jarifalamclaude-max/DUBURI_IVC/sim/results/rx_spectrogram.png

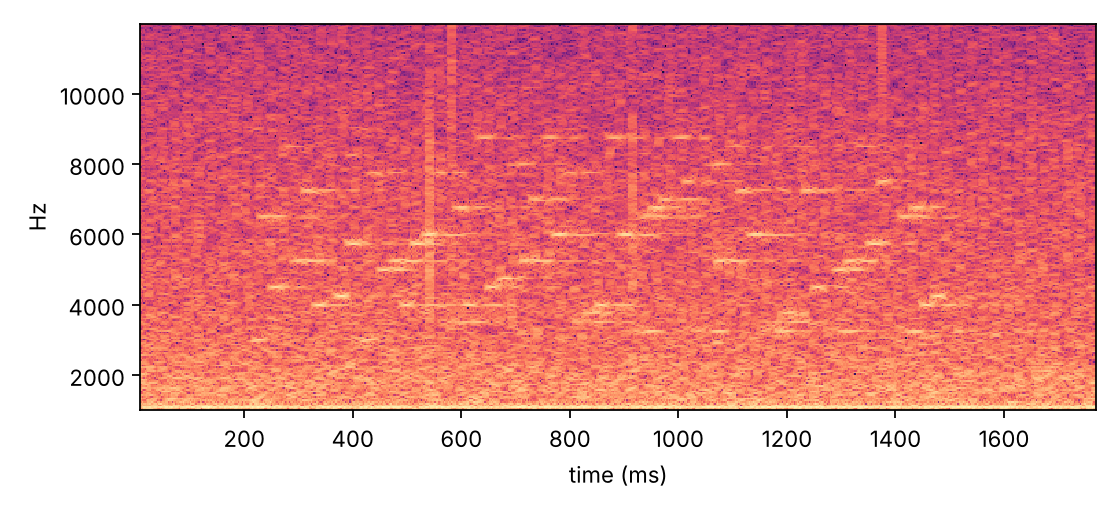
sim/results/rx_spectrogram.png
