jarifalamclaude-max/DUBURI_IVC/docs/guide_bn.html

DUBURI IVC

পানির নিচে দুই ROV-এর মধ্যে শব্দ দিয়ে যোগাযোগ

Acoustic Inter-Vehicle Communication: পুরো গাইড, A থেকে Z.
কেন এভাবে করা হলো, সব formula, circuit, speaker গরম হওয়ার কারণ ও সমাধান, piezo hydrophone seal করার নিয়ম, pool-এর noise filtering, ESP32-এর পুরো code আর তার ব্যাখ্যা, test করার নিয়ম আর সমস্যা হলে কী করবে।

Hardware: ESP32 + PAM8403 class-D amp + car speaker (TX) | piezo disc + op-amp preamp (RX)
Firmware: Arduino-ESP32 core 3.x (3.3.12-এ compile করে দেখা)
সব code: github.com/jarifalamclaude-max/DUBURI_IVC

## সূচিপত্র

1 এক নজরে পুরো সিস্টেম

2 পানিতে শব্দ: যা জানা দরকার

3 সিস্টেমের block diagram

4 কী কী লাগবে (BOM ও আনুমানিক দাম)

5 Power supply ও grounding

6 Transmitter circuit (ESP32 → amp → speaker)

7 Speaker গরম হচ্ছে কেন, আর সমাধান

8 Speaker box: পানিতে শব্দ বের করা

9 Piezo hydrophone: বানানো ও seal করা

10 Receiver preamp circuit

11 Noise filtering: তিন স্তর

12 Signal design: tone, slot, hopping

13 Packet, CRC, error correction

14 Receiver কীভাবে decode করে (ধাপে ধাপে)

15 Firmware: install, upload, ব্যবহার

16 Code-এর ব্যাখ্যা (function ধরে ধরে)

17 Verification: কী test করা হয়েছে

18 বানানো ও test করার ধাপ

19 Troubleshooting

20 Safety

A সব formula এক জায়গায়

B শব্দকোষ (Glossary)

C পুরো source code

## 1. এক নজরে পুরো সিস্টেম

একটা ROV (sender) একটা ছোট "packet" পাঠায়। Packet মানে কয়েকটা byte: কাকে পাঠাচ্ছি, কে পাঠাচ্ছে, কোন command (যেমন "LED জ্বালাও"), আর command-এর একটা argument। ESP32 এই byte-গুলোকে কিছু নির্দিষ্ট frequency-র শব্দ (tone)-এ রূপান্তর করে। Car speaker সেই শব্দ পানিতে ছাড়ে। অন্য ROV-এর piezo hydrophone শব্দটা শোনে, preamp signal বড় ও পরিষ্কার করে, ESP32-এর ADC সেটা digital করে। তারপর firmware বের করে কোন tone বেজেছিল, সেখান থেকে byte ফিরিয়ে আনে, CRC দিয়ে যাচাই করে, তারপর কাজটা করে (LED জ্বলে)। চাইলে উল্টো দিকে একটা ছোট "ACK" (পেয়েছি) packet ফেরত পাঠায়।

বিষয় | মান | কেন
Modulation | 4-FSK + frequency hopping | সহজ, amplitude-এর উপর নির্ভর করে না, echo-র মধ্যেও কাজ করে
Tone | 24টা, 3000–8750 Hz, 250 Hz পরপর | car speaker ও piezo এই band-এ ভালো কাজ করে; pump noise (নিচে) আর RoboSub pinger (25–40 kHz) এড়ায়
Slot | 20 ms, প্রতি slot-এ একটা tone = 2 bit | যথেষ্ট লম্বা যাতে echo-র মধ্যেও tone চেনা যায়
Packet দৈর্ঘ্য | 64 slot = 1.28 s (preamble 0.2 s + data 1.08 s) | command পাঠানোর জন্য যথেষ্ট দ্রুত
Payload | 4 byte (dst, src, seq+flags, cmd, arg) + CRC-16 | "LED on"-এর মতো command-এর জন্য যথেষ্ট
Error correction | Convolutional code K=7, rate 1/2 + Viterbi | যে bit ভুল আসে সেগুলো ঠিক করে ফেলে
Receiver ADC | ESP32 ADC1, DMA, 50 kHz | কোনো CPU সময় নষ্ট না করে sample নেয়
দূরত্ব (লক্ষ্য) | 10–25 m, RoboSub-এর মতো pool | —
Simulation-এ ফল | in-band SNR −6 dB-এ 90%, 0 dB-এ 100% packet ঠিক | অধ্যায় 17

Speaker গরম হওয়ার সংক্ষিপ্ত উত্তর (বিস্তারিত অধ্যায় 7): transistor বা L298N দিয়ে speaker-এর এক মাথা GND-এ রেখে on/off করলে অর্ধেক power DC হয়ে যায়। এতে শব্দ হয় না, শুধু coil গরম হয়। সমাধান হলো BTL class-D amplifier (PAM8403), amp-এর input-এ filter আর volume control, আর firmware-এর "heat guard" যা speaker-কে কাজের পর বিশ্রাম দেয়।

Piezo seal করলে শব্দ ধরবে কি না (বিস্তারিত অধ্যায় 9): ধরবে। Epoxy, silicone, তেল, এদের "acoustic impedance" পানির কাছাকাছি, তাই শব্দ প্রায় পুরোটাই ভেতরে ঢোকে (৮৫–৯৯%)। শব্দ আটকায় শুধু বাতাস (০.১%-এর মতো ঢোকে)। তাই নিয়ম একটাই: piezo আর পানির মাঝে কোনো air bubble বা ফাঁকা জায়গা থাকবে না।

## 2. পানিতে শব্দ: যা জানা দরকার

### 2.1 Radio কেন চলে না, শব্দ কেন চলে

পানি, বিশেষ করে chlorine দেওয়া pool-এর পানি, বিদ্যুৎ পরিবাহী। তাই WiFi বা Bluetooth-এর মতো radio wave কয়েক সেন্টিমিটারের মধ্যেই শেষ হয়ে যায়। শব্দ উল্টো: পানিতে বাতাসের চেয়ে প্রায় ৪.৫ গুণ দ্রুত যায় আর অনেক কম ক্ষয় হয়। তাই পানির নিচে যোগাযোগের প্রধান উপায় হলো শব্দ (acoustic)।

c ≈ 1480 – 1500 m/s (পানিতে শব্দের গতি; বাতাসে 343 m/s) λ = c / f λ = wavelength। উদাহরণ: f = 5000 Hz হলে λ = 1480/5000 ≈ 0.30 m। এই সংখ্যাটা পরে লাগবে। যেকোনো জিনিস λ-এর তুলনায় অনেক পাতলা হলে (যেমন 2–3 mm epoxy) শব্দ সেটা প্রায় টেরই পায় না।

t = d / c শব্দ পৌঁছাতে কত সময় লাগে। 25 m হলে t = 25/1480 ≈ 17 ms। এটা একটা slot (20 ms)-এর চেয়ে কম, কিন্তু pool-এর দেয়ালে ধাক্কা খেয়ে আসা echo আসে আরো অনেক পরে (৫০–৩০০ ms পর্যন্ত)।

### 2.2 Pool-এর সবচেয়ে বড় সমস্যা: echo (reverberation)

Pool-এর দেয়াল আর মেঝে টাইলস বা কংক্রিটের, আর পানির উপরিতল প্রায় আয়নার মতো শব্দ ফেরত দেয়। তাই একটা tone বাজালে receiver সেটা একবার না, শত শত বার শোনে, প্রতিটা আলাদা দেরিতে আর আলাদা phase-এ। দুটো খারাপ ফল হয়:

1. Fading: কোনো জায়গায় কোনো একটা frequency-র echo-গুলো একে অপরকে কেটে দেয়, ফলে সেই tone খুব দুর্বল শোনায়। অন্য frequency আবার ঠিক থাকে।
2. Inter-symbol interference: আগের slot-এর tone-এর echo পরের slot-এও বাজতে থাকে।

আমাদের design-এর প্রায় প্রতিটা সিদ্ধান্ত এই দুটো সমস্যা ঠেকানোর জন্য: frequency hopping (অধ্যায় 12), interleaving আর convolutional code (অধ্যায় 13)। নিচের চিত্রে simulation-এর pool model-এ echo-র শক্তি কত দ্রুত কমে, সেটা দেখানো হয়েছে।



চিত্র 2.1: 50×25×5 m pool model-এ echo-র অবশিষ্ট শক্তি। একই frequency set আবার ব্যবহার করার আগে 120 ms অপেক্ষা করা হয়, ততক্ষণে echo অনেকটা কমে যায়।

### 2.3 RoboSub-এ বিশেষ সতর্কতা

RoboSub-এ acoustic pinger থাকে, যার frequency সাধারণত 25–40 kHz। আমাদের tone 3–8.75 kHz, অর্থাৎ অনেক নিচে। তার উপর ADC-র sampling rate 50 kHz নেওয়া হয়েছে যাতে pinger-এর শব্দ "alias" হয়ে আমাদের band-এ ঢুকে না পড়ে (অধ্যায় 11.2-এ formula)। Thruster আর pool pump-এর বেশিরভাগ শব্দ 2–3 kHz-এর নিচে থাকে, তাই আমাদের band সেটাও এড়িয়ে যায়।

### 2.4 Doppler: ROV চললে frequency সরে কি?

Δf = f · v / c v = দুই ROV-এর আপেক্ষিক গতি। v = 0.5 m/s আর f = 8750 Hz হলে Δf = 8750 × 0.5 / 1480 ≈ 3 Hz। আমাদের receiver-এর frequency resolution 62.5 Hz আর tone 250 Hz পরপর, তাই 3 Hz কোনো সমস্যা না।

## 3. সিস্টেমের block diagram

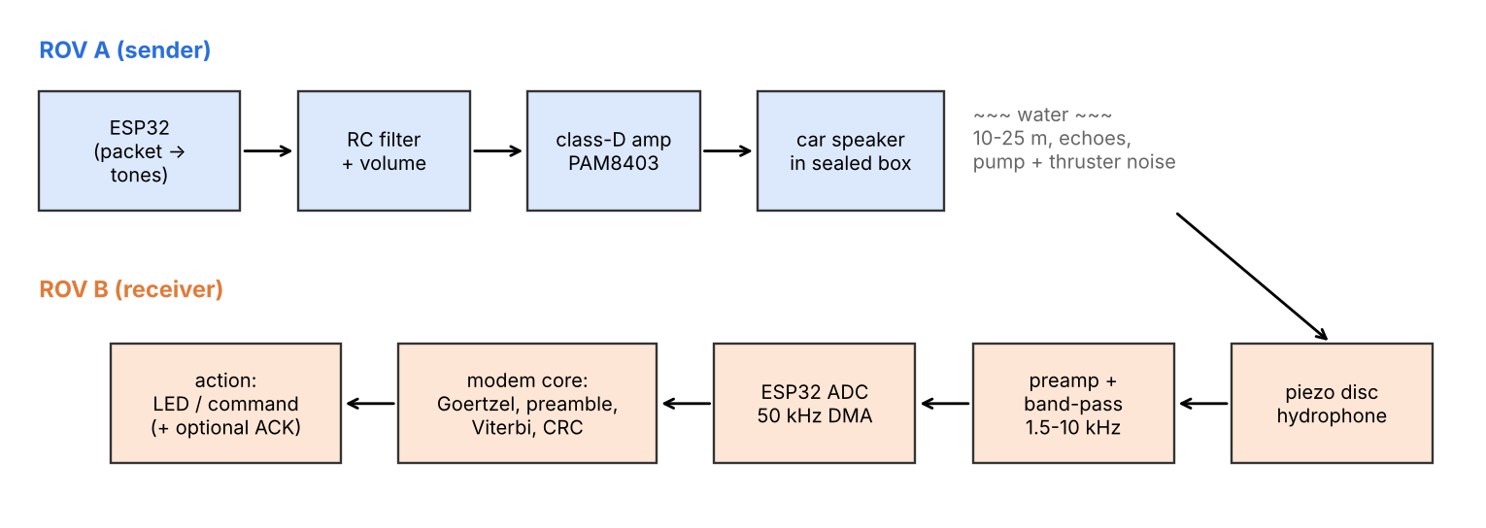
[picture p2: docs/figures/block_diagram.png]


চিত্র 3.1: উপরে sender, নিচে receiver। দুই ROV-এ একই hardware থাকলে দুজনেই পাঠাতে ও শুনতে পারে (ACK-এর জন্য)।

Sender-এর কাজ: packet → bit → error-correction code → interleave → প্রতি 2 bit-এ একটা tone → ESP32-এর LEDC peripheral দিয়ে square wave → RC filter দিয়ে মসৃণ করা ও volume ঠিক করা → PAM8403 amp → speaker → box-এর পাতলা জানালা → পানি।

Receiver-এর কাজ: piezo → preamp (gain + 1.5–10 kHz band-pass) → ESP32 ADC (DMA, 50 kHz) → DC সরানো → Goertzel দিয়ে 24টা tone-এর শক্তি মাপা → noise floor দিয়ে ভাগ (whitening) → preamble খোঁজা → timing ঠিক করা → প্রতি slot-এর soft bit → de-interleave → Viterbi → CRC check → command চালানো।

একটা গুরুত্বপূর্ণ design সিদ্ধান্ত: modem-এর মূল code (am_core.c) সাধারণ C-তে লেখা, এতে ESP32-এর কিছু নেই। তাই একই file PC-তে compile করে test আর simulation চালানো গেছে। PC-তে যেটা test হয়েছে, ঠিক সেটাই ROV-এ চলে।

## 4. কী কী লাগবে (BOM ও আনুমানিক দাম)

প্রতিটা ROV-এর জন্য (দুটো ROV-এ দুই সেট)। দাম বাংলাদেশের সাধারণ অনলাইন বা দোকানের আনুমানিক দাম, দোকানভেদে কমবেশি হবে।

জিনিস | সংখ্যা | আনুমানিক দাম (৳) | মন্তব্য
ESP32 DevKit V1 (WROOM-32) | 1 | 450–650 | Uno-র চেয়ে সস্তা, অনেক দ্রুত, DMA ADC আছে
PAM8403 class-D amp module | 1 | 60–120 | 5 V, 3 W×2, BTL output
(বিকল্প) PAM8610 amp module | (1) | 250–400 | 12 V, বেশি জোর লাগলে; heat sink লাগবে
Car speaker (আছে) | 1 | — | 4 Ω
Piezo disc 27 mm বা 35 mm | 2–3 | 10–20 প্রতিটা | একটা নষ্ট হলে বদলানোর জন্য বাড়তি রাখো
MCP6002 op-amp (না পেলে LM358) | 1 | 40–80 (LM358: 10–15) | dual op-amp, DIP-8
Buck converter (LM2596 বা MP1584) | 2 | 80–150 প্রতিটা | একটা ESP32-এর, একটা amp-এর
Trimmer pot 10 kΩ, 100 kΩ | 1 + 1 | 10–20 প্রতিটা | volume ও gain
Resistor, capacitor (তালিকা অধ্যায় 6, 10) | — | 100–150 | film/ceramic cap
Shielded cable (2-core বা mic cable) | 1–2 m | 30–60/m | hydrophone-এর জন্য
2-part epoxy বা liquid electrical tape | 1 | 150–300 | piezo seal
Acrylic sheet 3–5 mm (speaker জানালা) | ছোট টুকরা | 100–200 | অধ্যায় 8
Perfboard, header, fuse, তার | — | 100–150 | —

কেন Uno না: Uno-র RAM 2 KB, clock 16 MHz, ADC দ্রুত হলে noisy হয়, আর DMA নেই। ESP32-এ 520 KB RAM, 240 MHz, float FPU আর DMA দিয়ে 50 kHz ADC sampling আছে, আর দামও Uno clone-এর মতো বা কম। আমাদের receiver প্রতি সেকেন্ডে প্রায় ৮০ লাখ গুণ-যোগ করে, যা Uno-তে সম্ভব না।

## 5. Power supply ও grounding



চিত্র 5.1: দুটো আলাদা buck converter। Amp-এর supply-তে ferrite/inductor আর 1000 µF।

- দুটো buck কেন: amp প্রতিবার tone বাজানোর সময় হঠাৎ ১ A-এর মতো current টানে। একই 5 V থেকে ESP32 চললে voltage নেমে ESP32 reset হতে পারে (brownout), আর preamp-এ শব্দ (noise) ঢোকে।
- Ferrite + 1000 µF: একটা LC low-pass filter। Amp-এর switching noise buck-এ ফিরতে দেয় না, আর হঠাৎ current-এর সময় capacitor থেকে charge যোগায়।
- Star ground: সব GND তার একটা বিন্দুতে (battery −) মিলবে। Thruster-এর বড় current যেন preamp-এর GND তারের মধ্য দিয়ে না যায়।
- Preamp-এর supply: ESP32-এর 3V3 থেকে 10 Ω + 100 µF দিয়ে আলাদা করে "3V3A" (অধ্যায় 10)।

I_battery ≈ P_out / (η · V_battery) Buck converter-এর input current। η = efficiency (≈ 0.85)। উদাহরণ: amp 5 V-এ 1 A টানলে (5 W), 14.8 V battery থেকে লাগে 5 / (0.85 × 14.8) ≈ 0.4 A। তাই 3 A fuse যথেষ্ট।

f_LC = 1 / (2π √(L·C)) 10 µH আর 1000 µF হলে f ≈ 1.6 kHz। এর উপরের buck switching noise (সাধারণত 150 kHz+) অনেকটা কেটে যায়।

## 6. Transmitter circuit (ESP32 → amp → speaker)



চিত্র 6.1: Transmitter। ESP32-এর GPIO25 থেকে square wave → RC filter → volume → PAM8403 → speaker।

### 6.1 প্রতিটা অংশ কী করে

- GPIO25 (LEDC): ESP32-এর LEDC peripheral hardware দিয়েই নির্দিষ্ট frequency-র square wave বানায় (0 V আর 3.3 V-এর মধ্যে)। CPU কিছু করে না, তাই tone একদম স্থির থাকে। প্রতি 20 ms পরপর firmware শুধু frequency বদলে দেয়।
- R1 + C1 (low-pass filter): square wave-এর ধারালো কিনারা কেটে নরম করে, উঁচু harmonic কমায়।
- C2 (1 µF): DC আটকায়। Amp শুধু AC পায়, এটা heat কমানোর জন্যও জরুরি (অধ্যায় 7)।
- RV1 (10 kΩ trimmer): volume। ESP32-এর 2.1 V peak signal amp-এর জন্য অনেক বেশি, ফলে amp clip করত। Clip মানে output square wave, যা বেশি গরম করে।
- PAM8403: class-D, BTL (bridge-tied load) amp, ~৯০% efficient। নিজে প্রায় গরম হয় না।

### 6.2 Formula ও হিসাব

square wave (0…V) = V/2 + (2V/π)·[sin ωt + (1/3)sin 3ωt + (1/5)sin 5ωt + …] Fourier series। প্রথম অংশ V/2 হলো DC। আসল tone (fundamental)-এর amplitude 2V/π; ESP32-এ V = 3.3 V হলে 2.10 V peak। শুধু বিজোড় harmonic (3f, 5f, …) থাকে। আমাদের সবচেয়ে নিচের tone 3000 Hz-এর 3f = 9000 Hz, যা সবচেয়ে উঁচু tone 8750 Hz-এর উপরে। তাই harmonic কখনো অন্য tone-এর জায়গায় পড়ে না।

f_c = 1 / (2π · R_th · C1), R_th = R1 ∥ RV1 = (4.7k × 10k)/(4.7k + 10k) = 3.2 kΩ f_c = 1 / (2π × 3.2 kΩ × 3.3 nF) ≈ 15 kHz Low-pass corner। 15 kHz-এর নিচের (আমাদের tone) প্রায় পুরোটা যায়, উপরের harmonic কমে।

gain_divider = RV1 / (R1 + RV1) = 10 / 14.7 = 0.68 → RV1-এর মাথায় 2.10 × 0.68 ≈ 1.43 V peak f_HP = 1 / (2π (R1 + RV1) C2) = 1 / (2π × 14.7 kΩ × 1 µF) ≈ 11 Hz C2 শুধু DC আটকায়। 11 Hz-এর উপরের সব কিছু (আমাদের tone) সহজে যায়।

PAM8403 gain ≈ 24 dB = ×15.8, BTL max peak ≈ V_supply = 5 V P_sine = V_peak² / (2 R) = 5² / (2 × 4) ≈ 3.1 W (clip হওয়ার ঠিক আগে) V_in দরকার = V_out / gain = 4 V / 15.8 ≈ 0.25 V peak → RV1 প্রায় 18% ঘুরানো তাই RV1 একদম নিচ থেকে শুরু করবে, আস্তে আস্তে বাড়াবে। যেখানে শব্দ আর বাড়ে না, বরং কর্কশ হয়, সেখানে clip শুরু; তার একটু নিচে রাখবে। 4 V peak হলে 4²/(2×4) = 2 W।

BTL সতর্কতা: PAM8403/PAM8610-এর output-এর দুই পাশেই signal থাকে (একটা উঠলে অন্যটা নামে)। Speaker-এর কোনো তার কখনো GND-এ লাগাবে না, আর দুটো channel-এর OUT− একসাথে জোড়া দেবে না। দিলে amp-এর output short হয়ে amp গরম হবে বা পুড়ে যাবে। Speaker-এর দুই তার শুধু L+ আর L−-এ যাবে।

### 6.3 বেশি জোর লাগলে: PAM8610

PAM8403 যথেষ্ট না হলে (scope-এ q < 10 dB, অধ্যায় 18) PAM8610 module 12 V buck থেকে চালাও। এতে 12 V BTL, অর্থাৎ max ≈ 12²/(2×4) = 18 W (তাত্ত্বিক)। কিন্তু মনে রাখো, power বাড়লে heat-ও বাড়ে। প্রথমে gain বাড়াও, transducer coupling ঠিক করো (অধ্যায় 8), তারপর power। PAM8610-এ heat sink লাগাবে। Module-এ MUTE/SD pin থাকলে PIN_AMP_ENABLE দিয়ে ESP32 শুধু পাঠানোর সময় amp চালু রাখবে।

## 7. Speaker গরম হচ্ছে কেন, আর সমাধান

Speaker-এর voice coil আসলে একটা তামার তারের কুণ্ডলী, যার resistance R (car speaker-এ ~3.2–4 Ω)। Coil-এ যত electrical power যায়, তার প্রায় পুরোটাই (৯৯%-এর বেশি) তাপ হয়। শব্দ হয় খুব সামান্য (speaker-এর efficiency ~১%)। তাই প্রশ্ন হলো, coil-এ অদরকারি power কোথা থেকে আসছে।

### 7.1 কারণ 1 (সবচেয়ে সাধারণ): DC current

অনেকে speaker-এর এক মাথা GND-এ রেখে transistor/MOSFET বা L298N-এর এক অংশ দিয়ে 0 আর V-এর মধ্যে on/off করে। এই signal-এর গড় মান V/2, মানে coil-এ একটা স্থায়ী DC current চলে। DC-তে cone একপাশে ঠেলে থেমে থাকে, কোনো শব্দ হয় না, কিন্তু I²R তাপ হয়।

P_total = d · V² / R (d = duty cycle = 0.5) P_DC = (d·V)² / R ← শুধু তাপ, কোনো শব্দ নয় P_tone = (2V/π)² / (2R) ← কাজের অংশ 12 V, 4 Ω হলে P_total = 0.5 × 144 / 4 = 18 W, P_DC = 36/4 = 9 W, P_tone = 7.3 W, বাকি 1.7 W harmonic। অর্থাৎ অর্ধেক power সরাসরি তাপ। Box বন্ধ থাকলে এই তাপ বের হওয়ারও জায়গা পায় না।

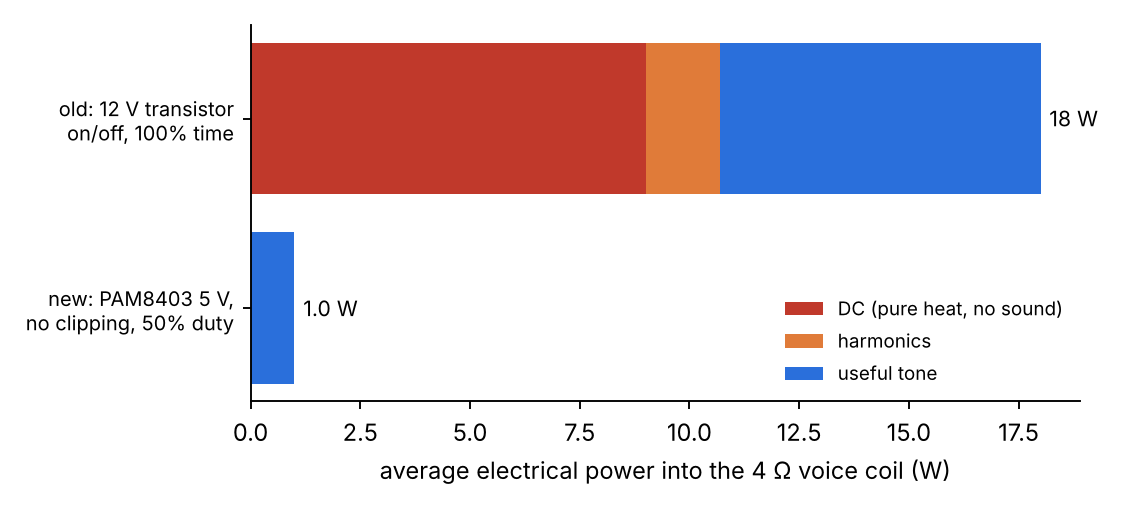
[picture p3: docs/figures/heat_power.png]


চিত্র 7.1: পুরনো পদ্ধতি বনাম নতুন। নতুন পদ্ধতিতে গড় power প্রায় ১৮ ভাগের এক ভাগ।

### 7.2 কারণ 2: সারাক্ষণ বাজানো (100% duty)

Tone একটানা বাজালে coil ঠান্ডা হওয়ার সময় পায় না। আমাদের packet মাত্র 1.28 s। Firmware-এর heat guard প্রতিবার পাঠানোর পর বাধ্যতামূলক বিশ্রাম দেয়:

t_rest = t_on · (1 − d) / d P_avg = P_on · d d = MAX_TX_DUTY (config.h, default 0.5)। 1.28 s packet-এর পর অন্তত 1.28 s চুপ। P_on = 2 W হলে গড় 1 W। Speaker-এর rating সাধারণত 20–50 W, তাই এটা খুবই নিরাপদ।

### 7.3 কারণ 3: Amp clip করা

Input বেশি হলে amp-এর output square হয়ে যায় (clipping)। একই peak voltage-এ square wave-এর power sine-এর দ্বিগুণ (V²/R বনাম V²/2R), আর বাড়তি অংশটা harmonic, যা কাজে লাগে না। RV1 দিয়ে clip-এর নিচে রাখো।

### 7.4 কারণ 4: ভুল driver

L298N-এর ভেতরে transistor-এ 2–3 V voltage drop হয়। 1.5 A-তে সেটা 3–4.5 W, যা শুধু L298N-কে গরম করে। সাথে চলে উপরের DC সমস্যা। Class-D amp-এর efficiency ~৯০%, তাই এই সমস্যা থাকে না।

### 7.5 কারণ 5: বন্ধ box, তাপ বের হওয়ার পথ নেই

ΔT = P_avg × R_th R_th = thermal resistance (°C/W): প্রতি watt-এ তাপমাত্রা কত বাড়ে। বাতাস ভালো insulator, তাই বন্ধ box-এ R_th অনেক বেশি। উদাহরণ (ধরে নেওয়া মান): R_th = 10 °C/W হলে পুরনো পদ্ধতির 9 W DC → 90 °C বেশি! নতুন পদ্ধতির 1 W → 10 °C। সমাধান: speaker-এর magnet থেকে একটা aluminium পাত box-এর দেয়াল পর্যন্ত লাগাও (চিত্র 8.1)। দেয়ালের ওপাশে পানি খুব ভালো ঠান্ডা করে।

### 7.6 Coil-এর তাপমাত্রা নিজে মাপার উপায়

R(T) = R₀ (1 + α ΔT), α_copper = 0.00393 /°C ΔT = (R_hot / R_cold − 1) / 0.00393 Multimeter দিয়ে speaker-এর resistance ঠান্ডা অবস্থায় মাপো (ধরো 3.4 Ω)। কিছুক্ষণ চালিয়ে amp খুলে সাথে সাথে আবার মাপো (ধরো 4.1 Ω)। তাহলে ΔT = (4.1/3.4 − 1)/0.00393 ≈ 52 °C। 60–70 °C-এর বেশি বাড়লে MAX_TX_DUTY বা volume কমাও।

Checklist: (1) class-D BTL amp, speaker GND-এ নয়; (2) C2 দিয়ে DC block; (3) RV1-এ clip-এর নিচে; (4) MAX_TX_DUTY 0.5 বা কম; (5) magnet থেকে দেয়ালে তাপের পথ; (6) R মেপে তাপমাত্রা দেখা।

## 8. Speaker box: পানিতে শব্দ বের করা

Speaker বন্ধ box-এ আছে। Cone নড়লে box-এর ভেতরের বাতাস নড়ে, বাতাস box-এর দেয়াল নাড়ায়, দেয়াল পানি নাড়ায়। বাতাস আর পানির মধ্যে impedance-এর বিশাল পার্থক্য (অধ্যায় 9.1), তাই এখানেই সবচেয়ে বেশি শক্তি হারায়। উপায় হলো দেয়ালের একটা অংশকে হালকা ও পাতলা "জানালা" বানানো, যা নিজে drum-এর মতো কাঁপে।

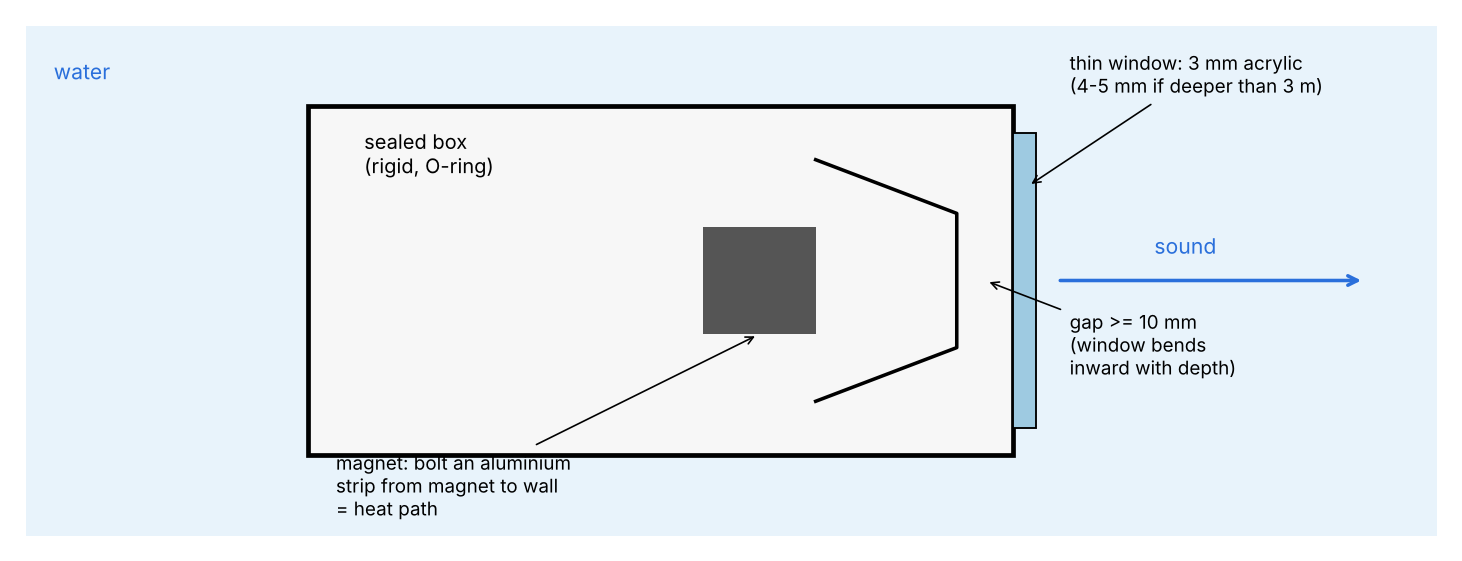
[picture p4: docs/figures/speaker_box.png]


চিত্র 8.1: Speaker-এর মুখ পাতলা acrylic জানালার দিকে, মাঝে ফাঁক, magnet থেকে দেয়াল পর্যন্ত তাপের পথ।

- Speaker-এর মুখ একটা পাতলা, শক্ত জানালার দিকে রাখো (3 mm acrylic/polycarbonate)। জানালা যত পাতলা আর হালকা, তত ভালো শব্দ যায়, কিন্তু গভীরতায় চাপ সহ্য করতে হবে (নিচের formula)।
- Cone আর জানালার মাঝে অন্তত 10 mm ফাঁক রাখো, কারণ গভীরে জানালা ভেতরে বাঁকে।
- Box-এর বাকি দেয়াল মোটা আর শক্ত রাখো, O-ring দিয়ে seal করো।
- (Advanced) পুরো box তেলে ভরে rubber diaphragm দিলে coupling আর cooling দুটোই অনেক ভালো হয়। কিন্তু এটা বানানো কঠিন, তেল চুঁইয়ে পড়ার ঝুঁকি আছে, আর cone তেলে ভিজে যায়। প্রথম version-এ এটা কোরো না।
- (বিকল্প পরীক্ষা) একটা piezo disc-কেও speaker হিসেবে চালানো যায় (amp-এর output সরাসরি piezo-তে)। 3–6 kHz-এ পানিতে এটা ভালো কাজ করে। Car speaker-এর সাথে তুলনা করতে পারো।

### 8.1 গভীরতায় চাপ ও জানালার পুরুত্ব

P = ρ · g · h 5 m গভীরে P = 1000 × 9.81 × 5 ≈ 49 kPa (≈ 0.49 bar)। জানালার প্রতি বর্গ সেন্টিমিটারে প্রায় 0.5 kg-এর ভার।

D = E t³ / (12 (1 − ν²)) w_max = P a⁴ / (64 D) (কিনারা আটকানো গোল plate-এর মাঝখানে কতটা বাঁকে) σ_max = 3 P a² / (4 t²) (সবচেয়ে বেশি stress, কিনারায়) a = জানালার ব্যাসার্ধ, t = পুরুত্ব। Acrylic: E ≈ 3 GPa, ν ≈ 0.37, tensile strength ≈ 70 MPa।
উদাহরণ, 5 m গভীরে: 10 cm জানালা (a = 5 cm), t = 3 mm → w ≈ 0.6 mm, σ ≈ 10 MPa (safety factor ≈ 7) ✔।
15 cm জানালা (a = 7.5 cm), t = 3 mm → w ≈ 3.1 mm, σ ≈ 23 MPa (safety factor ≈ 3, একটু বেশি বাঁকে)। t = 5 mm হলে w ≈ 0.7 mm, σ ≈ 8 MPa ✔। তাই 3 m-এর বেশি গভীরে বড় জানালার জন্য 4–5 mm নাও। এগুলো মোটামুটি হিসাব (ছোট deflection ধরে), পানিতে নামানোর আগে বালতি বা অগভীর পানিতে leak test করবে।

## 9. Piezo hydrophone: বানানো ও seal করা

### 9.1 Seal করলে শব্দ ঢুকবে কেন (physics)

শব্দ হলো চাপের ঢেউ। এক পদার্থ থেকে অন্য পদার্থে ঢোকার সময় কতটা ঢুকবে আর কতটা ফেরত যাবে, সেটা নির্ভর করে দুই পদার্থের acoustic impedance-এর উপর:

Z = ρ · c (ঘনত্ব × শব্দের গতি, একক Rayl) T = 4 Z₁ Z₂ / (Z₁ + Z₂)² (কত ভাগ শক্তি ঢোকে) পানি Z ≈ 1.48 MRayl। Epoxy ≈ 3.0 → T ≈ 0.89 (৮৯% ঢোকে)। Silicone rubber ≈ 1.05 → T ≈ 0.97। Mineral/baby oil ≈ 1.2 → T ≈ 0.99। বাতাস ≈ 0.0004 → T ≈ 0.001 (০.১%!)।
তাই কোটিং কোনো সমস্যা না, সমস্যা শুধু বাতাস। আর কোটিং যেহেতু wavelength (5 kHz-এ 300 mm)-এর তুলনায় খুব পাতলা (2–3 mm), শব্দ তার মধ্য দিয়ে প্রায় না থেমে চলে যায়।

### 9.2 Piezo disc কীভাবে শব্দ ধরে

Piezo disc-এ একটা পিতলের (brass) প্লেটের উপর পাতলা ceramic লাগানো থাকে। চাপ পড়ে ceramic একটু বাঁকলে তার দুই পাশে voltage তৈরি হয় (piezoelectric effect)। পানির চাপের ঢেউ disc-কে বাঁকায়, তাই disc থেকে millivolt মাপের signal আসে। Disc বৈদ্যুতিকভাবে একটা ছোট capacitor-এর মতো (প্রায় 10–30 nF), তাই এর পরে high-impedance input (1 MΩ) লাগে।

### 9.3 বানানোর ধাপ

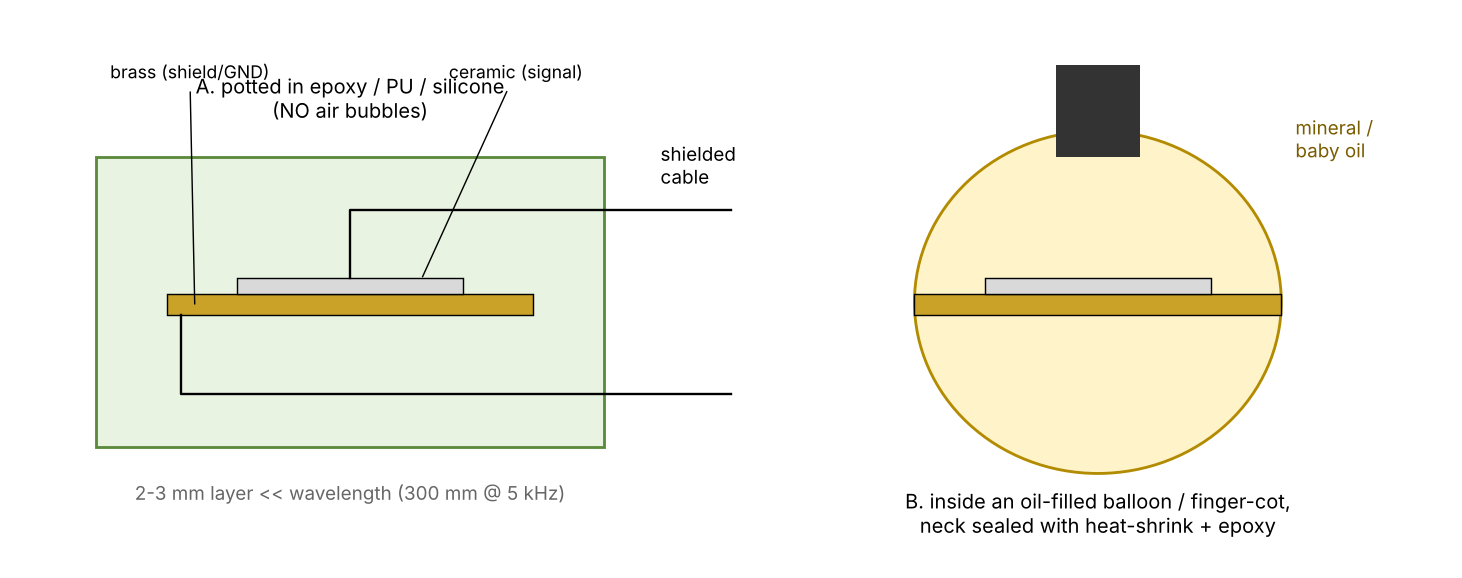
[picture p5: docs/figures/hydrophone_build.png]


চিত্র 9.1: দুটো পদ্ধতি। A: epoxy/silicone-এ ডুবানো (potting)। B: তেলভর্তি balloon/finger-cot।

1. Cable: shielded cable (mic cable)। ভেতরের তার ceramic (রুপালি) অংশে, shield/braid brass-এর কিনারায়। Ceramic-এ খুব দ্রুত (২–৩ সেকেন্ড) solder করো, বেশি তাপে রুপালি স্তর উঠে যায়।
2. পরিষ্কার: isopropyl alcohol দিয়ে তেল আর flux মুছে ফেলো, শুকাতে দাও।
3. Strain relief: cable-কে disc-এর কাছে একটু গিঁট দিয়ে বা heat-shrink দিয়ে আটকে দাও, যাতে টান solder-এ না পড়ে।
4. পদ্ধতি A (epoxy/silicone potting): একটা ছোট ছাঁচে (বোতলের ছিপি, PVC end cap) disc দাঁড় করিয়ে রাখো। 2-part epoxy ধীরে ধীরে এক কোণ থেকে ঢালো, যাতে বাতাস বের হয়ে যেতে পারে। Disc-এর দুই পাশে 2–3 mm স্তর রাখো। Bubble দেখলে টুথপিক দিয়ে ফাটিয়ে দাও। হালকা গরম জায়গায় (hair dryer দূর থেকে) রাখলে epoxy পাতলা হয় আর bubble সহজে ওঠে। পুরো ২৪ ঘণ্টা শুকাতে দাও। সস্তা বিকল্প: liquid electrical tape / Plasti Dip-এ ৩–৪ বার ডুবিয়ে পাতলা স্তর, প্রতিবার শুকিয়ে নিয়ে। Hot glue-ও চলে, কিন্তু bubble থাকার সম্ভাবনা বেশি।
5. পদ্ধতি B (তেল): finger-cot বা ছোট balloon-এ baby/mineral oil ভরে disc ডোবাও। Bubble বের করে দাও, তারপর মুখটা cable-এর উপর heat-shrink + epoxy দিয়ে বন্ধ করো। তেল খুব ভালো impedance match, আর disc-এর উপর কোনো শক্ত স্তর না থাকায় disc সবচেয়ে ভালো বাঁকে।
6. Cable-এর মুখ seal: cable যেখানে বের হচ্ছে সেখানে epoxy বা adhesive heat-shrink, যাতে পানি তারের ভেতর দিয়ে না ঢোকে।
7. পরীক্ষা: বালতির পানিতে রেখে বালতির গায়ে টোকা দাও, firmware-এর scope-এ level লাফালে ঠিক আছে। একদিন পানিতে রেখে দেখো multimeter-এ disc-এর দুই তারের মধ্যে resistance অসীম আছে কি না (leak নেই)।

Mounting: hydrophone-কে ROV-এর frame থেকে নরম রাবার বা foam দিয়ে আলাদা করে লাগাও, thruster থেকে যত দূরে সম্ভব। Frame-এর মধ্য দিয়ে motor-এর কম্পন সরাসরি piezo-তে গেলে noise অনেক বাড়ে। নিজের speaker-এর box থেকেও দূরে রাখো।

"Speaker-এর receiver"-এর ব্যাপারে: একটা speaker-কেও উল্টো দিকে microphone হিসেবে ব্যবহার করা যায়, কিন্তু বন্ধ box-এর ভেতরে থাকলে পানির শব্দ খুব কম পৌঁছায় (বাতাসের ফাঁকের কারণে, 9.1)। Piezo সরাসরি পানির সংস্পর্শে থাকে, তাই অনেক ভালো। Receiver হিসেবে piezo-ই ব্যবহার করো।

## 10. Receiver preamp circuit



চিত্র 10.1: দুই stage-এর non-inverting band-pass amplifier, তারপর anti-alias RC, তারপর ESP32 GPIO34।



চিত্র 10.2: Preamp-এর পরিষ্কার supply (3V3A) আর VREF (≈1.34 V)।

### 10.1 কেন এই circuit

- Piezo-র signal খুব ছোট (mV)। ESP32-এর ADC-তে ভালো করে মাপতে হলে কয়েকশো mV লাগে। তাই মোট gain 30–63 dB (৩০ থেকে ১৪০০ গুণ)।
- Single supply (শুধু 3.3 V) দিয়ে AC signal amplify করতে হলে signal-কে একটা মাঝামাঝি voltage (VREF)-এর উপর বসাতে হয়, যাতে signal উপরে-নিচে দুই দিকেই দুলতে পারে। Rb (1 MΩ) সেটা করে।
- Rg-Cg দিয়ে DC gain = 1 রাখা হয়েছে, তাই output-এর DC = VREF থাকে, gain বাড়ালেও DC সরে না।
- প্রতি stage নিজেই band-pass: নিচে Cg (pump hum কাটে), উপরে Cf (pinger ও ESC noise কাটে)।
- Ro-Caa: ADC-র আগে শেষ low-pass (anti-alias), আর op-amp-কে ADC-র input থেকে রক্ষা করে।

### 10.2 Formula ও মান

VREF = 3.3 × 6.8k / (10k + 6.8k) = 1.34 V কেন 1.65 V (মাঝখান) না: ESP32 ADC (12 dB attenuation) প্রায় 0.15–2.45 V-এ সবচেয়ে সোজা (linear) মাপে। তার মাঝখান ≈ 1.3 V, দুই দিকে ±1.1 V জায়গা থাকে।

G = 1 + Rf / Rg (non-inverting gain) Stage 1: G₁ = 1 + 100k/3.3k = 31.3 (29.9 dB) Stage 2: G₂ = 1 + RV2/2.2k = 1 … 46.5 (0 … 33 dB, RV2 দিয়ে বদলানো যায়) মোট: 30 dB … 63 dB

f_HP = 1/(2π Rg Cg): stage 1 → 1/(2π·3.3k·33n) = 1.46 kHz; stage 2 → 1/(2π·2.2k·47n) = 1.54 kHz f_LP = 1/(2π Rf Cf): stage 1 → 1/(2π·100k·150p) = 10.6 kHz; stage 2 → 1/(2π·100k·100p) = 15.9 kHz (RV2 max) Anti-alias: 1/(2π·3.3k·4.7n) = 10.3 kHz Input HP: 1/(2π · Rb · (Cin ∥series C_piezo)) ≈ 10 Hz ফলে 3–8.75 kHz-এর tone পুরো gain পায়। 100 Hz pump hum প্রায় 45 dB কমে, 35 kHz pinger প্রায় 27 dB কমে (চিত্র 10.3)।

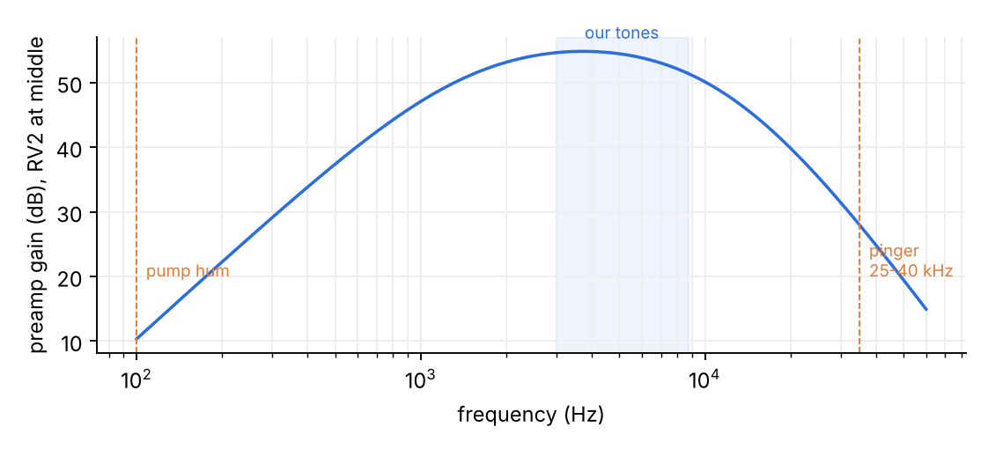
[picture p6: docs/figures/preamp_response.png]


চিত্র 10.3: Preamp-এর frequency response (RV2 মাঝামাঝি)। নীল অংশে আমাদের tone।

GBW ≥ G × f_max = 46.5 × 10 kHz ≈ 0.47 MHz Op-amp-এর gain-bandwidth product। MCP6002 = 1 MHz ✔। LM358 ≈ 0.7–1 MHz, চলবে।

### 10.3 Op-amp বাছাই ও pin

| MCP6002 (ভালো) | LM358 (বিকল্প)
Supply | 3V3A (3.3 V) | 5 V (3.3 V-এ output 1.8 V-এর উপরে উঠতে পারে না)
Output swing | rail-to-rail (0–3.3 V) | 0 থেকে Vcc−1.5 V
Pin | দুটোরই pin এক: 1 = OUT A, 2 = −IN A, 3 = +IN A, 4 = GND, 5 = +IN B, 6 = −IN B, 7 = OUT B, 8 = V+

LM358 5 V-এ চালালে output 3.5 V পর্যন্ত যেতে পারে। Ro (3.3 kΩ) current সীমিত রাখে, তাই ESP32-এর pin নিরাপদ থাকে। তবুও MCP6002 পেলে সেটাই ব্যবহার করো। Pin 8 আর pin 4-এর মধ্যে যত কাছে সম্ভব 100 nF লাগাও।

GPIO34 কেন: ESP32-এর DMA ADC শুধু ADC1-এ (GPIO32–39) কাজ করে। GPIO34 শুধু input pin, এতে কোনো internal pull-up নেই, তাই analog-এর জন্য একদম ঠিক।

## 11. Noise filtering: তিন স্তর

Noise-এর উৎস | কেমন | কোন স্তরে আটকায়
Pool pump/filter | নিচু frequency (<1–2 kHz), 100 Hz hum | Band choice + preamp HP
Thruster (প্রপেলার) | সব frequency জুড়ে, ঢেউয়ের মতো ওঠানামা | Narrowband Goertzel + whitening + code
ESC/motor whine | একটা নির্দিষ্ট tone (যেমন 8 kHz) | Per-tone noise floor (whitening)
টোকা, ধাক্কা (click) | খুব ছোট কিন্তু জোরালো | Interleaving + Viterbi
RoboSub pinger | 25–40 kHz, 4 ms pulse | Preamp LP + Fs = 50 kHz (alias বাইরে পড়ে)
Echo (reverberation) | নিজের signal-এর দেরিতে আসা কপি | Frequency hopping + interleaving + code
বিদ্যুতের noise (buck, ESC) | তারে ঢোকা | Shielded cable, star ground, আলাদা buck, LC filter

### 11.1 স্তর 1: Hardware

Preamp band-pass (অধ্যায় 10), anti-alias RC, shielded cable (shield শুধু preamp-এর GND-এ, এক প্রান্তে), আলাদা power, hydrophone-কে frame থেকে কম্পন-বিচ্ছিন্ন রাখা।

### 11.2 স্তর 2: Sampling আর aliasing

Fs > 2 · f_max (Nyquist) f_alias = | f − k · Fs | (k = সবচেয়ে কাছের পূর্ণসংখ্যা) ADC Fs-এর অর্ধেকের উপরের frequency ধরতে পারে না, সেগুলো ভুল করে নিচের frequency হিসেবে দেখা দেয় (alias)। Fs = 50 kHz হলে 35 kHz pinger → |35 − 50| = 15 kHz, আমাদের band (3–8.75 kHz)-এর বাইরে ✔। Fs = 40 kHz হলে একই pinger → 5 kHz, ঠিক আমাদের tone-এর উপর ✘। তাই 50 kHz বেছে নেওয়া হয়েছে। Band-এ alias হয়ে ঢুকতে পারে শুধু 41.25–47 kHz-এর শব্দ, যা preamp ~31–33 dB কমিয়ে দেয়।

### 11.3 স্তর 3: Software (DSP)

- Goertzel (narrowband filter): প্রতিটা tone-এর জন্য মাত্র ~94 Hz চওড়া একটা "জানালা" দিয়ে শোনে। 6 kHz band-এর noise-এর মাত্র 94/6000 ভাগ ঢোকে। এটাই processing gain:

PG = 10 log₁₀(B_band / B_bin) = 10 log₁₀(6000 / 94) ≈ 18 dB তাই wideband SNR −6 dB হলেও প্রতি tone-এ ~১০ dB SNR পাওয়া যায় (Hann window আর echo-র ক্ষতি বাদ দিয়ে)।

- Whitening (per-tone noise floor): প্রতিটা tone-এর জন্য আলাদা noise floor মনে রাখা হয়। কোনো tone-এর জায়গায় সবসময় একটা whine থাকলে সেই tone-এর floor বেড়ে যায়, তাই whine আর "জয়ী" হয় না (অধ্যায় 14.3)।
- Ratio-ভিত্তিক সিদ্ধান্ত: কোন tone বেজেছে, সেটা নির্ধারণ হয় চারটা tone-এর মধ্যে তুলনা করে, কোনো fixed threshold দিয়ে না। তাই signal জোরে বা আস্তে, যাই আসুক, কাজ করে।

### 11.4 স্তর 4: Protocol

- Frequency hopping: পরপর slot আলাদা frequency set ব্যবহার করে। ফলে আগের slot-এর echo পরের slot-এর হিসাবে ঢোকে না।
- Interleaving + convolutional code: একটা slot নষ্ট হলে বা একটা frequency fade করলে মাত্র কয়েকটা ছড়ানো bit ভুল হয়, Viterbi সেগুলো ঠিক করে ফেলে।
- CRC-16: ভুল packet প্রায় কখনো পাস করে না (৬৫৫৩৬-এ ১)।
- ACK + retry: উত্তর না এলে firmware নিজেই আবার পাঠায় (৩ বার পর্যন্ত)।

## 12. Signal design: tone, slot, hopping

### 12.1 Tone-এর তালিকা

f_k = 3000 + 250 · k Hz, k = 0 … 23 → 3000, 3250, …, 8750 Hz

### 12.2 কেন 250 Hz পরপর, কেন 16 ms window

N = Fs × T_win = 50000 × 0.016 = 800 sample Δf_bin = Fs / N = 50000 / 800 = 62.5 Hz 250 Hz = 4 × 62.5 Hz → প্রতিটা tone ঠিক একটা "bin"-এর উপর, পাশাপাশি tone-এর মধ্যে 4 bin ফাঁক একই window-এ পূর্ণসংখ্যক bin দূরের দুটো tone একে অপরকে "দেখে" না (orthogonal)। 4 bin ফাঁক থাকায় ADC-র clock একটু ভুল হলেও (±1–2%) বা Hann window দিলেও tone মিশে যায় না।

### 12.3 Slot আর window

প্রতিটা slot 20 ms, কিন্তু receiver মাঝের 16 ms (800 sample) দেখে। দুই পাশে 2 ms করে margin থাকে, যাতে timing একটু এদিক-ওদিক হলেও পাশের slot ঢুকে না পড়ে।

### 12.4 Frequency hopping set

set s = { s, s+6, s+12, s+18 }, s = 0 … 5 slot i ব্যবহার করে set (i mod 6); 2 bit মান v (0–3) → tone = s + 6v উদাহরণ: set 0 = {3000, 4500, 6000, 7500 Hz}, set 1 = {3250, 4750, 6250, 7750 Hz}। একই set আবার আসে 6 slot = 120 ms পরে, ততক্ষণে আগের echo অনেক কমে যায় (চিত্র 2.1)। Set-এর ভেতরে tone-গুলো 1500 Hz দূরে, তাই কোনো এক জায়গার fading একসাথে চারটাকে নষ্ট করে না।



চিত্র 12.1: একটা packet-এর সময়-frequency নকশা। কমলা = preamble (10 slot), নীল = data (54 slot)।



চিত্র 12.2: Virtual pool-এ (echo + pump + thruster + pinger, SNR 0 dB) ADC যা দেখে তার spectrogram।

### 12.5 Preamble

Preamble হলো 10টা আলাদা tone-এর একটা নির্দিষ্ট ক্রম: 3000, 6500, 4500, 8500, 5250, 7250, 4000, 8250, 4250, 5750 Hz। Receiver সারাক্ষণ এই ক্রমটা খোঁজে। এটা বেছে নেওয়া হয়েছে তিনটা নিয়ম মেনে (code-এ test আছে):

1. পাশাপাশি slot-এর tone অনেক দূরে, যাতে একটার echo পরেরটার মতো না শোনায়।
2. অন্য packet-এর data কোনোভাবেই 10টার মধ্যে 2টার বেশি slot মেলাতে পারে না, তাই data দেখে ভুল করে "packet শুরু" ধরে নেওয়া হয় না।
3. Preamble-এর কোনো tone-এর set, সেই packet-এর data অন্তত 6 slot (120 ms) পরে ব্যবহার করে। Simulation-এ প্রথম version-এ এই নিয়ম ছিল না, তখন preamble-এর echo প্রথম data slot নষ্ট করছিল। এটা ধরা পড়ার পর ঠিক করা হয়েছে।

### 12.6 Data rate

raw = 2 bit / 20 ms = 100 bit/s; code rate ½ → 50 bit/s একটা packet = 64 slot × 20 ms = 1.28 s, এতে 4 byte payload (32 bit) → কার্যকর ≈ 25 bit/s কম মনে হতে পারে, কিন্তু "LED on", "start mission 3", "আমি gate পার হয়েছি" জাতীয় command-এর জন্য যথেষ্ট, আর echo-ভর্তি pool-এ নির্ভরযোগ্যতা অনেক বেশি জরুরি।

## 13. Packet, CRC, error correction

### 13.1 Packet-এর গঠন (6 byte)

Byte | বিট 7–4 | বিট 3–0
0 | dst (কাকে, 15 = সবাইকে) | src (কে পাঠাল)
1 | seq (0–15, repeat চেনার জন্য) | flags: 8 = ACK চাই, 4 = এটা ACK
2 | cmd (0–255): 1 = LED on, 2 = LED off, 3 = toggle, 4 = ping, 10–255 তোমার নিজের
3 | arg (0–255)
4–5 | CRC-16 (byte 0–3-এর উপর)

### 13.2 CRC-16

g(x) = x¹⁶ + x¹² + x⁵ + 1 (0x1021), শুরুর মান 0xFFFF ("CRC-16/CCITT-FALSE") Data-কে একটা বড় binary সংখ্যা ধরে g(x) দিয়ে ভাগ করলে যে ভাগশেষ থাকে, সেটাই CRC। Receiver নিজে আবার হিসাব করে মেলায়। এক-দুই bit ভুল সবসময় ধরা পড়ে, এলোমেলো ভুল ধরা পড়ে 65535/65536 বার। পরীক্ষার মান: "123456789" → 0x29B1 (unit test-এ যাচাই করা)।

### 13.3 Convolutional code (K = 7, rate ½)

48 bit (6 byte)-এর পরে 6টা শূন্য ("tail") যোগ করে 54 bit বানানো হয়। প্রতিটা bit একটা 7-ঘরের shift register-এ ঢোকে, আর প্রতি bit-এ 2টা output bit বের হয়:

reg = [নতুন bit, আগের 6 bit] out₀ = parity(reg AND 1111001₂) (171 octal) out₁ = parity(reg AND 1011011₂) (133 octal) parity = কয়টা 1 আছে তা বিজোড় হলে 1। প্রতিটা output bit আগের 7টা input bit-এর উপর নির্ভর করে, তাই তথ্য অনেকগুলো coded bit-এ ছড়িয়ে থাকে। এই code-এর "free distance" 10: দুটো আলাদা message-এর coded রূপ কমপক্ষে 10টা bit-এ আলাদা। তাই কাছাকাছি নয় এমন অনেক ভুল ঠিক করা যায়। এটা NASA আর Wi-Fi-তে ব্যবহৃত বিখ্যাত code। প্রথমে Hamming(8,4) code দিয়ে design করা হয়েছিল। Simulation-এ দেখা গেল convolutional code একই noise-এ অনেক বেশি packet ঠিক আনে (−6 dB-এ ২৫% থেকে ৯০%+), তাই এটা বেছে নেওয়া হয়েছে।

### 13.4 Interleaver

slot(c) = (37 · c) mod 54; c < 54 হলে MSB, নাহলে LSB c = coded bit-এর নম্বর (0–107)। পাশাপাশি coded bit (যেগুলো Viterbi-র একসাথে লাগে) অন্তত 3 slot দূরে আর আলাদা frequency set-এ যায়। ফলে একটা ঝাঁকুনি (click) বা একটা faded frequency শুধু ছড়ানো কয়েকটা bit নষ্ট করে, যা Viterbi সবচেয়ে ভালো ঠিক করতে পারে।

## 14. Receiver কীভাবে decode করে (ধাপে ধাপে)

### 14.1 DC সরানো

dc ← dc + (x − dc) / 1024; y = x − dc f_c ≈ Fs / (2π · 1024) = 50000 / 6434 ≈ 7.8 Hz ADC-র sample-এ VREF (≈1600 count)-এর DC থাকে। এই এক লাইনের high-pass filter সেটা সরায়।

### 14.2 Goertzel: একটা tone-এর শক্তি মাপা

w[n] = 0.5 − 0.5 cos(2π (n + 0.5) / N) (Hann window) coef = 2 cos(2π f / Fs) s[n] = x[n]·w[n] + coef · s[n−1] − s[n−2] E = s[N−1]² + s[N−2]² − coef · s[N−1] · s[N−2] Goertzel হলো FFT-এর একটা মাত্র bin হিসাব করার সস্তা উপায়: প্রতি sample-এ একটা গুণ আর দুটো যোগ। আমাদের শুধু 24টা frequency দরকার, পুরো FFT লাগে না। Hann window কিনারাগুলো নরম করে দেয়, তাই পাশের tone-এর "leakage" কমে (Fs একটু ভুল হলেও)।

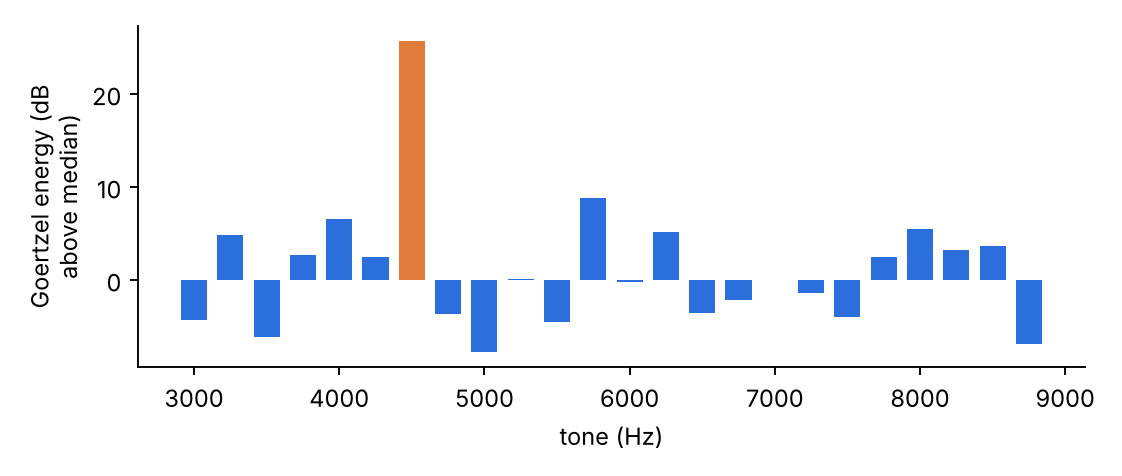
[picture p7: docs/figures/goertzel_demo.png]


চিত্র 14.1: 4500 Hz tone + noise-এর উপর 24টা Goertzel। কমলা bin স্পষ্ট জয়ী।

### 14.3 Whitening: প্রতিটা tone-এর নিজস্ব noise floor

N_k ← N_k + (min(E_k, 8·N_k) − N_k) / 256 (প্রতি 2.5 ms) z_k = E_k / N_k SNR_k ≈ z_k − 1, q = 10 log₁₀(z − 1) dB N_k হলো tone k-এর গড় noise (exponential moving average, সময় ধ্রুবক 256 × 2.5 ms = 0.64 s)। শুধু packet না থাকার সময় শেখে। "min(…, 8N)" মানে হঠাৎ জোরালো শব্দ (click বা নিজের signal) floor-কে বেশি টেনে তুলতে পারে না। z_k বলে tone k তার স্বাভাবিক noise-এর কত গুণ। ধ্রুব whine থাকলে N_k বড় হয়ে যায়, ফলে whine-এর z ≈ 1 থাকে। Firmware যে q print করে, সেটা এই SNR-এর median।

### 14.4 Preamble খোঁজা

প্রতি 2.5 ms (H = 125 sample) পরপর শেষ 16 ms-এর 24টা z হিসাব হয়। প্রতিটা preamble slot j-এর tone p_j কতটা "জয়ী", তা ভাগ হিসেবে মাপা হয়:

frac_j(t) = z_{p_j}(t) / Σ_k z_k(t) score(t) = (1/10) Σ_{j=0..9} frac_j( t − (9 − j)·T_slot ) match(t) = কয়টা j-তে p_j-ই 24টার মধ্যে সবচেয়ে জোরালো শর্ত: score ≥ 0.14 এবং match ≥ 5 শুধু noise থাকলে প্রতি frac ≈ 1/24 ≈ 0.04, তাই score ≈ 0.04। Preamble থাকলে score 0.3–0.9। ভাগ ব্যবহার করায় পুরো band-জুড়ে হঠাৎ শব্দ (click) এলে সব z একসাথে বাড়ে, score বাড়ে না। দুই শর্ত একসাথে থাকায় 10 মিনিটের কঠিন noise-এ একবারও ভুল trigger হয়নি (অধ্যায় 17)।

### 14.5 Timing ঠিক করা

Score-এর চূড়া একটু চ্যাপ্টা (window slot-এর চেয়ে ছোট বলে)। Trigger-এর পরে আরো 14টা hop (35 ms)-এর score রাখা হয়। তারপর চূড়ার 85%-এর উপরের অংশের ভারকেন্দ্র (centroid) নেওয়া হয়:

c = Σ i · (score_i − 0.7·max) / Σ (score_i − 0.7·max) data slot i-এর window শেষ হয়: e_i = sync + (i + 1) · S, S = Fs × 0.020

Data চলার সময় early/late gate timing-কে আস্তে আস্তে ঠিক রাখে। জয়ী tone-এর শক্তি 1 ms আগের ও পরের window-এ মাপা হয়, আর যেদিকে বেশি সেদিকে একটু সরানো হয়:

err = (E_late − E_early) / (E_late + E_early); adj ← adj + 0.25 · D · err (D = 1 ms, সীমা ±5 ms)

### 14.6 ADC-র আসল sample rate মাপা

Fs_measured = (মোট sample সংখ্যা) / (সময়, µs) × 10⁶ timing ভুল = (Fs ভুল) × packet দৈর্ঘ্য ESP32-এর ADC ঠিক 50000 না, একটু কম-বেশি দেয়। 1% ভুল হলে 1.28 s packet-এর শেষে timing 12.8 ms সরে যায়, যা slot-এর margin (2 ms)-এর অনেক বেশি। তাই firmware চলার সময় ক্রমাগত sample গোনে আর ESP32-এর নিজের µs timer-এর সাথে তুলনা করে। সময় যত বাড়ে, মাপ তত নিখুঁত হয় (20 s পরে ≈0.05% → packet-এর শেষে 0.6 ms)। Simulation-এ ADC-কে ইচ্ছা করে 2.4% দ্রুত চালিয়ে test করা হয়েছে।

### 14.7 Soft bit (LLR)

L_MSB = max(ln z₀, ln z₁) − max(ln z₂, ln z₃) L_LSB = max(ln z₀, ln z₂) − max(ln z₁, ln z₃) L > 0 মানে bit সম্ভবত 0, L < 0 মানে 1, আর |L| যত বড় তত নিশ্চিত। শুধু 0/1 না দিয়ে কতটা নিশ্চিত সেটাও Viterbi-কে দেওয়া হয় ("soft decision")। এতে hard decision-এর চেয়ে প্রায় 2 dB বেশি noise সহ্য হয়।

### 14.8 Viterbi decoding

PM_new(s′) = max over predecessor s of [ PM(s) + (±L₀) + (±L₁) ] 64টা সম্ভাব্য register অবস্থার প্রতিটার জন্য এখন পর্যন্ত সবচেয়ে মানানসই পথটা মনে রাখা হয় (PM = path metric)। প্রত্যাশিত bit 0 হলে +L, 1 হলে −L যোগ হয়। শেষে tail-এর কারণে অবস্থা 0-তে শেষ হওয়া পথটা পিছন দিকে (traceback) পড়ে 54 bit ফিরে পাওয়া যায়। এটাই maximum-likelihood decoding: যে message সবচেয়ে সম্ভাব্য, সেটাই বের হয়।

### 14.9 CRC আর কাজ

প্রথম 48 bit থেকে 6 byte বানিয়ে CRC মেলানো হয়। মিললে packet queue-তে যায়, main loop LED জ্বালায় বা নিভায়, দরকার হলে ACK পাঠায়। আর একই (src, seq) 15 s-এর মধ্যে আবার এলে command দ্বিতীয়বার চালানো হয় না (repeat), কিন্তু ACK আবার পাঠানো হয়, কারণ আগের ACK হয়তো হারিয়ে গিয়েছিল।

## 15. Firmware: install, upload, ব্যবহার

### 15.1 Install

1. Arduino IDE 2.x install করো।
2. File → Preferences → "Additional boards manager URLs"-এ বসাও: https://espressif.github.io/arduino-esp32/package_esp32_index.json
3. Tools → Board → Boards Manager → "esp32 by Espressif Systems" version 3.x install করো (3.3.12-এ compile করে দেখা হয়েছে; 2.x চলবে না, code নিজেই error দেবে)।
4. Repository-র firmware/DuburiModem folder খোলো (DuburiModem.ino)। একই folder-এ am_core.c, am_core.h, config.h থাকতে হবে।
5. Tools → Board → "ESP32 Dev Module"। কোনো বাড়তি library লাগে না।
6. config.h-এ NODE_ID বসাও: প্রথম ROV-এ 1, দ্বিতীয়টায় 2। আর PEER_ID-এ অন্যটার ID।
7. Upload। Serial Monitor: 115200 baud, line ending "Newline"।

### 15.2 Serial command

Command | কাজ
on [id] / off [id] / toggle [id] | id-এর ROV-এর LED জ্বালাও/নিভাও/উল্টাও (id না দিলে PEER_ID, 15 = সবাই)
ping [id] | উত্তর চায়; উত্তরের q দিয়ে link কেমন বোঝা যায়
send C A [id] | নিজের command C (0–255) আর argument A পাঠাও
sweep | 24টা tone একটা একটা করে 0.3 s বাজায় (frequency response test)
tone F MS | F Hz, MS millisecond বাজাও
scope | প্রতি 0.25 s-এ 24টা tone-এর whitened level (dB) দেখায় (আবার লিখলে বন্ধ)
stats | কয়টা preamble, কয়টা ঠিক, কয়টা CRC fail, ADC-র মাপা Fs, level, clipping
BOOT button | PEER_ID-কে "toggle" পাঠায় (laptop ছাড়াই test)

### 15.3 Output-এর format (main computer-এর জন্য)

TX to=2 seq=3 cmd=1 arg=0 (try 1/3)
RX src=1 dst=2 seq=3 cmd=1 arg=0 flags=8 q=14.2dB      ← receiver-এ
TX ack to=1 seq=3
ACK src=2 seq=3 cmd=1 state=1 q=12.8dB                  ← sender-এ
OK delivered to 2 (try 1)

Jetson বা Raspberry Pi একই USB serial port থেকে এগুলো পড়তে আর command লিখতে পারে। Python উদাহরণ:

import serial                                  # pip install pyserial
s = serial.Serial("/dev/ttyUSB0", 115200, timeout=0.1)
s.write(b"send 10 3 2\n")                       # ROV 2-কে command 10, argument 3
while True:
    line = s.readline().decode(errors="ignore").strip()
    if line.startswith("RX "):
        f = dict(kv.split("=") for kv in line.split()[1:])
        print("command", f["cmd"], "from", f["src"], "quality", f["q"])

### 15.4 নিজের command যোগ করা

DuburiModem.ino-তে enum { CMD_LED_ON = 1, … }-এ নতুন নাম দাও (10–255), তারপর handlePacket()-এর switch (p.cmd)-এ case লেখো। পাঠানোর জন্য sendCommand(dst, CMD_X, arg) বা serial-এ send।

## 16. Code-এর ব্যাখ্যা (function ধরে ধরে)

### 16.1 File-এর ভাগ

File | কী আছে
config.h | শুধু এটাই সাধারণত বদলাতে হয়: ID, pin, ACK, retry, heat guard
am_core.h / am_core.c | Modem-এর মস্তিষ্ক, সাধারণ C, ESP32-এর কিছু নেই। একই file PC test-এ চলে।
DuburiModem.ino | ESP32-এর অংশ: ADC DMA, LEDC tone, FreeRTOS task, serial command, LED, ACK
tests/test_core.c | PC-তে unit test (CRC, code, interleaver, loopback, noise)
sim/pool_sim.py, run_sim.py | Virtual pool, আসল C code চালিয়ে ফল আর graph
docs/ | এই PDF-এর উৎস, চিত্র, font

### 16.2 am_core.c

- am_tone_hz(k): f = 3000 + 250k।
- am_crc16(): bit ধরে ধরে CRC হিসাব (13.2)।
- am_conv_encode(): 7-ঘরের register, দুটো parity (13.3)।
- am_viterbi(): 64 state, প্রতি step-এ প্রতি state-এর দুটো আগের state থেকে ভালোটা বাছা, শেষে traceback (14.8)। dec[t]-এর প্রতিটা bit বলে কোন আগের state বাছা হয়েছিল।
- am_interleave(c): slot = 37c mod 54 (13.4)।
- am_pack()/am_unpack(): packet ↔ 6 byte, CRC বসানো/মেলানো।
- am_tx_build(): packet → bit → code → interleave → 64টা tone নম্বর (প্রথম 10টা preamble)।
- rx_configure(): Fs থেকে W (800), H (125), D (50), S (1000), Hann window, Goertzel coef, preamble offset।
- am_rx_process(): প্রতি sample-এ clipping গোনা, DC সরানো, ring buffer-এ রাখা। পরের "event"-এর সময় হলে rx_hop() (খোঁজা) বা rx_decode_slot() (data) ডাকা।
- rx_energies(): ring buffer থেকে W sample নিয়ে window গুণ করে, যতগুলো tone দরকার তাদের Goertzel।
- rx_hop(): 24 tone-এর E, noise floor update, z, frac, score, match। Trigger হলে PEAK অবস্থা।
- rx_finish_peak(): চূড়ার centroid → sync সময়, DECODE অবস্থা শুরু।
- rx_decode_slot(): slot-এর set-এর 4টা tone, z, LLR, quality, early/late।
- rx_finish_packet(): de-interleave, Viterbi, byte, CRC, quality median, queue-তে রাখা, আবার খোঁজা শুরু।
- am_rx_mute(): নিজে পাঠানোর সময় শোনা বন্ধ (নিজের জোরালো শব্দ যেন ভুল কিছু না ঘটায়)।
- am_rx_set_fs(): মাপা Fs বসানো, শুধু খোঁজার অবস্থায় (packet চলার মাঝে না)।

### 16.3 DuburiModem.ino

- startAdc(): ESP-IDF-এর adc_continuous driver। GPIO34 → ADC1 channel, 12 dB attenuation, 50 kHz, DMA frame 512 sample, overflow হলে গোনা হয়।
- rxTask() (core 0, priority 5): DMA থেকে sample পড়া, level মাপা, mutex নিয়ে am_rx_process(), packet হলে queue-তে পাঠানো। প্রতি 2 s-এ Fs মাপা আর দরকার হলে বসানো।
- playTones(): heat guard, RX mute, amp চালু, তারপর প্রতি slot-এ ledcWriteTone()। সময় মাপা হয় esp_timer (µs) দিয়ে, প্রতি slot-এর শেষ "absolute" সময়ে, তাই drift জমে না।
- heatGuard()/heatGuardUpdate(): 7.2-এর formula।
- sendCommand(): seq বাড়ানো, পাঠানো, ACK-এর জন্য 2.6 s অপেক্ষা, না এলে আবার (মোট 3 বার)।
- handlePacket(): আমার জন্য কি না দেখা, ACK চেনা, repeat চেনা, command চালানো, ACK পাঠানো।
- loop(): serial line পড়া, BOOT button, scope print, packet poll।

Thread safety: modem-এর state (g_rx) দুই task ব্যবহার করে, তাই প্রতিবার mutex (g_rx_lock) নেওয়া হয়। Packet main loop-এ যায় FreeRTOS queue দিয়ে। Heavy DSP core 0-তে চলে, serial আর TX core 1-এ।

## 17. Verification: কী test করা হয়েছে

### 17.1 Compile

Firmware Arduino-ESP32 core 3.3.12 (ESP-IDF 5.5) দিয়ে "ESP32 Dev Module"-এর জন্য compile করা হয়েছে, সব warning চালু রেখে। কোনো warning বা error নেই। Flash-এর ~23% আর RAM-এর ~17% লাগে।

### 17.2 Unit test (PC-তে, make -C tests && tests/test_core)

- CRC-16-এর মান "123456789" → 0x29B1।
- Convolutional code + Viterbi: 3000 বার এলোমেলো data, 0–4টা ছড়ানো ভুল, সবই ঠিক হয়েছে। এক bit বদলালে ≥10 coded bit বদলায়।
- Interleaver একটা permutation, পাশাপাশি bit আলাদা slot আর set-এ।
- Pack/unpack 2000 packet, প্রতিটায় 1 bit উল্টালে CRC ধরে।
- Preamble-এর তিনটা নিয়ম (12.5)।
- Loopback: পরিষ্কার signal, square wave, 1-sample-করে input, ADC 1.5% দ্রুত, Fs মাপায় 0.05% ভুল, 48 kHz, প্রায় 0 dB noise।
- 60 s শুধু noise: একটাও ভুল packet নেই।

### 17.3 Virtual pool simulation

ROV-এর আসল C code-কে একটা কম্পিউটার-বানানো pool-এর signal খাওয়ানো হয়েছে। Model-এ ছিল: ESP32 LEDC-এর আসল frequency ধাপ, slot-এর সময় ±30 µs কাঁপা, RC filter, speaker-এর অজানা response (1.5–7 kHz band, এলোমেলো ±5 dB ঢেউ), 50×25×5 m pool-এ image-method echo (দেয়াল/মেঝে reflection 0.85, পানির উপরিতল −0.9), 10–25 m এলোমেলো অবস্থান, pump hum, thruster noise (ওঠানামা সহ), click, 30 kHz pinger, preamp-এর filter, ADC (2.4% দ্রুত clock, 12 bit, noise)। প্রতি বিন্দুতে 40টা packet।



চিত্র 17.1: SNR অনুযায়ী কত packet ঠিক এসেছে। SNR = ADC-তে 3–9 kHz band-এর signal power / noise power।

In-band SNR | Preamble পাওয়া গেছে | Packet একদম ঠিক | Firmware-এর q (median)

{{SNR_TABLE}}

Echo-র মাত্রা (SNR −3 dB) | ঠিক

{{REVERB_TABLE}}

Interference (SNR −3 dB) | ঠিক

{{INTF_TABLE}}

ADC clock 2.4% দ্রুত, SNR 0 dB | ঠিক

{{CLOCK_TABLE}}

False alarm: {{FA_SECONDS}} s শুধু noise (pump + thruster + 5.5 kHz whine + click + 35 kHz pinger): preamble trigger {{FA_TRIG}}, ভুল packet {{FA_PKTS}}।



চিত্র 17.2: Firmware যে q print করে বনাম আসল SNR। মাঠে q দেখে বোঝা যায় link কতটা নিরাপদ।

মাঠের নিয়ম: q ≥ 10 dB → নিশ্চিন্ত। q 7–10 dB → চলবে, কিছু retry হবে। q < 7 dB → সীমানায়, volume/gain/অবস্থান ঠিক করো। Fs-এর মাপ 1% ভুল হলে (16/20) ক্ষতি হয়, তাই firmware-এর ক্রমাগত Fs মাপা জরুরি। চালুর পর প্রথম ~10 s মাপ স্থির হতে দাও।

### 17.4 Simulation-এ পাওয়া আর ঠিক করা সমস্যা

1. Preamble-এর শেষ tone-এর echo প্রথম data slot নষ্ট করছিল। নিয়ম 3 (12.5) যোগ করে ঠিক করা হয়েছে।
2. প্রথম interleaver একটা codeword-এর সব bit একই frequency set-এ পাঠাচ্ছিল। এক frequency fade করলে পুরো codeword নষ্ট হতো। নতুন interleaver দিয়ে ঠিক করা হয়েছে।
3. Hamming(8,4)-এর বদলে convolutional code: −6 dB-এ সফলতা প্রায় ২৫% থেকে ৯০%।
4. Detection threshold 0.17 থেকে 0.14: −9 dB-এ preamble পাওয়া 75% থেকে 100%, false alarm-ও শূন্য।

### 17.5 কী test করা হয়নি (সৎভাবে)

- আসল ESP32, আসল speaker, আসল পানি। Code compile হয়েছে আর logic simulation-এ test হয়েছে, কিন্তু board-এ চালানো হয়নি। অধ্যায় 18-এর ধাপ ধরে নিজেরা test করবে।
- Car speaker-এর box থেকে পানিতে আসলে কত জোরে শব্দ যায়, আর pool-এর আসল noise কত। Simulation-এ SNR-কে চলক রাখা হয়েছে। মাঠে scope আর q দিয়ে মাপবে।
- Component-এর মান datasheet-এর সাধারণ মান থেকে, আর thermal ও plate হিসাব আনুমানিক।

এর বাইরে, আলাদা AI reviewer agent দিয়ে code, circuit আর এই document স্বাধীনভাবে যাচাই করানো হয়েছে। ফলাফল repository-র docs/VERIFICATION.md-এ আছে।

## 18. বানানো ও test করার ধাপ

### ধাপ 1: Bench (পানি ছাড়া)

1. দুটো ESP32-এ firmware দাও (NODE_ID 1 আর 2)। Serial-এ "ready" দেখাবে।
2. শুধু preamp: piezo লাগিয়ে stats দেখো। LEVEL-এর mean ≈ 1500–1800, rms ছোট (5–30)। Piezo-তে আঙুলের টোকা দিলে max লাফাবে।
3. Wire loopback: node 1-এর RV1-এর wiper থেকে signal নিয়ে 100 kΩ আর 1 kΩ-এর divider দিয়ে ১০০ ভাগের ১ ভাগ করো (wiper → 100 kΩ → বিন্দু → 1 kΩ → GND)। সেই বিন্দু থেকে node 2-এর preamp input-এ (piezo-র জায়গায়) দাও। RV2 কম রাখো। দুই board-এর GND জোড়া দাও, আর speaker খুলে রাখো। Node 1-এ on লিখলে node 2-এর LED জ্বলবে। (ACK-এর জন্য উল্টো দিকেও একই তার লাগবে। না দিলে "no reply" দেখাবে, কিন্তু LED জ্বলবে।) এতে পুরো DSP chain পানি ছাড়াই পরীক্ষা হয়।
4. Amp + speaker বাতাসে, RV1 একদম কম। tone 5000 500 দিয়ে শব্দ শোনো। আস্তে বাড়াও, কর্কশ হওয়ার আগে থামো।

### ধাপ 2: বালতি

1. Speaker box আর hydrophone বালতিতে, 30–50 cm দূরে। Volume কম।
2. RX-এ scope চালু, TX-এ sweep। কোন tone-এ level কম আসে দেখো।
3. stats-এ clipped বাড়লে RV2 (gain) কমাও। rms খুব কম হলে বাড়াও।
4. ping ১০ বার। সবগুলো OK আর q বড় (>20 dB) হওয়া উচিত।

### ধাপ 3: Pool

1. 5, 10, 15, 20, 25 m-এ প্রতিবার ২০টা ping। কয়টা OK আর q-এর মান লিখে রাখো।
2. Thruster বন্ধ আর চালু, দুইভাবেই। চালু অবস্থায় RX-এর scope-এ কোনো tone-এ স্থায়ী উঁচু level থাকলে বুঝবে সেখানে whine আছে (whitening সামলাবে, কিন্তু জেনে রাখা ভালো)।
3. প্রতি ১০ মিনিট পর speaker-এর resistance মেপে তাপমাত্রা দেখো (7.6)।
4. q < 7 dB হলে: (ক) volume একটু বাড়াও (clip না করে); (খ) hydrophone-কে thruster থেকে দূরে নাও; (গ) speaker জানালা পাতলা বা বড় করো; (ঘ) দরকার হলে PAM8610।

### ধাপ 4: ROV-এ লাগানো

- Hydrophone নিচের দিকে, frame থেকে কম্পন-বিচ্ছিন্ন। Speaker-এর জানালা খোলা পানির দিকে।
- Main computer-এর সাথে serial (15.3), অথবা শুধু BOOT button/LED দিয়ে।

## 19. Troubleshooting

লক্ষণ | সম্ভাব্য কারণ | কী করবে
Serial-এ "ADC start failed" | ভুল pin বা core 2.x | PIN_HYDROPHONE 32–39-এর একটা হতে হবে, core 3.x
preambles = 0, কিছুই আসে না | signal খুব কম, বা gain কম, বা ADC saturate | scope দেখো; stats-এ LEVEL; RV1/RV2 ঠিক করো; wire loopback দিয়ে DSP check
preambles বাড়ে কিন্তু crc_fail-ও বাড়ে | SNR সীমানায়, echo বেশি, বা clipping | q দেখো; clipped শূন্য রাখো; দূরত্ব কমিয়ে দেখো; hydrophone-এর অবস্থান বদলাও
clipped দ্রুত বাড়ে | gain বেশি বা thruster noise খুব জোরালো | RV2 কমাও; hydrophone thruster থেকে দূরে
overflows বাড়ে | CPU সময় পাচ্ছে না | loop()-এ লম্বা কাজ যোগ করোনি তো? WiFi/BT চালু করোনি তো?
fs_measured 49000–51500-এর বাইরে | ADC বা driver সমস্যা | board বদলে দেখো; issue খোলো
TX-এর সময় ESP32 reset | brownout: amp-এর current-এ voltage নামছে | আলাদা buck, 1000 µF, মোটা তার
Speaker গরম | অধ্যায় 7 | checklist 7; MAX_TX_DUTY কমাও
Amp গরম/বন্ধ হয়ে যায় | speaker-এর তার GND-এ, বা 2 Ω-এর কম load | BTL নিয়ম (6.2); একটাই 4 Ω speaker
"HEAT-GUARD wait" | খুব ঘনঘন পাঠাচ্ছ | স্বাভাবিক, speaker রক্ষা করছে
LED জ্বলে কিন্তু "no reply" | অন্য দিকের TX বা RX কাজ করছে না | উল্টো দিকে ping; দুই ROV-এ ID আলাদা কি না দেখো
একই command দুইবার কাজ করে | seq বদলে নতুন command পাঠানো হয়েছে | স্বাভাবিক; repeat-এ seq একই থাকে, তখন দ্বিতীয়বার চলে না
Hum বা ভনভন শব্দ (scope-এ সব tone উঁচু) | ground loop, unshielded cable | star ground, shield শুধু এক প্রান্তে, preamp-এর supply filter

## 20. Safety

- LiPo battery: fuse ব্যবহার করবে, short হলে আগুন লাগতে পারে। পানিতে নামানোর আগে সব সংযোগ seal করবে।
- Pool-এ মানুষ থাকলে সাধারণত শব্দ নিরাপদ মাত্রায় থাকে (কয়েক W), কিন্তু খুব কাছ থেকে কানে পানির নিচে জোরালো tone অস্বস্তিকর। Test-এর সময় ডুবুরিদের জানিয়ে রাখো।
- Speaker আর amp গরম হলে বন্ধ করো। Box খোলার আগে ঠান্ডা হতে দাও।
- Epoxy হাতে লাগলে সাবান দিয়ে ধুয়ে ফেলবে। খোলা জায়গায় কাজ করবে।
- Competition-এর নিয়মে acoustic emission-এর কোনো সীমা থাকলে (pinger task-এর সময় চুপ থাকা ইত্যাদি) সেটা মেনে চলবে। দরকার হলে firmware-এ একটা "quiet" command যোগ করো।

## A. সব formula এক জায়গায়

Formula | কোথায় লাগে | অধ্যায়
λ = c / f | wavelength, coating কতটা পাতলা | 2.1, 9.1
t = d / c | শব্দ পৌঁছানোর সময় | 2.1
Δf = f·v/c | Doppler | 2.4
I = P/(η·V) | battery current | 5
f = 1/(2π√(LC)) | supply-র LC filter | 5
x(t) = V/2 + (2V/π)Σ sin(nωt)/n | square wave-এর ভেতরে কী আছে | 6.2, 7.1
f_c = 1/(2πRC) | সব RC filter | 6.2, 10.2
R_th = R1∥R2, divider = R2/(R1+R2) | TX filter, volume | 6.2
P = V_pk²/(2R) | amp output power | 6.2
P_DC = (dV)²/R | DC-র অপচয় | 7.1
t_rest = t_on(1−d)/d | heat guard | 7.2
ΔT = P·R_th | তাপমাত্রা বৃদ্ধি | 7.5
ΔT = (R_hot/R_cold − 1)/0.00393 | coil-এর তাপ মাপা | 7.6
P = ρgh | গভীরতায় চাপ | 8.1
w = Pa⁴/(64D), σ = 3Pa²/(4t²) | জানালা কতটা বাঁকে | 8.1
Z = ρc, T = 4Z₁Z₂/(Z₁+Z₂)² | seal করলে শব্দ ঢোকে কি না | 9.1
G = 1 + Rf/Rg | op-amp gain | 10.2
GBW ≥ G·f | op-amp বাছাই | 10.2
Fs > 2f, f_alias = |f − kFs| | sampling, pinger alias | 11.2
PG = 10log(B_band/B_bin) | processing gain | 11.3
f_k = 3000 + 250k | tone | 12.1
Δf_bin = Fs/N | frequency resolution | 12.2
set = {s, s+6, s+12, s+18} | frequency hopping | 12.4
g(x) = x¹⁶+x¹²+x⁵+1 | CRC-16 | 13.2
G = (171, 133)₈, K = 7 | convolutional code | 13.3
slot = 37c mod 54 | interleaver | 13.4
dc += (x−dc)/1024 | DC blocker | 14.1
s[n] = xw + coef·s[n−1] − s[n−2] | Goertzel | 14.2
N += (min(E,8N) − N)/256 | noise floor | 14.3
score = mean frac_j | preamble detection | 14.4
err = (E_L−E_E)/(E_L+E_E) | timing tracking | 14.5
Fs = ΔN/Δt | ADC-র আসল rate | 14.6
L = max(ln z…) − max(ln z…) | soft bit | 14.7
PM′ = max(PM ± L) | Viterbi | 14.8

## B. শব্দকোষ (Glossary)

শব্দ | মানে
ADC | Analog-to-Digital Converter: voltage-কে সংখ্যায় রূপান্তর করে
DMA | Direct Memory Access: CPU ছাড়াই hardware নিজে data memory-তে রাখে
FSK | Frequency Shift Keying: তথ্য বোঝানো হয় কোন frequency বাজছে তা দিয়ে
Frequency hopping | সময়ের সাথে frequency-র set বদলানো
Slot / symbol | 20 ms-এর একটা ভাগ, যাতে একটা tone বাজে
Preamble | Packet-এর শুরুর পরিচিত নকশা, যা দিয়ে packet খুঁজে পাওয়া যায়
Goertzel | একটা নির্দিষ্ট frequency-র শক্তি মাপার দ্রুত algorithm
Window (Hann) | Signal-এর দুই কিনারা নরম করার গুণক
SNR | Signal-to-Noise Ratio, dB-তে: 10·log₁₀(P_signal/P_noise)
dB | অনুপাতের log মাপ। +3 dB ≈ ২ গুণ power, +10 dB = ১০ গুণ, +20 dB = ১০০ গুণ
Reverberation / echo | দেয়াল ও পানির উপরিতলে প্রতিফলিত শব্দ
Fading | Echo-গুলো একে অপরকে কেটে দিয়ে কোনো frequency দুর্বল হয়ে যাওয়া
CRC | ভুল ধরার check-সংখ্যা
Convolutional code / Viterbi | ভুল ঠিক করার code আর তার decoder
Interleaver | Bit-এর ক্রম এলোমেলো করে ছড়িয়ে দেওয়া
LLR / soft bit | Bit 0 না 1, আর কতটা নিশ্চিত
BTL | Bridge-Tied Load: speaker-এর দুই প্রান্তেই amp-এর output
Class-D | দ্রুত on/off switching amplifier, efficiency ~৯০%
Acoustic impedance | Z = ρc, শব্দের জন্য পদার্থের "বাধা"
Aliasing | Fs/2-এর উপরের frequency-র ভুল করে নিচে দেখা দেওয়া
Buck converter | উচ্চ voltage থেকে দক্ষভাবে নিম্ন voltage বানানোর circuit
ACK | "পেয়েছি" উত্তর

## C. পুরো source code

নিচের code repository-র file থেকে PDF বানানোর সময় সরাসরি বসানো হয়েছে, তাই হুবহু একই। নতুন version-এর জন্য সবসময় GitHub-এর code দেখবে।

{{CODE_CONFIG}} {{CODE_INO}} {{CODE_CORE_H}} {{CODE_CORE_C}}
