jarifalamclaude-max/DUBURI_IVC/docs/DUBURI_IVC_Guide.pdf

# DUBURI IVC

পা নি র নি চে | দুই ROV-এর মধ্যে | শব্দ দি য়ে | যো | গা যো | গ
Acoustic Inter-Vehicle Communication: পুরো | গা ইড, A থে কে | Z.
কে | ন এভা বে | করা হলো | , সব formula, circuit, speaker গরম হওয়া র কা রণ ও সমা ধা ন,
piezo hydrophone seal করা র নি য়ম, pool-এর noise filtering, ESP32-এর পুরো | code
আর তা র ব্যা খ্যা , test করা র নি য়ম আর সমস্যা | হলে | কী করবে ।

# Hardware: ESP32 + PAM8403 class-D amp + car speaker (TX) | piezo disc + op-

## amp preamp (RX)

# Firmware: Arduino-ESP32 core 3.x (3.3.12-এ compile করে দে খা )

# সব code: github.com/jarifalamclaude-max/DUBURI_IVC

DUBURI IVC | 2

# সূচি পত্র

1 | এক নজরে | পুরো | সি স্টে | ম
2 | পা নি তে | শব্দ: যা জা না দরকা র
3 | সি স্টে | মে র block diagram
4 | কী কী লা গবে | (BOM ও আনুমা নি ক দা ম)
5 | Power supply ও grounding
6 | Transmitter circuit (ESP32 → amp → speaker)
7 | Speaker গরম হচ্ছে | কে | ন, আর সমা ধা ন
8 | Speaker box: পা নি তে | শব্দ বে র করা
9 | Piezo hydrophone: বা না নো | ও seal করা

## 10 Receiver preamp circuit

## 11 Noise filtering: তি ন স্তর

## 12 Signal design: tone, slot, hopping

## 13 Packet, CRC, error correction

14 Receiver কী ভা বে | decode করে | (ধা পে | ধা পে )

## 15 Firmware: install, upload, ব্য বহা র

## 16 Code-এর ব্যা খ্যা (function ধরে ধরে )

## 17 Verification: কী test করা হয়ে ছে

## 18 বা না নো ও test করা র ধা প

## 19 Troubleshooting

## 20 Safety

A | সব formula এক জা য়গা য়
B | শব্দকো | ষ (Glossary)
C | পুরো | source code

1. এক নজরে | পুরো | সি স্টে | ম
একটা ROV (sender) একটা ছো | ট "packet" পা ঠা য়। Packet মা নে | কয়ে কটা byte: কা কে | পা ঠা চ্ছি , কে | পা ঠা চ্ছে | , কো | ন
command (যে মন "LED জ্বা লা ও"), আর command-এর একটা argument। ESP32 এই byte-গুলো | কে | কি ছু নি র্দি ষ্ট
frequency-র শব্দ (tone)-এ রূ পা তন্র করে । Car speaker সে ই শব্দ পা নি তে | ছা ড়ে । অন্য ROV-এর piezo hydrophone
শব্দটা শো | নে , preamp signal বড় ও পরি ষ্কা | র করে , ESP32-এর ADC সে টা digital করে । তা রপর firmware বে র করে
কো | ন tone বে জে | ছি ল, সে খা ন থে কে | byte ফি রি য়ে | আনে , CRC দি য়ে | যা চা ই করে , তা রপর কা জটা করে | (LED জ্বলে )। চা ইলে
উল্টো | দি কে | একটা ছো | ট "ACK" (পে য়ে ছি ) packet ফে | রত পা ঠা য়।
বি ষয় | মা ন | কে ন
Modulation | 4-FSK + frequency hopping | সহজ, amplitude-এর উপর নি র্ভর করে না , echo-র মধ্যে ও কা জ করে
Tone | 24টা , 3000–8750 Hz, 250 Hz পরপর | car speaker ও piezo এই band-এ ভা লো কা জ করে ; pump noise (নি চে ) আর RoboSub pinger (25–40 kHz) এড়া য়
Slot | 20 ms, প্রতি slot-এ একটা tone = 2 bit | যথে ষ্ট লম্বা যা তে echo-র মধ্যে ও tone চে না যা য়
Packet দৈ র্ঘ্য | 64 slot = 1.28 s (preamble 0.2 s + data 1.08 s) | command পা ঠা নো র জন্য যথে ষ্ট দ্রু ত
Payload | 4 byte (dst, src, seq+flags, cmd, arg) + CRC-16 | "LED on"-এর মতো command-এর জন্য যথে ষ্ট
Error correction | Convolutional code K=7, rate 1/2 + Viterbi | যে bit ভুল আসে সে গুলো ঠি ক করে ফে লে
Receiver ADC | ESP32 ADC1, DMA, 50 kHz | কো নো CPU সময় নষ্ট না করে sample নে য়
দূরত্ব (লক্ষ্য ) | 10–25 m, RoboSub-এর মতো pool | —
Simulation-এ ফল | in-band SNR −6 dB-এ 90%, 0 dB-এ 100% packet ঠি ক | অধ্যা য় 17
Speaker গরম হওয়া র সং ক্ষি তপ্ উত্তর (বি তাস্তারি ত অধ্যা য় 7): transistor বা L298N দি য়ে | speaker-এর এক মা থা
GND-এ রে খে | on/off করলে | অর্ধে ক power DC হয়ে | যা য়। এতে | শব্দ হয় না , শুধু coil গরম হয়। সমা ধা ন হলো | BTL

class-D amplifier (PAM8403), amp-এর input-এ filter আর volume control, আর firmware-এর "heat

guard" যা speaker-কে | কা জে | র পর বি শ্রা ম দে য়।
Piezo seal করলে | শব্দ ধরবে | কি না (বি তাস্তারি ত অধ্যা য় 9): ধরবে । Epoxy, silicone, তে ল, এদে র "acoustic
impedance" পা নি র কা ছা কা ছি , তা ই শব্দ প্রা য় পুরো | টা ই ভে তরে | ঢো | কে | (৮৫–৯৯%)। শব্দ আটকা য় শুধু বা তা স (০.১%-
এর মতো | ঢো | কে | )। তা ই নি য়ম একটা ই: piezo আর পা নি র মা ঝে | কো | নো | air bubble বা ফাঁ কা জা য়গা থা কবে | না ।

2. পা নি তে | শব্দ: যা জা না দরকা র
2.1 Radio কে | ন চলে | না , শব্দ কে | ন চলে
পা নি , বি শে ষ করে | chlorine দে ওয়া pool-এর পা নি , বি দ্যু ৎ পরি বা হী । তা ই WiFi বা Bluetooth-এর মতো | radio wave
কয়ে ক সে ন্টি মি টা রে র মধ্যে | ই শে ষ হয়ে | যা য়। শব্দ উল্টো | : পা নি তে | বা তা সে র চে য়ে | প্রা য় ৪.৫ গুণ দ্রু ত যা য় আর অনে ক কম ক্ষয়
হয়। তা ই পা নি র নি চে | যো | গা যো | গে র প্রধা ন উপা য় হলো | শব্দ (acoustic)।
c ≈ 1480 – 1500 m/s (পা নি তে | শব্দে র গতি ; বা তা সে | 343 m/s)

# λ = c / f

λ = wavelength। উদা হরণ: f = 5000 Hz হলে | λ = 1480/5000 ≈ 0.30 m। এই সং খ্যা টা পরে লা গবে । যে কো | নো | জি নি স λ-এর তুলনা য় অনে ক
পা তলা হলে | (যে মন 2–3 mm epoxy) শব্দ সে টা প্রা য় টে রই পা য় না ।

# t = d / c

শব্দ পৌঁ | ছা তে | কত সময় লা গে । 25 m হলে | t = 25/1480 ≈ 17 ms। এটা একটা slot (20 ms)-এর চে য়ে | কম, কি ন্তু pool-এর দে য়া লে | ধা ক্কা খে য়ে | আসা
echo আসে | আরো | অনে ক পরে (৫০–৩০০ ms পর্যন্তর্য | )।
2.2 Pool-এর সবচে য়ে | বড় সমস্যা : echo (reverberation)
Pool-এর দে য়া ল আর মে ঝে | টা ইলস বা কং ক্রি টে র, আর পা নি র উপরি তল প্রা য় আয়না র মতো | শব্দ ফে | রত দে য়। তা ই একটা
tone বা জা লে | receiver সে টা একবা র না , শত শত বা র শো | নে , প্রতি টা আলা দা দে রি তে | আর আলা দা phase-এ। দুটো | খা রা প

## ফল হয়:

1. Fading: কো | নো | জা য়গা য় কো | নো | একটা frequency-র echo-গুলো | একে | অপরকে | কে | টে | দে য়, ফলে | সে ই tone খুব
দুর্বল শো | না য়। অন্য frequency আবা র ঠি ক থা কে | ।
2. Inter-symbol interference: আগে র slot-এর tone-এর echo পরে র slot-এও বা জতে | থা কে | ।
আমা দে র design-এর প্রা য় প্রতি টা সি দ্ধা | তন্ এই দুটো | সমস্যা | ঠে কা নো | র জন্য : frequency hopping (অধ্যা য় 12),
interleaving আর convolutional code (অধ্যা য় 13)। নি চে র চি ত্রে | simulation-এর pool model-এ echo-র শক্তি কত
দ্রু ত কমে , সে টা দে খা নো | হয়ে ছে ।

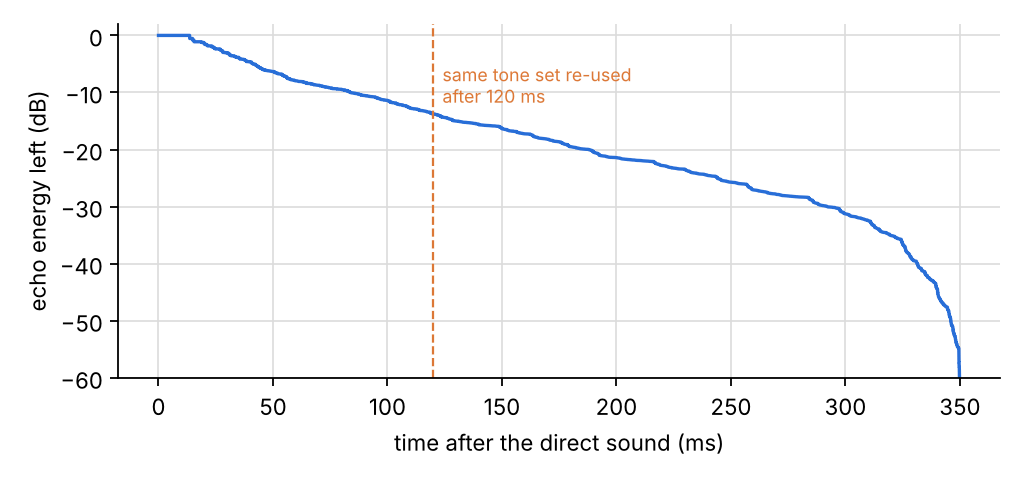
[picture p8: figure]

চি ত্র 2.1: 50×25×5 m pool model-এ echo-র অবশি ষ্ট শক্তি । একই frequency set আবা র ব্য বহা র করা র আগে | 120 ms অপে ক্ষা করা
হয়, ততক্ষণে | echo অনে কটা কমে | যা য়।

# 2.3 RoboSub-এ বি শে ষ সতর্কতা

RoboSub-এ acoustic pinger থা কে | , যা র frequency সা ধা রণত 25–40 kHz। আমা দে র tone 3–8.75 kHz, অর্থা ৎ
অনে ক নি চে । তা র উপর ADC-র sampling rate 50 kHz নে ওয়া হয়ে ছে | যা তে | pinger-এর শব্দ "alias" হয়ে | আমা দে র
band-এ ঢুকে | না পড়ে | (অধ্যা য় 11.2-এ formula)। Thruster আর pool pump-এর বে শি রভা গ শব্দ 2–3 kHz-এর নি চে
থা কে | , তা ই আমা দে র band সে টা ও এড়ি য়ে | যা য়।
2.4 Doppler: ROV চললে | frequency সরে | কি ?

# Δf = f · v / c

v = দুইদু | ROV-এর আপে ক্ষি ক গতি । v = 0.5 m/s আর f = 8750 Hz হলে | Δf = 8750 × 0.5 / 1480 ≈ 3 Hz। আমা দে র receiver-এর
frequency resolution 62.5 Hz আর tone 250 Hz পরপর, তা ই 3 Hz কো | নো | সমস্যা না ।

3. সি স্টে | মে র block diagram
চি ত্র 3.1: উপরে | sender, নি চে | receiver। দুই ROV-এ একই hardware থা কলে | দুজনে ই পা ঠা তে | ও শুনতে | পা রে | (ACK-এর জন্য )।

Sender-এর কা জ: packet → bit → error-correction code → interleave → প্রতি 2 bit-এ একটা tone → ESP32-

এর LEDC peripheral দি য়ে | square wave → RC filter দি য়ে | মসৃণ করা ও volume ঠি ক করা → PAM8403 amp →

## speaker → box-এর পা তলা জা না লা → পা নি ।

Receiver-এর কা জ: piezo → preamp (gain + 1.5–10 kHz band-pass) → ESP32 ADC (DMA, 50 kHz) → DC

সরা নো | → Goertzel দি য়ে | 24টা tone-এর শক্তি মা পা → noise floor দি য়ে | ভা গ (whitening) → preamble খোঁ | জা →
timing ঠি ক করা → প্রতি slot-এর soft bit → de-interleave → Viterbi → CRC check → command চা লা নো | ।
একটা গুরু ত্বপূর্ণ design সি দ্ধা | তন্: modem-এর মূল code ( am_core.c ) সা ধা রণ C-তে | লে | খা , এতে | ESP32-এর কি ছু নে ই।
তা ই একই file PC-তে | compile করে | test আর simulation চা লা নো | গে ছে । PC-তে | যে টা test হয়ে ছে , ঠি ক সে টা ই ROV-এ

চলে ।

4. কী কী লা গবে | (BOM ও আনুমা নি ক দা ম)
প্রতি টা ROV-এর জন্য | (দুটো | ROV-এ দুই সে ট)। দা ম বাং লা দে শে র সা ধা রণ অনলা ইন বা | দো | কা নে র আনুমা নি ক দা ম,
দো | কা নভে দে | কমবে শি হবে ।
জি নি স | সং খ্যা | আনুমা নি ক দা ম (৳) | মতন্ব্য
ESP32 DevKit V1 (WROOM-32) | 1 | 450–650 | Uno-র চে য়ে সস্তা , অনে ক দ্রু ত, DMA ADC আছে
PAM8403 class-D amp module | 1 | 60–120 | 5 V, 3 W×2, BTL output
(বি কল্প) PAM8610 amp module | (1) | 250–400 | 12 V, বে শি জো র লা গলে ; heat sink লা গবে
Car speaker (আছে ) | 1 | — | 4 Ω
Piezo disc 27 mm বা 35 mm | 2–3 | 10–20 প্রতি টা | একটা নষ্ট হলে বদলা নো র জন্য বা ড়তি রা খো
MCP6002 op-amp (না পে লে LM358) | 1 | 40–80 (LM358: 10– 15) | dual op-amp, DIP-8
Buck converter (LM2596 বা MP1584) | 2 | 80–150 প্রতি টা | একটা ESP32-এর, একটা amp-এর
Trimmer pot 10 kΩ, 100 kΩ | 1 + 1 | 10–20 প্রতি টা | volume ও gain
Resistor, capacitor (তা লি কা অধ্যা য় 6, 10) | — | 100–150 | film/ceramic cap
Shielded cable (2-core বা mic cable) | 1–2 m | 30–60/m | hydrophone-এর জন্য
2-part epoxy বা liquid electrical tape | 1 | 150–300 | piezo seal
Acrylic sheet 3–5 mm (speaker জা না লা ) | ছো ট টুকরা | 100–200 | অধ্যা য় 8
Perfboard, header, fuse, তা র | — | 100–150 | —
কে | ন Uno না : Uno-র RAM 2 KB, clock 16 MHz, ADC দ্রু ত হলে | noisy হয়, আর DMA নে ই। ESP32-এ 520 KB RAM, 240 MHz,
float FPU আর DMA দি য়ে | 50 kHz ADC sampling আছে , আর দা মও Uno clone-এর মতো | বা কম। আমা দে র receiver প্রতি সে কে | ন্ডে
প্রা য় ৮০ লা খ গুণ-যো | গ করে , যা Uno-তে | সভম্ব না ।

# 5. Power supply ও grounding

চি ত্র 5.1: দুটো | আলা দা buck converter। Amp-এর supply-তে | ferrite/inductor আর 1000 µF।
দুটো | buck কে | ন: amp প্রতি বা র tone বা জা নো | র সময় হঠা ৎ ১ A-এর মতো | current টা নে । একই 5 V থে কে | ESP32
চললে | voltage নে মে | ESP32 reset হতে | পা রে | (brownout), আর preamp-এ শব্দ (noise) ঢো | কে | ।
Ferrite + 1000 µF: একটা LC low-pass filter। Amp-এর switching noise buck-এ ফি রতে | দে য় না , আর হঠা ৎ
current-এর সময় capacitor থে কে | charge যো | গা য়।
Star ground: সব GND তা র একটা বি ন্দু | তে | (battery −) মি লবে । Thruster-এর বড় current যে ন preamp-এর
GND তা রে র মধ্য দি য়ে | না যা য়।
Preamp-এর supply: ESP32-এর 3V3 থে কে | 10 Ω + 100 µF দি য়ে | আলা দা করে | "3V3A" (অধ্যা য় 10)।

# I_battery ≈ P_out / (η · V_battery)

Buck converter-এর input current। η = efficiency (≈ 0.85)। উদা হরণ: amp 5 V-এ 1 A টা নলে | (5 W), 14.8 V battery থে কে
লা গে | 5 / (0.85 × 14.8) ≈ 0.4 A। তা ই 3 A fuse যথে ষ্ট।

# f_LC = 1 / (2π √(L·C))

10 µH আর 1000 µF হলে f ≈ 1.6 kHz। এর উপরে র buck switching noise (সা ধা রণত 150 kHz+) অনে কটা কে টে যা য়।

# 6. Transmitter circuit (ESP32 → amp → speaker)

চি ত্র 6.1: Transmitter। ESP32-এর GPIO25 থে কে square wave → RC filter → volume → PAM8403 → speaker।

## 6.1 প্রতি টা অং শ কী করে

GPIO25 (LEDC): ESP32-এর LEDC peripheral hardware দি য়ে ই নি র্দি ষ্ট frequency-র square wave বা না য় (0 V

আর 3.3 V-এর মধ্যে | )। CPU কি ছু করে | না , তা ই tone একদম স্থি র থা কে | । প্রতি 20 ms পরপর firmware শুধু
frequency বদলে | দে য়।
R1 + C1 (low-pass filter): square wave-এর ধা রা লো | কি না রা কে | টে | নরম করে , উঁচু harmonic কমা য়।
C2 (1 µF): DC আটকা য়। Amp শুধু AC পা য়, এটা heat কমা নো | র জন্য ও জরু রি (অধ্যা য় 7)।
RV1 (10 kΩ trimmer): volume। ESP32-এর 2.1 V peak signal amp-এর জন্য অনে ক বে শি , ফলে | amp clip
করত। Clip মা নে | output square wave, যা বে শি গরম করে ।
PAM8403: class-D, BTL (bridge-tied load) amp, ~৯০% efficient। নি জে | প্রা য় গরম হয় না ।

# 6.2 Formula ও হি সা ব

# square wave (0…V) = V/2 + (2V/π)·[sin ωt + (1/3)sin 3ωt + (1/5)sin 5ωt

+ …]

Fourier series। প্রথপ্র | ম অং শ V/2 হলো | DC। আসল tone (fundamental)-এর amplitude 2V/π; ESP32-এ V = 3.3 V হলে | 2.10 V
peak। শুধু বি জো | ড় harmonic (3f, 5f, …) থা কে । আমা দে র সবচে য়ে | নি চে র tone 3000 Hz-এর 3f = 9000 Hz, যা সবচে য়ে | উঁচু tone 8750
Hz-এর উপরে । তা ই harmonic কখনো | অন্য tone-এর জা য়গা য় পড়ে | না ।

# f_c = 1 / (2π · R_th · C1), R_th = R1 ∥ RV1 = (4.7k × 10k)/(4.7k +

# 10k) = 3.2 kΩ

# f_c = 1 / (2π × 3.2 kΩ × 3.3 nF) ≈ 15 kHz

Low-pass corner। 15 kHz-এর নি চে র (আমা দে র tone) প্রা য় পুরো টা যা য়, উপরে র harmonic কমে ।

# gain_divider = RV1 / (R1 + RV1) = 10 / 14.7 = 0.68 → RV1-এর মা থা য় 2.10 ×

# 0.68 ≈ 1.43 V peak

# f_HP = 1 / (2π (R1 + RV1) C2) = 1 / (2π × 14.7 kΩ × 1 µF) ≈ 11 Hz

C2 শুধু DC আটকা য়। 11 Hz-এর উপরে র সব কি ছু (আমা দে র tone) সহজে যা য়।

# PAM8403 gain ≈ 24 dB = ×15.8, BTL max peak ≈ V_supply = 5 V

# P_sine = V_peak² / (2 R) = 5² / (2 × 4) ≈ 3.1 W (clip হওয়া র ঠি ক আগে )

# V_in দরকা র = V_out / gain = 4 V / 15.8 ≈ 0.25 V peak → RV1 প্রা য় 18% ঘুরানো

তা ই RV1 একদম নি চ থে কে | শুরু করবে , আস্তে | আস্তে | বা ড়া বে । যে খা নে | শব্দ আর বাড়ে | না , বরং কর্কশ হয়, সে খা নে | clip শুরু; তা র একটু নি চে রা খবে । 4 V peak
হলে | 4²/(2×4) = 2 W।
BTL সতর্কতা : PAM8403/PAM8610-এর output-এর দুই পা শে ই signal থা কে | (একটা উঠলে | অন্য টা না মে )।
Speaker-এর কো | নো | তা র কখনো | GND-এ লা গা বে | না , আর দুটো | channel-এর OUT− একসা থে | জো | ড়া দে বে | না ।
দি লে | amp-এর output short হয়ে | amp গরম হবে | বা পুড়ে | যা বে । Speaker-এর দুই তা র শুধু L+ আর L−-এ যা বে ।
6.3 বে শি জো | র লা গলে : PAM8610
PAM8403 যথে ষ্ট না হলে | (scope-এ q < 10 dB, অধ্যা য় 18) PAM8610 module 12 V buck থে কে | চা লা ও। এতে | 12 V
BTL, অর্থা ৎ max ≈ 12²/(2×4) = 18 W (তা ত্ত্বি ক)। কি তুন্ মনে | রা খো | , power বা ড়লে | heat-ও বা ড়ে । প্রথমে | gain বা ড়া ও,
transducer coupling ঠি ক করো | (অধ্যা য় 8), তা রপর power। PAM8610-এ heat sink লা গা বে । Module-এ MUTE/SD
pin থা কলে | PIN_AMP_ENABLE দি য়ে | ESP32 শুধু পা ঠা নো | র সময় amp চা লু রা খবে ।

7. Speaker গরম হচ্ছে | কে | ন, আর সমা ধা ন
Speaker-এর voice coil আসলে | একটা তা মা র তা রে র কুণ্ডলী , যা র resistance R (car speaker-এ ~3.2–4 Ω)। Coil-এ
যত electrical power যা য়, তা র প্রা য় পুরো | টা ই (৯৯%-এর বে শি ) তা প হয়। শব্দ হয় খুব সা মা ন্য (speaker-এর efficiency
~১%)। তা ই প্রশ্ন হলো | , coil-এ অদরকা রি power কো | থা থে কে | আসছে ।
7.1 কা রণ 1 (সবচে য়ে | সা ধা রণ): DC current
অনে কে | speaker-এর এক মা থা GND-এ রে খে | transistor/MOSFET বা L298N-এর এক অং শ দি য়ে | 0 আর V-এর মধ্যে
on/off করে । এই signal-এর গড় মা ন V/2, মা নে | coil-এ একটা স্থা য়ী DC current চলে । DC-তে | cone একপা শে | ঠে লে | থে মে
থা কে | , কো | নো | শব্দ হয় না , কি তুন্ I²R তা প হয়।

# P_total = d · V² / R (d = duty cycle = 0.5)

P_DC = (d·V)² / R ← শুধু তা প, কো | নো | শব্দ নয়

# P_tone = (2V/π)² / (2R) ← কা জে র অং শ

12 V, 4 Ω হলে | P_total = 0.5 × 144 / 4 = 18 W, P_DC = 36/4 = 9 W, P_tone = 7.3 W, বাকি 1.7 W harmonic। অর্থা ৎ অর্ধে কর্ধে
power সরা সরি তা প। Box বন্ধ থা কলে | এই তা প বে র হওয়া রও জা য়গা পা য় না ।
চি ত্র 7.1: পুরনো | পদ্ধ তি বনা ম নতুন। নতুন পদ্ধ তি তে | গড় power প্রা য় ১৮ ভা গে র এক ভা গ।
7.2 কা রণ 2: সা রা ক্ষণ বা জা নো | (100% duty)
Tone একটা না বা জা লে | coil ঠা ন্ডা | হওয়া র সময় পা য় না । আমা দে র packet মা ত্র 1.28 s। Firmware-এর heat guard
প্রতি বা র পা ঠা নো | র পর বা ধ্য তা মূলক বি শ্রা ম দে য়:

# t_rest = t_on · (1 − d) / d

# P_avg = P_on · d

d = MAX_TX_DUTY (config.h, default 0.5)। 1.28 s packet-এর পর অন্তত 1.28 s চুপ। P_on = 2 W হলে গড় 1 W।

## Speaker-এর rating সা ধা রণত 20–50 W, তা ই এটা খুবখুই নি রা পদ।

# 7.3 কা রণ 3: Amp clip করা

Input বে শি হলে | amp-এর output square হয়ে | যা য় (clipping)। একই peak voltage-এ square wave-এর power
sine-এর দ্বি গুণ (V²/R বনা ম V²/2R), আর বা ড়তি অং শটা harmonic, যা কা জে | লা গে | না । RV1 দি য়ে | clip-এর নি চে | রা খো | ।

# 7.4 কা রণ 4: ভুল driver

L298N-এর ভে তরে | transistor-এ 2–3 V voltage drop হয়। 1.5 A-তে | সে টা 3–4.5 W, যা শুধু L298N-কে | গরম করে ।
সা থে | চলে | উপরে র DC সমস্যা । Class-D amp-এর efficiency ~৯০%, তা ই এই সমস্যা | থা কে | না ।
7.5 কা রণ 5: বন্ধ | box, তা প বে র হওয়া র পথ নে ই

# ΔT = P_avg × R_th

R_th = thermal resistance (°C/W): প্রতিপ্রতি watt-এ তা পমা ত্রা কত বাড়ে । বা তা স ভা লো | insulator, তা ই বন্ধ box-এ R_th অনে ক বে শি ।
উদা হরণ (ধরে | নে ওয়া মা ন): R_th = 10 °C/W হলে | পুরনো | পদ্ধতি র 9 W DC → 90 °C বে শি ! নতুন পদ্ধতি র 1 W → 10 °C। সমা ধা ন: speaker-এর
magnet থে কে | একটা aluminium পা ত box-এর দে য়া ল পর্যন্তর্য | লা গা ও (চি ত্র 8.1)। দে য়া লে র ওপা শে | পা নি খুবখু | ভা লো | ঠা ন্ডা করে ।
7.6 Coil-এর তা পমা ত্রা নি জে | মা পা র উপা য়

# R(T) = R₀ (1 + α ΔT), α_copper = 0.00393 /°C

# ΔT = (R_hot / R_cold − 1) / 0.00393

Multimeter দি য়ে | speaker-এর resistance ঠা ন্ডা অবস্থা য় মা পো | (ধরো | 3.4 Ω)। কি ছুক্ষণ চা লি য়ে | amp খুলেখুলে সা থে | সা থে | আবার মা পো | (ধরো | 4.1
Ω)। তা হলে | ΔT = (4.1/3.4 − 1)/0.00393 ≈ 52 °C। 60–70 °C-এর বে শি বা ড়লে | MAX_TX_DUTY বা volume কমা ও।
Checklist: (1) class-D BTL amp, speaker GND-এ নয়; (2) C2 দি য়ে | DC block; (3) RV1-এ clip-এর নি চে ; (4)
MAX_TX_DUTY 0.5 বা কম; (5) magnet থে কে | দে য়া লে | তা পে র পথ; (6) R মে পে | তা পমা ত্রা দে খা ।

8. Speaker box: পা নি তে | শব্দ বে র করা
Speaker বন্ধ | box-এ আছে । Cone নড়লে | box-এর ভে তরে র বা তা স নড়ে , বা তা স box-এর দে য়া ল না ড়া য়, দে য়া ল পা নি
না ড়া য়। বা তা স আর পা নি র মধ্যে | impedance-এর বি শা ল পা র্থক্য (অধ্যা য় 9.1), তা ই এখা নে ই সবচে য়ে | বে শি শক্তি হা রা য়।
উপা য় হলো | দে য়া লে র একটা অং শকে | হা লকা ও পা তলা "জা না লা " বা না নো | , যা নি জে | drum-এর মতো | কাঁ পে ।
চি ত্র 8.1: Speaker-এর মুখ পা তলা acrylic জা না লা র দি কে | , মা ঝে | ফাঁ ক, magnet থে কে | দে য়া ল পর্যতন্ তা পে র পথ।
Speaker-এর মুখ একটা পা তলা , শক্ত জা না লা র দি কে | রা খো | (3 mm acrylic/polycarbonate)। জা না লা যত পা তলা
আর হা লকা , তত ভা লো | শব্দ যা য়, কি তুন্ গভী রতা য় চা প সহ্য করতে | হবে | (নি চে র formula)।
Cone আর জা না লা র মা ঝে | অতন্ত 10 mm ফাঁ ক রা খো | , কা রণ গভী রে | জা না লা ভে তরে | বাঁ কে | ।
Box-এর বা কি দে য়া ল মো | টা আর শক্ত রা খো | , O-ring দি য়ে | seal করো | ।
(Advanced) পুরো | box তে লে | ভরে | rubber diaphragm দি লে | coupling আর cooling দুটো | ই অনে ক ভা লো | হয়।
কি তুন্ এটা বা না নো | কঠি ন, তে ল চুঁইয়ে | পড়া র ঝুঁকি আছে , আর cone তে লে | ভি জে | যা য়। প্রথম version-এ এটা কো | রো | না ।
(বি কল্প পরী ক্ষা ) একটা piezo disc-কে | ও speaker হি সে বে | চা লা নো | যা য় (amp-এর output সরা সরি piezo-তে )। 3–6
kHz-এ পা নি তে | এটা ভা লো | কা জ করে । Car speaker-এর সা থে | তুলনা করতে | পা রো | ।

## 8.1 গভী রতা য় চা প ও জা না লা র পুরু ত্ব

# P = ρ · g · h

5 m গভী রে P = 1000 × 9.81 × 5 ≈ 49 kPa (≈ 0.49 bar)। জা না লা র প্রতিপ্রতি বর্গ সে ন্টি মি টা রে প্রা য় 0.5 kg-এর ভা র।

# D = E t³ / (12 (1 − ν²))

w_max = P a⁴ / (64 D) (কি না রা | আটকা নো | গো ল plate-এর মা ঝখা নে | কতটা বাঁকে )
σ_max = 3 P a² / (4 t²) (সবচে য়ে | বে শি stress, কি না রা য়)
a = জা না লা র ব্যা সা র্ধ,র্ধ | t = পুরু ত্ব।ত্ব | Acrylic: E ≈ 3 GPa, ν ≈ 0.37, tensile strength ≈ 70 MPa।

উদা হরণ, 5 m গভী রে : 10 cm জা না লা (a = 5 cm), t = 3 mm → w ≈ 0.6 mm, σ ≈ 10 MPa (safety factor ≈ 7) ✔।

15 cm জা না লা (a = 7.5 cm), t = 3 mm → w ≈ 3.1 mm, σ ≈ 23 MPa (safety factor ≈ 3, একটু বে শি বাঁকে )। t = 5 mm হলে | w
≈ 0.7 mm, σ ≈ 8 MPa ✔। তা ই 3 m-এর বে শি গভী রে বড় জা না লা র জন্য 4–5 mm না ও। এগুলো | মো টা মুটি হি সা ব (ছো | ট deflection ধরে ), পা নি তে
না মা নো র আগে | বা লতি বা অগভী র পা নি তে | leak test করবে ।

9. Piezo hydrophone: বা না নো | ও seal করা
9.1 Seal করলে | শব্দ ঢুকবে | কে | ন (physics)
শব্দ হলো | চা পে র ঢে উ। এক পদা র্থ থে কে | অন্য পদা র্থে | ঢো | কা র সময় কতটা ঢুকবে | আর কতটা ফে | রত যা বে , সে টা নি র্ভর করে | দুই

## পদা র্থে র acoustic impedance-এর উপর:

# Z = ρ · c (ঘনত্ব × শব্দে র গতি , একক Rayl)

# T = 4 Z₁ Z₂ / (Z₁ + Z₂)² (কত ভা গ শক্তি ঢো কে )

পা নি Z ≈ 1.48 MRayl। Epoxy ≈ 3.0 → T ≈ 0.89 (৮৯% ঢো কে )। Silicone rubber ≈ 1.05 → T ≈ 0.97। Mineral/baby oil

# ≈ 1.2 → T ≈ 0.99। বা তা স ≈ 0.0004 → T ≈ 0.001 (০.১%!)।

তা ই কো | টিং কো | নো | সমস্যা না , সমস্যা | শুধু বা তা স। আর কো | টিং যে হে তু wavelength (5 kHz-এ 300 mm)-এর তুলনা য় খুবখু | পা তলা (2–3 mm), শব্দ তা র
মধ্য দি য়ে | প্রা য় না থে মে | চলে | যা য়।
9.2 Piezo disc কী ভা বে | শব্দ ধরে
Piezo disc-এ একটা পি তলে র (brass) প্লে টে র উপর পা তলা ceramic লা গা নো | থা কে | । চা প পড়ে | ceramic একটু বাঁ কলে
তা র দুই পা শে | voltage তৈ রি হয় (piezoelectric effect)। পা নি র চা পে র ঢে উ disc-কে | বাঁ কা য়, তা ই disc থে কে | millivolt
মা পে র signal আসে । Disc বৈ দ্যু তি কভা বে | একটা ছো | ট capacitor-এর মতো | (প্রা য় 10–30 nF), তা ই এর পরে | high-

## impedance input (1 MΩ) লা গে ।

9.3 বা না নো | র ধা প

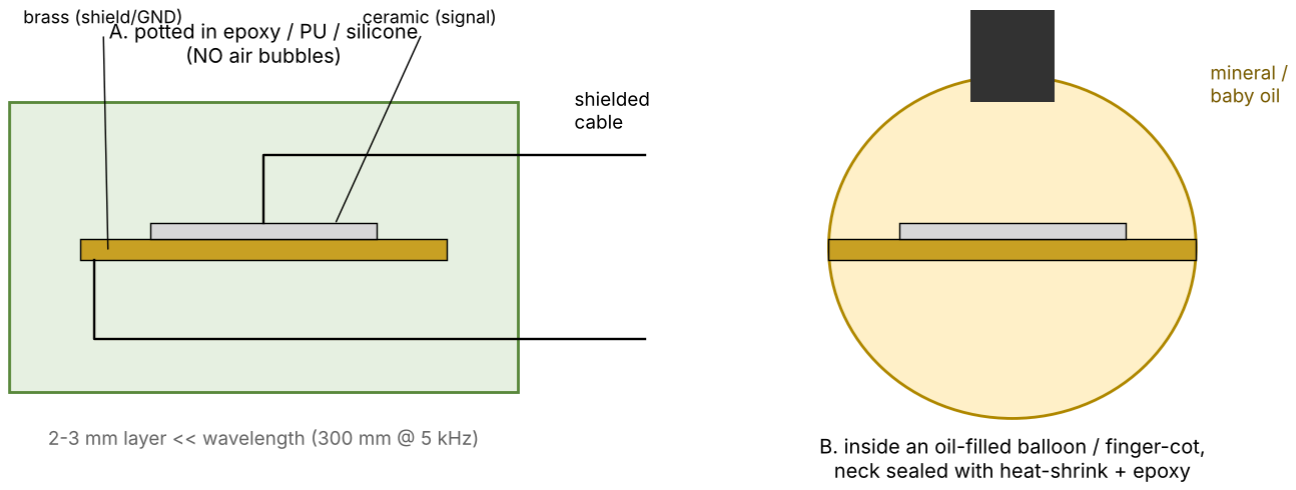
[picture p9: figure]

চি ত্র 9.1: দুটো | পদ্ধ তি । A: epoxy/silicone-এ ডুবা নো | (potting)। B: তে লভর্তি balloon/finger-cot।
1. Cable: shielded cable (mic cable)। ভে তরে র তা র ceramic (রু পা লি ) অং শে , shield/braid brass-এর কি না রা য়।
Ceramic-এ খুব দ্রু ত (২–৩ সে কে | ন্ড | ) solder করো | , বে শি তা পে | রু পা লি স্তর উঠে | যা য়।
2. পরি ষ্কা | র: isopropyl alcohol দি য়ে | তে ল আর flux মুছে | ফে | লো | , শুকা তে | দা ও।
3. Strain relief: cable-কে | disc-এর কা ছে | একটু গিঁ ট দি য়ে | বা heat-shrink দি য়ে | আটকে | দা ও, যা তে | টা ন solder-এ না

পড়ে ।

4. পদ্ধ তি A (epoxy/silicone potting): একটা ছো | ট ছাঁ চে | (বো | তলে র ছি পি , PVC end cap) disc দাঁ ড় করি য়ে | রা খো | । 2-
part epoxy ধী রে | ধী রে | এক কো | ণ থে কে | ঢা লো | , যা তে | বা তা স বে র হয়ে | যে তে | পা রে । Disc-এর দুই পা শে | 2–3 mm স্তর
রা খো | । Bubble দে খলে | টুথপি ক দি য়ে | ফা টি য়ে | দা ও। হা লকা গরম জা য়গা য় (hair dryer দূর থে কে | ) রা খলে | epoxy পা তলা

হয় আর bubble সহজে | ওঠে । পুরো | ২৪ ঘণ্টা | শুকা তে | দা ও।
সস্তা | বি কল্প: liquid electrical tape / Plasti Dip-এ ৩–৪ বা র ডুবি য়ে | পা তলা স্তর, প্রতি বা র শুকি য়ে | নি য়ে । Hot glue-ও

## চলে , কি তুন্ bubble থা কা র সভাম্ভাবনা বে শি ।

5. পদ্ধ তি B (তে ল): finger-cot বা ছো | ট balloon-এ baby/mineral oil ভরে | disc ডো | বা ও। Bubble বে র করে | দা ও,
তা রপর মুখটা cable-এর উপর heat-shrink + epoxy দি য়ে | বন্ধ | করো | । তে ল খুব ভা লো | impedance match, আর
disc-এর উপর কো | নো | শক্ত স্তর না থা কা য় disc সবচে য়ে | ভা লো | বাঁ কে | ।
6. Cable-এর মুখ seal: cable যে খা নে | বে র হচ্ছে | সে খা নে | epoxy বা adhesive heat-shrink, যা তে | পা নি তা রে র ভে তর
দি য়ে | না ঢো | কে | ।
7. পরী ক্ষা : বা লতি র পা নি তে | রে খে | বা লতি র গা য়ে | টো | কা দা ও, firmware-এর scope -এ level লা ফা লে | ঠি ক আছে । একদি ন
পা নি তে | রে খে | দে খো | multimeter-এ disc-এর দুই তা রে র মধ্যে | resistance অসী ম আছে | কি না (leak নে ই)।
Mounting: hydrophone-কে | ROV-এর frame থে কে | নরম রা বা র বা foam দি য়ে | আলা দা করে | লা গা ও, thruster
থে কে | যত দূরে | সভম্ব। Frame-এর মধ্য দি য়ে | motor-এর কম্পন সরা সরি piezo-তে | গে লে | noise অনে ক বা ড়ে । নি জে | র
speaker-এর box থে কে | ও দূরে | রা খো | ।
"Speaker-এর receiver"-এর ব্যা পা রে : একটা speaker-কে | ও উল্টো | দি কে | microphone হি সে বে | ব্য বহা র করা
যা য়, কি তুন্ বন্ধ | box-এর ভে তরে | থা কলে | পা নি র শব্দ খুব কম পৌঁ | ছা য় (বা তা সে র ফাঁ কে | র কা রণে , 9.1)। Piezo সরা সরি
পা নি র সং স্পর্শে | থা কে | , তা ই অনে ক ভা লো | । Receiver হি সে বে | piezo-ই ব্য বহা র করো | ।

# 10. Receiver preamp circuit

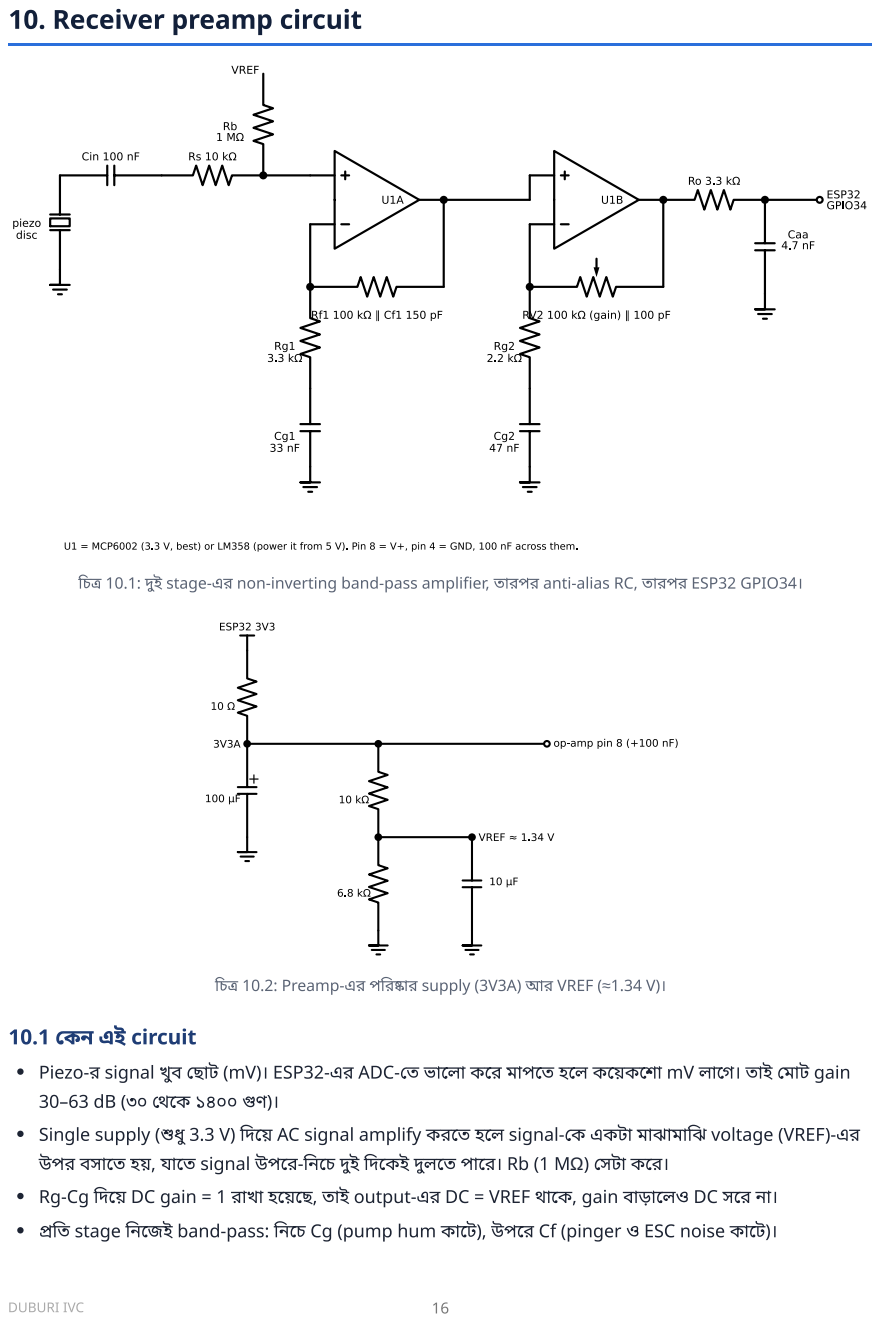
[picture p10: page 16]
চি ত্র 10.2: Preamp-এর পরি ষ্কা; র supply (3V3A) আর VREF (≈1.34 V)।; ন এই circuit; Piezo-র signal খুব ছো; ট (mV)। ESP32-এর ADC-তে; ট gain; Single supply (শুধু 3.3 V) দি য়ে; AC signal amplify করতে; signal-কে; একটা মা ঝা মা ঝি voltage (VREF)-এর; উপর বসা তে; signal উপরে -নি চে; DC gain = 1 রা খা হয়ে ছে , তা ই output-এর DC = VREF থা কে; , gain বা ড়া লে ও DC সরে; প্রতি stage নি জে; ই band-pass: নি চে; Cg (pump hum কা টে ), উপরে; Cf (pinger ও ESC noise কা টে )।

চি ত্র 10.1: দুই stage-এর non-inverting band-pass amplifier, তা রপর anti-alias RC, তা রপর ESP32 GPIO34।

Ro-Caa: ADC-র আগে | শে ষ low-pass (anti-alias), আর op-amp-কে | ADC-র input থে কে | রক্ষা করে ।

# 10.2 Formula ও মা ন

# VREF = 3.3 × 6.8k / (10k + 6.8k) = 1.34 V

কে ন 1.65 V (মা ঝখা ন) না : ESP32 ADC (12 dB attenuation) প্রা য় 0.15–2.45 V-এ সবচে য়ে | সো | জা (linear) মা পে । তা র মা ঝখা ন ≈ 1.3 V,
দুইদু | দি কে | ±1.1 V জা য়গা থা কে ।

# G = 1 + Rf / Rg (non-inverting gain)

# Stage 1: G₁ = 1 + 100k/3.3k = 31.3 (29.9 dB)

Stage 2: G₂ = 1 + RV2/2.2k = 1 … 46.5 (0 … 33 dB, RV2 দি য়ে | বদলা নো | যা য়)

# মো ট: 30 dB … 63 dB

# f_HP = 1/(2π Rg Cg): stage 1 → 1/(2π·3.3k·33n) = 1.46 kHz; stage 2 →

# 1/(2π·2.2k·47n) = 1.54 kHz

# f_LP = 1/(2π Rf Cf): stage 1 → 1/(2π·100k·150p) = 10.6 kHz; stage 2 →

# 1/(2π·100k·100p) = 15.9 kHz (RV2 max)

# Anti-alias: 1/(2π·3.3k·4.7n) = 10.3 kHz

# Input HP: 1/(2π · Rb · (Cin ∥series C_piezo)) ≈ 10 Hz

ফলে | 3–8.75 kHz-এর tone পুরো | gain পা য়। 100 Hz pump hum প্রা য় 45 dB কমে , 35 kHz pinger প্রা য় 27 dB কমে | (চি ত্র 10.3)।
চি ত্র 10.3: Preamp-এর frequency response (RV2 মা ঝা মা ঝি )। নী ল অং শে | আমা দে র tone।

# GBW ≥ G × f_max = 46.5 × 10 kHz ≈ 0.47 MHz

## Op-amp-এর gain-bandwidth product। MCP6002 = 1 MHz ✔। LM358 ≈ 0.7–1 MHz, চলবে ।

# 10.3 Op-amp বা ছা ই ও pin

| MCP6002 (ভা লো ) | LM358 (বি কল্প)
Supply | 3V3A (3.3 V) | 5 V (3.3 V-এ output 1.8 V-এর উপরে উঠতে পা রে না )
Output swing | rail-to-rail (0–3.3 V) | 0 থে কে Vcc−1.5 V
Pin | দুটো রই pin এক: 1 = OUT A, 2 = −IN A, 3 = +IN A, 4 = GND, 5 = +IN B, 6 = −IN B, 7 = OUT B, 8 = V+
LM358 5 V-এ চা লা লে | output 3.5 V পর্যতন্ যে তে | পা রে । Ro (3.3 kΩ) current সী মি ত রা খে , তা ই ESP32-এর pin নি রা পদ
থা কে | । তবুও MCP6002 পে লে | সে টা ই ব্য বহা র করো | । Pin 8 আর pin 4-এর মধ্যে | যত কা ছে | সভম্ব 100 nF লা গা ও।
GPIO34 কে | ন: ESP32-এর DMA ADC শুধু ADC1-এ (GPIO32–39) কা জ করে । GPIO34 শুধু input pin, এতে
কো | নো | internal pull-up নে ই, তা ই analog-এর জন্য একদম ঠি ক।

# 11. Noise filtering: তি ন তস্র

Noise-এর উৎস | কে মন | কো ন তস্রে আটকা য়
Pool pump/filter | নি চু frequency (<1–2 kHz), 100 Hz hum | Band choice + preamp HP
Thruster (প্রপে লা র) | সব frequency জুড়ে , ঢে উয়ে র মতো ওঠা না মা | Narrowband Goertzel + whitening + code
ESC/motor whine | একটা নি র্দি ষ্ট tone (যে মন 8 kHz) | Per-tone noise floor (whitening)
টো কা , ধা ক্কাক্কা (click) | খুব ছো ট কি তুন্ জো রা লো | Interleaving + Viterbi
RoboSub pinger | 25–40 kHz, 4 ms pulse | Preamp LP + Fs = 50 kHz (alias বা ইরে পড়ে )
Echo (reverberation) | নি জে র signal-এর দে রি তে আসা কপি | Frequency hopping + interleaving + code
বি দ্যু তে র noise (buck, ESC) | তা রে ঢো কা | Shielded cable, star ground, আলা দা buck, LC filter

# 11.1 তস্র 1: Hardware

Preamp band-pass (অধ্যা য় 10), anti-alias RC, shielded cable (shield শুধু preamp-এর GND-এ, এক প্রা ন্তে ),

আলা দা power, hydrophone-কে | frame থে কে | কম্পন-বি চ্ছি ন্ন | রা খা ।

# 11.2 তস্র 2: Sampling আর aliasing

# Fs > 2 · f_max (Nyquist)

f_alias = | f − k · Fs | (k = সবচে য়ে | কা ছে র পূর্ণসংর্ণ | সংখ্যা )
ADC Fs-এর অর্ধে কের্ধেকের উপরে র frequency ধরতে | পা রে না , সে গুলো | ভুল করে নি চে র frequency হি সে বে | দে খা দে য় (alias)। Fs = 50 kHz হলে | 35
kHz pinger → |35 − 50| = 15 kHz, আমা দে র band (3–8.75 kHz)-এর বা ইরে ✔। Fs = 40 kHz হলে | একই pinger → 5 kHz,
ঠি ক আমা দে র tone-এর উপর ✘। তা ই 50 kHz বে ছে | নে ওয়া হয়ে ছে । Band-এ alias হয়ে | ঢুকতে | পা রে শুধু 41.25–47 kHz-এর শব্দ, যা preamp
~31–33 dB কমি য়ে | দে য়।

# 11.3 তস্র 3: Software (DSP)

Goertzel (narrowband filter): প্রতি টা tone-এর জন্য মা ত্র ~94 Hz চওড়া একটা "জা না লা " দি য়ে | শো | নে । 6 kHz
band-এর noise-এর মা ত্র 94/6000 ভা গ ঢো | কে | । এটা ই processing gain:

# PG = 10 log₁₀(B_band / B_bin) = 10 log₁₀(6000 / 94) ≈ 18 dB

তা ই wideband SNR −6 dB হলে ও প্রতিপ্রতি tone-এ ~১০ dB SNR পা ওয়া যা য় (Hann window আর echo-র ক্ষতি বা দ দি য়ে )।

Whitening (per-tone noise floor): প্রতি টা tone-এর জন্য আলা দা noise floor মনে | রা খা হয়। কো | নো | tone-এর
জা য়গা য় সবসময় একটা whine থা কলে | সে ই tone-এর floor বে ড়ে | যা য়, তা ই whine আর "জয়ী " হয় না (অধ্যা য় 14.3)।
Ratio-ভি ত্তি ক সি দ্ধা | তন্: কো | ন tone বে জে | ছে , সে টা নি র্ধা রণ হয় চা রটা tone-এর মধ্যে | তুলনা করে , কো | নো | fixed
threshold দি য়ে | না । তা ই signal জো | রে | বা আস্তে | , যা ই আসুক, কা জ করে ।

# 11.4 তস্র 4: Protocol

Frequency hopping: পরপর slot আলা দা frequency set ব্য বহা র করে । ফলে | আগে র slot-এর echo পরে র slot-
এর হি সা বে | ঢো | কে | না ।

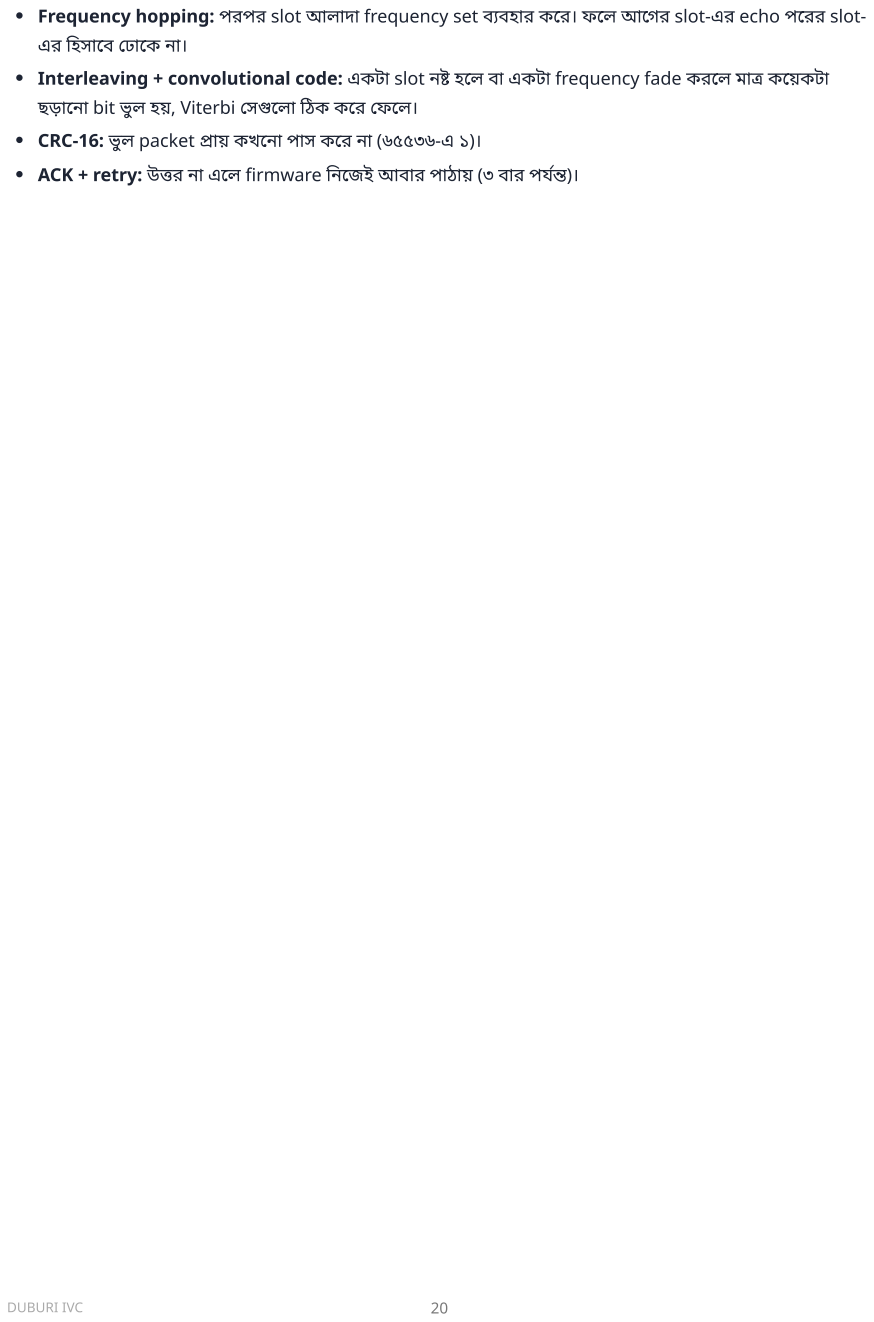
[picture p11: page 20]
Interleaving + convolutional code: একটা slot নষ্ট হলে; বা একটা frequency fade করলে; bit ভুল হয়, Viterbi সে গুলো; CRC-16: ভুল packet প্রা য় কখনো; ACK + retry: উত্তর না এলে; firmware নি জে; ই আবা র পা ঠা য় (৩ বা র পর্যতন্)।

# 12. Signal design: tone, slot, hopping

# 12.1 Tone-এর তা লি কা

# f_k = 3000 + 250 · k Hz, k = 0 … 23 → 3000, 3250, …, 8750 Hz

12.2 কে | ন 250 Hz পরপর, কে | ন 16 ms window

# N = Fs × T_win = 50000 × 0.016 = 800 sample

# Δf_bin = Fs / N = 50000 / 800 = 62.5 Hz

250 Hz = 4 × 62.5 Hz → প্রতিপ্রতিটা tone ঠি ক একটা "bin"-এর উপর, পা শা পা শি tone-এর মধ্যে 4

## bin ফাঁ ক

একই window-এ পূর্ণসংর্ণ | সংখ্য ক bin দূরে র দুটোদুটো tone একে | অপরকে | "দে খে " না (orthogonal)। 4 bin ফাঁ ক থা কা য় ADC-র clock একটু ভুল হলে ও
(±1–2%) বা Hann window দি লে ও tone মি শে | যা য় না ।

# 12.3 Slot আর window

প্রতি টা slot 20 ms, কি তুন্ receiver মা ঝে | র 16 ms (800 sample) দে খে । দুই পা শে | 2 ms করে | margin থা কে | , যা তে
timing একটু এদি ক-ওদি ক হলে ও পা শে র slot ঢুকে | না পড়ে ।

# 12.4 Frequency hopping set

# set s = { s, s+6, s+12, s+18 }, s = 0 … 5

slot i ব্য বহা র করে | set (i mod 6); 2 bit মা ন v (0–3) → tone = s + 6v
উদা হরণ: set 0 = {3000, 4500, 6000, 7500 Hz}, set 1 = {3250, 4750, 6250, 7750 Hz}। একই set আবার আসে | 6 slot = 120
ms পরে , ততক্ষণে আগে র echo অনে ক কমে | যা য় (চি ত্র 2.1)। Set-এর ভে তরে tone-গুলো | 1500 Hz দূরে , তা ই কো | নো | এক জা য়গা র fading একসা থে
চা রটা কে | নষ্ট করে না ।

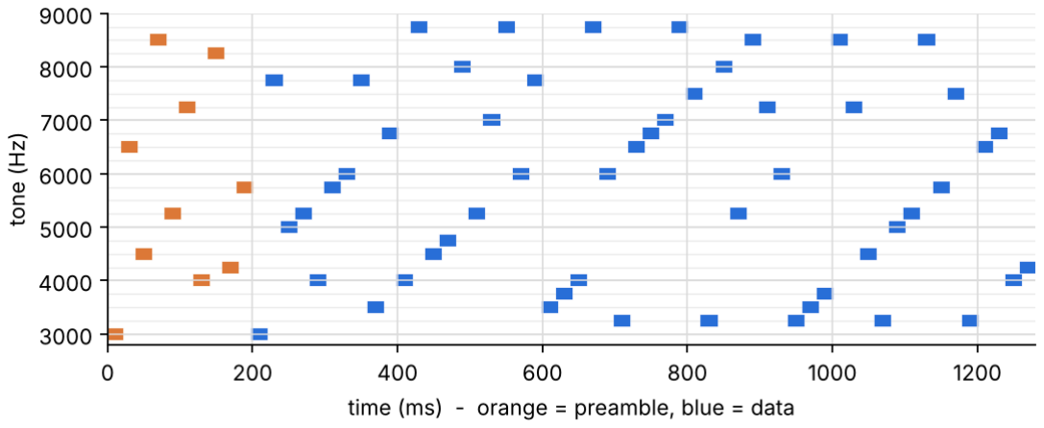
[picture p12: figure]

চি ত্র 12.1: একটা packet-এর সময়-frequency নকশা । কমলা = preamble (10 slot), নী ল = data (54 slot)।

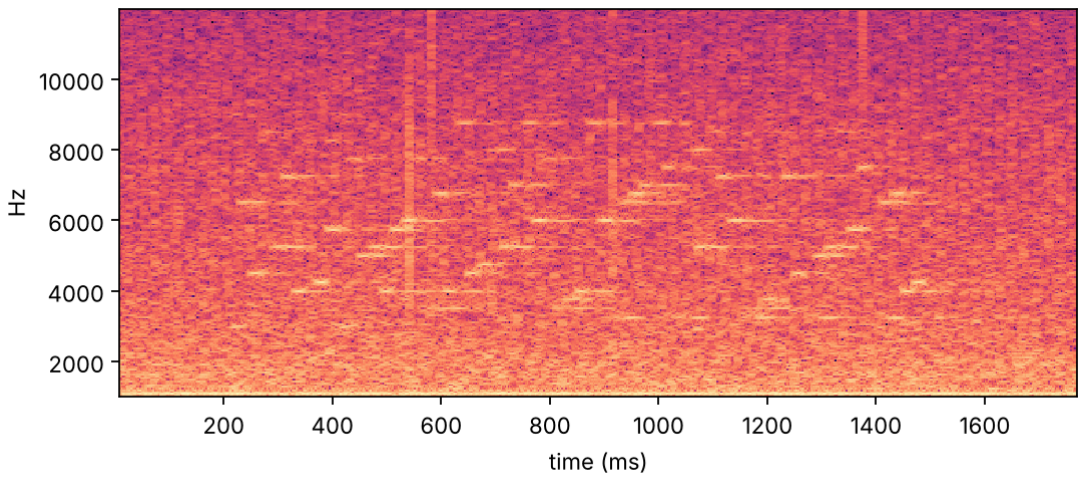
[picture p13: figure]

চি ত্র 12.2: Virtual pool-এ (echo + pump + thruster + pinger, SNR 0 dB) ADC যা দে খে তা র spectrogram।

# 12.5 Preamble

Preamble হলো | 10টা আলা দা tone-এর একটা নি র্দি ষ্ট | ক্র ম: 3000, 6500, 4500, 8500, 5250, 7250, 4000, 8250,
4250, 5750 Hz। Receiver সা রা ক্ষণ এই ক্র মটা খোঁ | জে | । এটা বে ছে | নে ওয়া হয়ে ছে | তি নটা নি য়ম মে নে | (code-এ test আছে ):
1. পা শা পা শি slot-এর tone অনে ক দূরে , যা তে | একটা র echo পরে রটা র মতো | না শো | না য়।
2. অন্য packet-এর data কো | নো | ভা বে ই 10টা র মধ্যে | 2টা র বে শি slot মে লা তে | পা রে | না , তা ই data দে খে | ভুল করে | "packet
শুরু " ধরে | নে ওয়া হয় না ।
3. Preamble-এর কো | নো | tone-এর set, সে ই packet-এর data অতন্ত 6 slot (120 ms) পরে | ব্য বহা র করে ।

Simulation-এ প্রথম version-এ এই নি য়ম ছি ল না , তখন preamble-এর echo প্রথম data slot নষ্ট করছি ল। এটা

## ধরা পড়া র পর ঠি ক করা হয়ে ছে ।

# 12.6 Data rate

# raw = 2 bit / 20 ms = 100 bit/s; code rate ½ → 50 bit/s

একটা packet = 64 slot × 20 ms = 1.28 s, এতে | 4 byte payload (32 bit) →
কা র্যকর্য | র ≈ 25 bit/s
কম মনে | হতে | পা রে , কি ন্তু "LED on", "start mission 3", "আমি gate পা র হয়ে ছি " জা তী য় command-এর জন্য যথে ষ্ট, আর echo-ভর্তি pool-এ

নি র্ভরর্ভযো গ্য তা অনে ক বে শি জরুরি ।

# 13. Packet, CRC, error correction

# 13.1 Packet-এর গঠন (6 byte)

Byte | বি ট 7–4 | বি ট 3–0
0 | dst (কা কে , 15 = সবা ইকে ) | src (কে পা ঠা ল)
1 | seq (0–15, repeat চে না র জন্য ) | flags: 8 = ACK চা ই, 4 = এটা ACK
2 | cmd (0–255): 1 = LED on, 2 = LED off, 3 = toggle, 4 = ping, 10–255 তো মা র নি জে র
3 | arg (0–255)
4–5 | CRC-16 (byte 0–3-এর উপর)

# 13.2 CRC-16

# g(x) = x¹⁶ + x¹² + x⁵ + 1 (0x1021), শুরুর মা ন 0xFFFF ("CRC-16/CCITT-

# FALSE")

Data-কে | একটা বড় binary সং খ্যা ধরে g(x) দি য়ে | ভা গ করলে | যে ভা গশে ষ থা কে , সে টা ই CRC। Receiver নি জে | আবার হি সা ব করে | মে লা য়। এক-দুইদু | bit
ভুল সবসময় ধরা পড়ে , এলো | মে লো | ভুল ধরা পড়ে | 65535/65536 বার। পরী ক্ষা র মা ন: "123456789" → 0x29B1 (unit test-এ যা চা ই করা)।

# 13.3 Convolutional code (K = 7, rate ½)

48 bit (6 byte)-এর পরে | 6টা শূন্য ("tail") যো | গ করে | 54 bit বা না নো | হয়। প্রতি টা bit একটা 7-ঘরে র shift register-এ
ঢো | কে | , আর প্রতি bit-এ 2টা output bit বে র হয়:

# reg = [নতুন bit, আগে র 6 bit]

# out₀ = parity(reg AND 1111001₂) (171 octal)

# out₁ = parity(reg AND 1011011₂) (133 octal)

parity = কয়টা 1 আছে | তা বি জো | ড় হলে | 1। প্রতিপ্রতিটা output bit আগে র 7টা input bit-এর উপর নি র্ভরর্ভ | করে , তা ই তথ্য অনে কগুলো | coded bit-এ
ছড়ি য়ে | থা কে । এই code-এর "free distance" 10: দুটোদুটো আলা দা message-এর coded রূপ কমপক্ষে | 10টা bit-এ আলা দা । তা ই কা ছা কা ছি নয়
এমন অনে ক ভুল ঠি ক করা যা য়। এটা NASA আর Wi-Fi-তে | ব্য বহৃতহৃ | বি খ্যা ত code। প্রথপ্র | মে | Hamming(8,4) code দি য়ে | design করা হয়ে ছি ল।
Simulation-এ দে খা গে ল convolutional code একই noise-এ অনে ক বে শি packet ঠি ক আনে | (−6 dB-এ ২৫% থে কে | ৯০%+), তা ই এটা
বে ছে | নে ওয়া হয়ে ছে ।

# 13.4 Interleaver

slot(c) = (37 · c) mod 54; c < 54 হলে | MSB, না হলে | LSB
c = coded bit-এর নম্বর (0–107)। পা শা পা শি coded bit (যে গুলো | Viterbi-র একসা থে | লা গে ) অন্তত 3 slot দূরে আর আলা দা frequency set-
এ যা য়। ফলে | একটা ঝাঁ কুনি (click) বা একটা faded frequency শুধু ছড়া নো | কয়ে কটা bit নষ্ট করে , যা Viterbi সবচে য়ে | ভা লো | ঠি ক করতে | পা রে ।

14. Receiver কী ভা বে | decode করে | (ধা পে | ধা পে )

# 14.1 DC সরা নো

# dc ← dc + (x − dc) / 1024; y = x − dc

# f_c ≈ Fs / (2π · 1024) = 50000 / 6434 ≈ 7.8 Hz

ADC-র sample-এ VREF (≈1600 count)-এর DC থা কে । এই এক লা ইনে র high-pass filter সে টা সরা য়।

# 14.2 Goertzel: একটা tone-এর শক্তি মা পা

# w[n] = 0.5 − 0.5 cos(2π (n + 0.5) / N) (Hann window)

# coef = 2 cos(2π f / Fs)

# s[n] = x[n]·w[n] + coef · s[n−1] − s[n−2]

# E = s[N−1]² + s[N−2]² − coef · s[N−1] · s[N−2]

Goertzel হলো | FFT-এর একটা মা ত্র bin হি সা ব করার সস্তা উপা য়: প্রতিপ্রতি sample-এ একটা গুণ আর দুটোদুটো যো গ। আমা দে র শুধু 24টা frequency দরকা র,
পুরো | FFT লা গে | না । Hann window কি না রা গুলো | নরম করে | দে য়, তা ই পা শে র tone-এর "leakage" কমে | (Fs একটু ভুল হলে ও)।

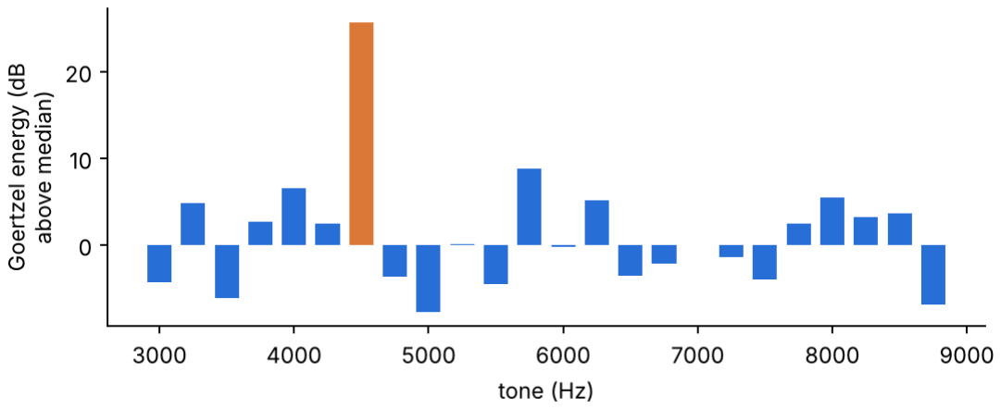
[picture p14: figure]

## চি ত্র 14.1: 4500 Hz tone + noise-এর উপর 24টা Goertzel। কমলা bin স্পষ্ট জয়ী ।

# 14.3 Whitening: প্রতি টা tone-এর নি জস্ব noise floor

# N_k ← N_k + (min(E_k, 8·N_k) − N_k) / 256 (প্রতিপ্রতি 2.5 ms)

# z_k = E_k / N_k

# SNR_k ≈ z_k − 1, q = 10 log₁₀(z − 1) dB

N_k হলো | tone k-এর গড় noise (exponential moving average, সময় ধ্রু বক 256 × 2.5 ms = 0.64 s)। শুধু packet না থা কা র সময়
শে খে । "min(…, 8N)" মা নে | হঠা ৎ জো | রালো | শব্দ (click বা নি জে র signal) floor-কে | বে শি টে নে | তুলতে | পা রে না । z_k বলে | tone k তা র স্বা ভা বি ক
noise-এর কত গুণ। ধ্রু ব whine থা কলে | N_k বড় হয়ে | যা য়, ফলে | whine-এর z ≈ 1 থা কে । Firmware যে | q print করে , সে টা এই SNR-এর

## median।

# 14.4 Preamble খোঁ জা

প্রতি 2.5 ms (H = 125 sample) পরপর শে ষ 16 ms-এর 24টা z হি সা ব হয়। প্রতি টা preamble slot j-এর tone p_j

## কতটা "জয়ী ", তা ভা গ হি সে বে মা পা হয়:

# frac_j(t) = z_{p_j}(t) / Σ_k z_k(t)

# score(t) = (1/10) Σ_{j=0..9} frac_j( t − (9 − j)·T_slot )

match(t) = কয়টা j-তে | p_j-ই 24টা র মধ্যে | সবচে য়ে | জো | রালো
শর্ত: score ≥ 0.14 এবং | match ≥ 5
শুধু noise থা কলে | প্রতিপ্রতি frac ≈ 1/24 ≈ 0.04, তা ই score ≈ 0.04। Preamble থা কলে | score 0.3–0.9। ভা গ ব্য বহা র করা য় পুরো | band-
জুড়ে | হঠা ৎ শব্দ (click) এলে | সব z একসা থে | বাড়ে , score বাড়ে | না । দুইদু | শর্ত একসা থে | থা কা য় 10 মি নি টে র কঠি ন noise-এ একবারও ভুল trigger হয়নি

(অধ্যা য় 17)।

# 14.5 Timing ঠি ক করা

Score-এর চূড়া একটু চ্যা প্টা | (window slot-এর চে য়ে | ছো | ট বলে )। Trigger-এর পরে | আরো | 14টা hop (35 ms)-এর score
রা খা হয়। তা রপর চূড়া র 85%-এর উপরে র অং শে র ভা রকে | ন্দ্র | (centroid) নে ওয়া হয়:

# c = Σ i · (score_i − 0.7·max) / Σ (score_i − 0.7·max)

# data slot i-এর window শে ষ হয়: e_i = sync + (i + 1) · S, S = Fs × 0.020

Data চলা র সময় early/late gate timing-কে | আস্তে | আস্তে | ঠি ক রা খে । জয়ী tone-এর শক্তি 1 ms আগে র ও পরে র
window-এ মা পা হয়, আর যে দি কে | বে শি সে দি কে | একটু সরা নো | হয়:

# err = (E_late − E_early) / (E_late + E_early); adj ← adj + 0.25 · D ·

# err (D = 1 ms, সী মা ±5 ms)

# 14.6 ADC-র আসল sample rate মা পা

# Fs_measured = (মো ট sample সং খ্যা ) / (সময়, µs) × 10⁶

# timing ভুল = (Fs ভুল) × packet দৈ র্ঘ্য

ESP32-এর ADC ঠি ক 50000 না , একটু কম-বে শি দে য়। 1% ভুল হলে | 1.28 s packet-এর শে ষে | timing 12.8 ms সরে যা য়, যা slot-এর
margin (2 ms)-এর অনে ক বে শি । তা ই firmware চলা র সময় ক্রমা গত sample গো নে | আর ESP32-এর নি জে র µs timer-এর সা থে | তুলনা করে ।
সময় যত বাড়ে , মা প তত নি খুঁতখুঁ | হয় (20 s পরে ≈0.05% → packet-এর শে ষে | 0.6 ms)। Simulation-এ ADC-কে | ইচ্ছা করে 2.4% দ্রু ত চা লি য়ে

test করা হয়ে ছে ।

# 14.7 Soft bit (LLR)

# L_MSB = max(ln z₀, ln z₁) − max(ln z₂, ln z₃)

# L_LSB = max(ln z₀, ln z₂) − max(ln z₁, ln z₃)

L > 0 মা নে | bit সম্ভবত 0, L < 0 মা নে | 1, আর |L| যত বড় তত নি শ্চি ত। শুধু 0/1 না দি য়ে | কতটা নি শ্চি ত সে টা ও Viterbi-কে | দে ওয়া হয় ("soft
decision")। এতে | hard decision-এর চে য়ে | প্রা য় 2 dB বে শি noise সহ্য হয়।

# 14.8 Viterbi decoding

# PM_new(s′) = max over predecessor s of [ PM(s) + (±L₀) + (±L₁) ]

64টা সম্ভা ব্য register অবস্থা র প্রতিপ্রতিটা র জন্য এখন পর্যন্তর্য | সবচে য়ে | মা না নসই পথটা মনে | রা খা হয় (PM = path metric)। প্রত্যাপ্র | ত্যা শি ত bit 0 হলে | +L, 1 হলে
−L যো গ হয়। শে ষে | tail-এর কা রণে অবস্থা 0-তে | শে ষ হওয়া পথটা পি ছন দি কে | (traceback) পড়ে | 54 bit ফি রে পা ওয়া যা য়। এটা ই maximum-
likelihood decoding: যে | message সবচে য়ে | সম্ভা ব্য , সে টা ই বে র হয়।

# 14.9 CRC আর কা জ

প্রথম 48 bit থে কে | 6 byte বা নি য়ে | CRC মে লা নো | হয়। মি ললে | packet queue-তে | যা য়, main loop LED জ্বা লা য় বা নি ভা য়,
দরকা র হলে | ACK পা ঠা য়। আর একই (src, seq) 15 s-এর মধ্যে | আবা র এলে | command দ্বি তী য়বা র চা লা নো | হয় না
(repeat), কি তুন্ ACK আবা র পা ঠা নো | হয়, কা রণ আগে র ACK হয়তো | হা রি য়ে | গি য়ে ছি ল।

# 15. Firmware: install, upload, ব্য বহা র

# 15.1 Install

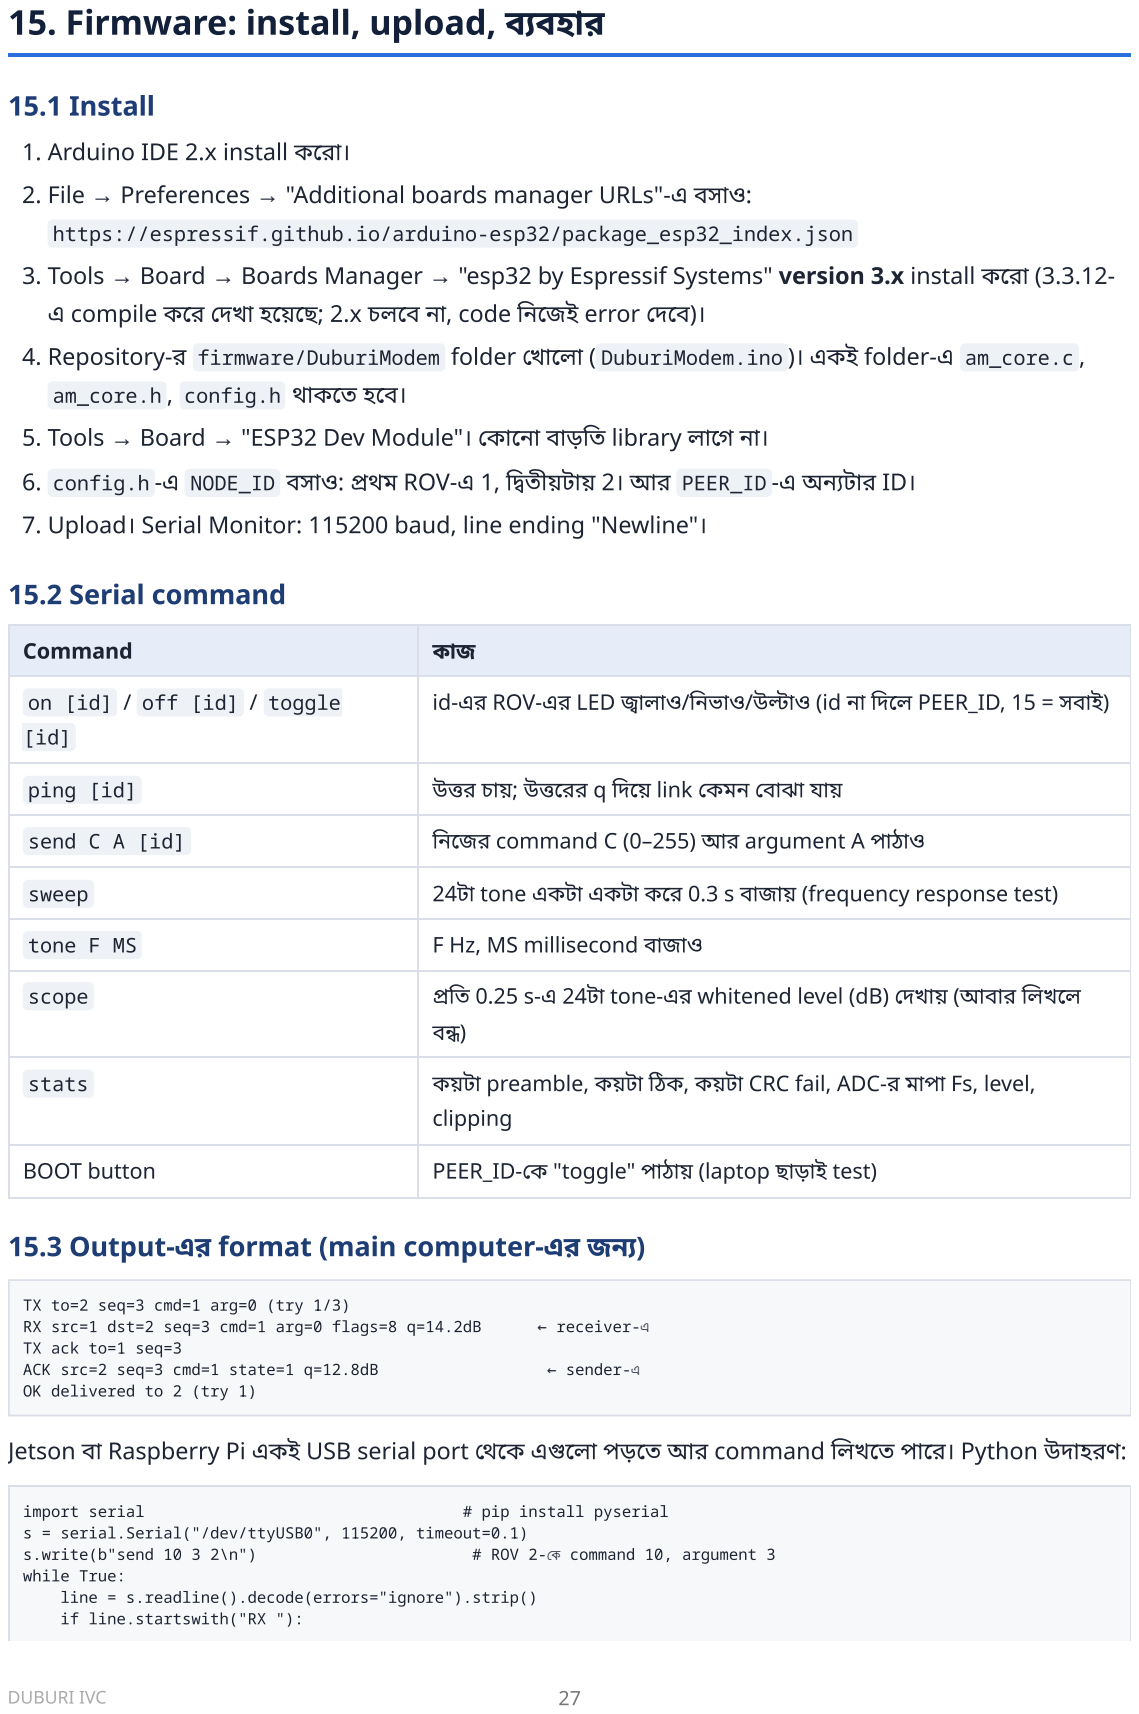
[picture p15: page 27]
1. Arduino IDE 2.x install করো; 3. Tools → Board → Boards Manager → "esp32 by Espressif Systems" version 3.x install করো; এ compile করে; দে খা হয়ে ছে ; 2.x চলবে; না , code নি জে; ই error দে বে )।; 4. Repository-র firmware/DuburiModem folder খো; ( DuburiModem.ino )। একই folder-এ am_core.c ,; am_core.h , config.h থা কতে; 5. Tools → Board → "ESP32 Dev Module"। কো; বা ড়তি library লা গে; 15.2 Serial command; RX src=1 dst=2 seq=3 cmd=1 arg=0 flags=8 q=14.2dB; ← receiver-এ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

2. File → Preferences → "Additional boards manager URLs"-এ বসা ও:

https://espressif.github.io/arduino-esp32/package_esp32_index.json

6. config.h -এ NODE_ID বসা ও: প্রথম ROV-এ 1, দ্বি তী য়টা য় 2। আর PEER_ID -এ অন্য টা র ID।

7. Upload। Serial Monitor: 115200 baud, line ending "Newline"।

Command | কা জ

on [id] / off [id] / toggle [id] | id-এর ROV-এর LED জ্বা লা ও/নি ভা ও/উল্টা ও (id না দি লে PEER_ID, 15 = সবা ই)

ping [id] | উত্তর চা য়; উত্তরে র q দি য়ে link কে মন বো ঝা যা য়

send C A [id] | নি জে র command C (0–255) আর argument A পা ঠা ও

sweep | 24টা tone একটা একটা করে 0.3 s বা জা য় (frequency response test)

tone F MS | F Hz, MS millisecond বা জা ও

scope | প্রতি 0.25 s-এ 24টা tone-এর whitened level (dB) দে খা য় (আবা র লি খলে বন্ধ )

stats | কয়টা preamble, কয়টা ঠি ক, কয়টা CRC fail, ADC-র মা পা Fs, level, clipping

BOOT button | PEER_ID-কে "toggle" পা ঠা য় (laptop ছা ড়া ই test)

15.3 Output-এর format (main computer-এর জন্য )

TX to=2 seq=3 cmd=1 arg=0 (try 1/3)

TX ack to=1 seq=3

OK delivered to 2 (try 1)

s = serial.Serial("/dev/ttyUSB0", 115200, timeout=0.1)

line = s.readline().decode(errors="ignore").strip()

if line.startswith("RX "):

15.4 নি জে | র command যো | গ করা
DuburiModem.ino -তে | enum { CMD_LED_ON = 1, … } -এ নতুন না ম দা ও (10–255), তা রপর handlePacket() -এর

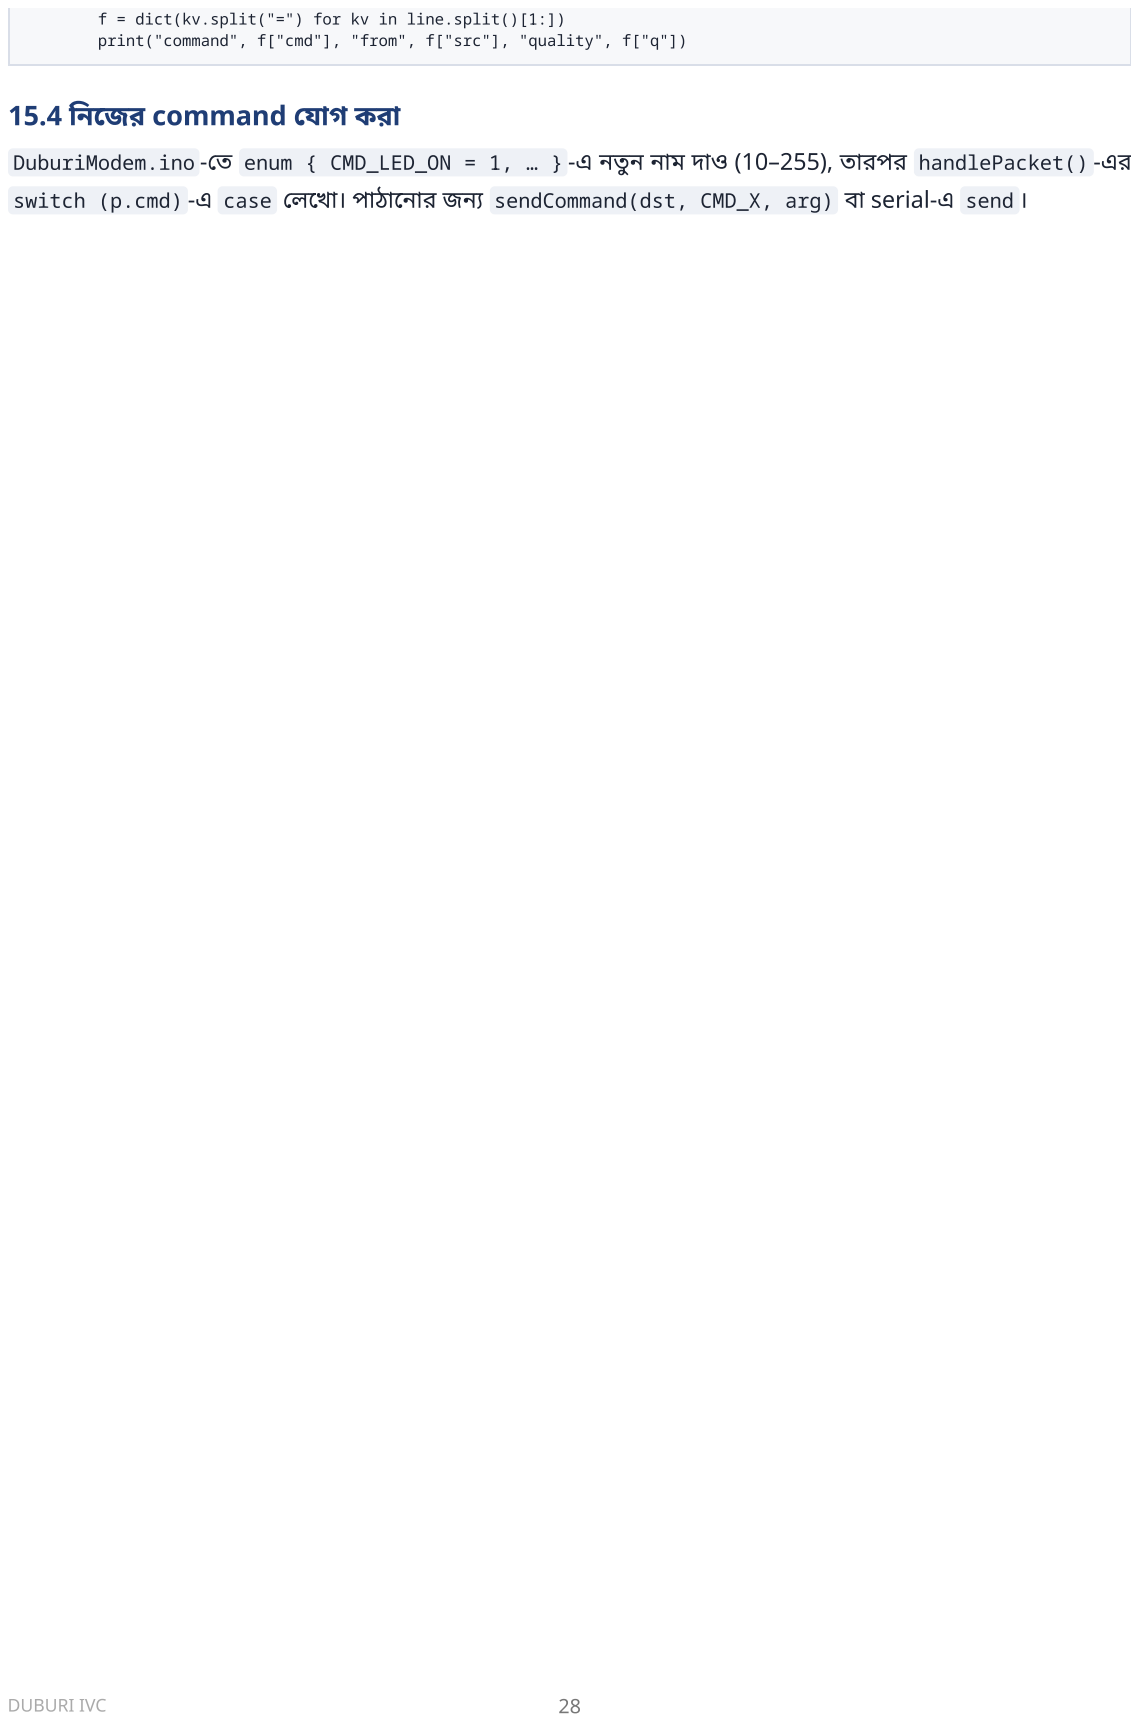
[picture p16: page 28]
switch (p.cmd) -এ case লে খো; র জন্য sendCommand(dst, CMD_X, arg) বা serial-এ send ।

f = dict(kv.split("=") for kv in line.split()[1:])

print("command", f["cmd"], "from", f["src"], "quality", f["q"])

# 16. Code-এর ব্যা খ্যা (function ধরে ধরে )

# 16.1 File-এর ভা গ

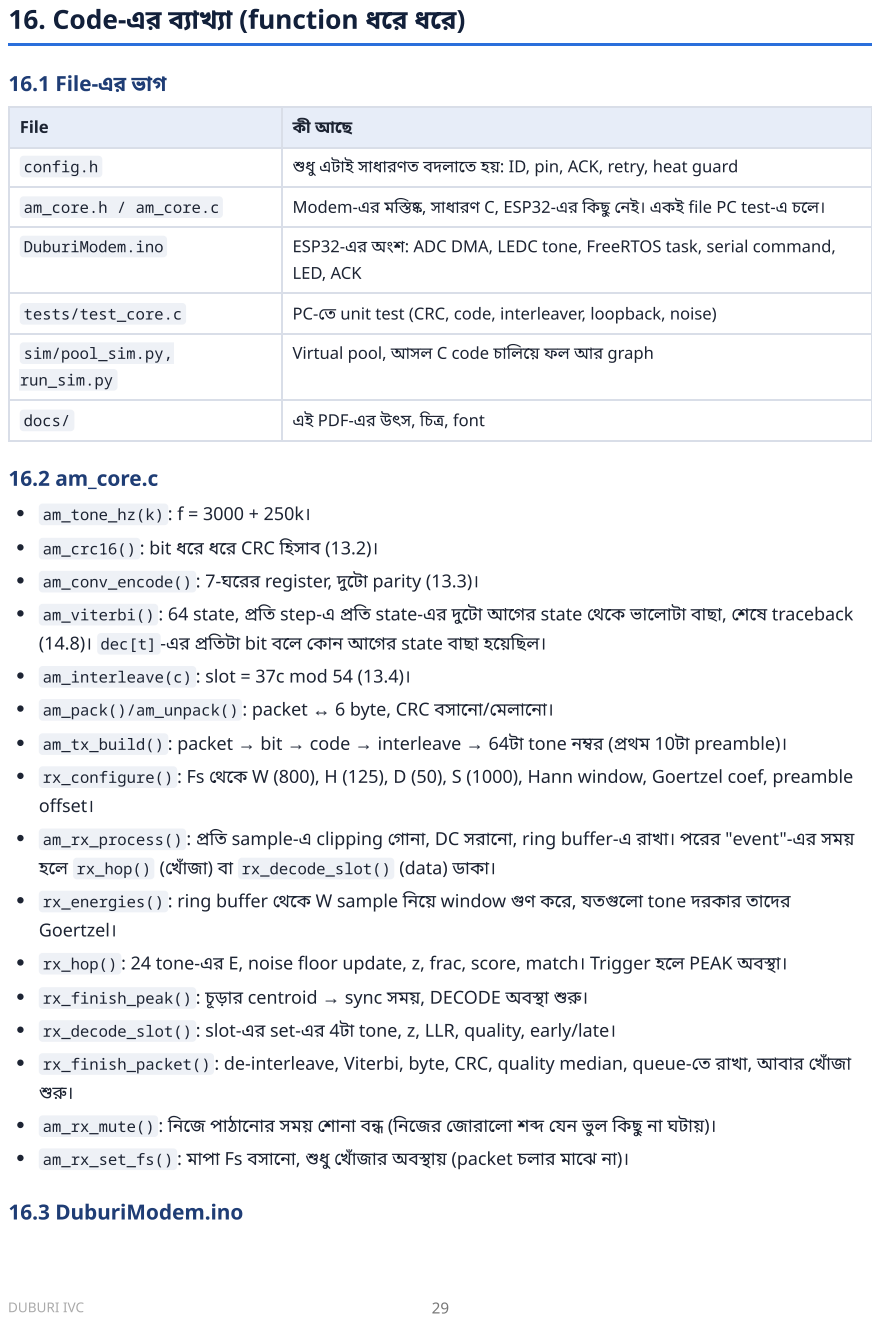
[picture p17: page 29]
16.2 am_core.c; am_tone_hz(k) : f = 3000 + 250k।; am_crc16() : bit ধরে; CRC হি সা ব (13.2)।; am_conv_encode() : 7-ঘরে র register, দুটো; parity (13.3)।; am_viterbi() : 64 state, প্রতি step-এ প্রতি state-এর দুটো; আগে র state থে কে; traceback; (14.8)। dec[t] -এর প্রতি টা bit বলে; ন আগে র state বা ছা হয়ে ছি ল।; am_interleave(c) : slot = 37c mod 54 (13.4)।; am_pack()/am_unpack() : packet ↔ 6 byte, CRC বসা নো; rx_configure() : Fs থে কে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

File | কী আছে

config.h | শুধু এটা ই সা ধা রণত বদলা তে হয়: ID, pin, ACK, retry, heat guard

am_core.h / am_core.c | Modem-এর মস্তি ষ্ক , সা ধা রণ C, ESP32-এর কি ছু নে ই। একই file PC test-এ চলে ।

DuburiModem.ino | ESP32-এর অং শ: ADC DMA, LEDC tone, FreeRTOS task, serial command, LED, ACK

tests/test_core.c | PC-তে unit test (CRC, code, interleaver, loopback, noise)

sim/pool_sim.py, run_sim.py | Virtual pool, আসল C code চা লি য়ে ফল আর graph

docs/ | এই PDF-এর উৎস, চি ত্র, font

am_tx_build() : packet → bit → code → interleave → 64টা tone নম্বর (প্রথম 10টা preamble)।

rx_finish_peak() : চূড়া র centroid → sync সময়, DECODE অবস্থা শুরু ।

rx_decode_slot() : slot-এর set-এর 4টা tone, z, LLR, quality, early/late।

startAdc() : ESP-IDF-এর adc_continuous driver। GPIO34 → ADC1 channel, 12 dB attenuation, 50

kHz, DMA frame 512 sample, overflow হলে | গো | না হয়।
rxTask() (core 0, priority 5): DMA থে কে | sample পড়া , level মা পা , mutex নি য়ে | am_rx_process() , packet
হলে | queue-তে | পা ঠা নো | । প্রতি 2 s-এ Fs মা পা আর দরকা র হলে | বসা নো | ।

playTones() : heat guard, RX mute, amp চা লু, তা রপর প্রতি slot-এ ledcWriteTone() । সময় মা পা হয়

## esp_timer (µs) দি য়ে , প্রতি slot-এর শে ষ "absolute" সময়ে , তা ই drift জমে না ।

## heatGuard()/heatGuardUpdate() : 7.2-এর formula।

sendCommand() : seq বা ড়া নো | , পা ঠা নো | , ACK-এর জন্য 2.6 s অপে ক্ষা , না এলে | আবা র (মো | ট 3 বা র)।
handlePacket() : আমা র জন্য কি না দে খা , ACK চে না , repeat চে না , command চা লা নো | , ACK পা ঠা নো | ।

## loop() : serial line পড়া , BOOT button, scope print, packet poll।

Thread safety: modem-এর state ( g_rx ) দুই task ব্য বহা র করে , তা ই প্রতি বা র mutex ( g_rx_lock ) নে ওয়া

হয়। Packet main loop-এ যা য় FreeRTOS queue দি য়ে । Heavy DSP core 0-তে চলে , serial আর TX core 1-এ।

# 17. Verification: কী test করা হয়ে ছে

# 17.1 Compile

Firmware Arduino-ESP32 core 3.3.12 (ESP-IDF 5.5) দি য়ে | "ESP32 Dev Module"-এর জন্য compile করা হয়ে ছে ,
সব warning চা লু রে খে । কো | নো | warning বা error নে ই। Flash-এর ~23% আর RAM-এর ~17% লা গে ।

# 17.2 Unit test (PC-তে , make -C tests && tests/test_core )

## CRC-16-এর মা ন "123456789" → 0x29B1।

Convolutional code + Viterbi: 3000 বা র এলো | মে লো | data, 0–4টা ছড়া নো | ভুল, সবই ঠি ক হয়ে ছে । এক bit
বদলা লে | ≥10 coded bit বদলা য়।

## Interleaver একটা permutation, পা শা পা শি bit আলা দা slot আর set-এ।

## Pack/unpack 2000 packet, প্রতি টা য় 1 bit উল্টা লে CRC ধরে ।

## Preamble-এর তি নটা নি য়ম (12.5)।

Loopback: পরি ষ্কা | র signal, square wave, 1-sample-করে | input, ADC 1.5% দ্রু ত, Fs মা পা য় 0.05% ভুল, 48

## kHz, প্রা য় 0 dB noise।

## 60 s শুধু noise: একটা ও ভুল packet নে ই।

# 17.3 Virtual pool simulation

ROV-এর আসল C code-কে | একটা কম্পি উটা র-বা না নো | pool-এর signal খা ওয়া নো | হয়ে ছে । Model-এ ছি ল: ESP32

LEDC-এর আসল frequency ধা প, slot-এর সময় ±30 µs কাঁ পা , RC filter, speaker-এর অজা না response (1.5–7 kHz

band, এলো | মে লো | ±5 dB ঢে উ), 50×25×5 m pool-এ image-method echo (দে য়া ল/মে ঝে | reflection 0.85, পা নি র
উপরি তল −0.9), 10–25 m এলো | মে লো | অবস্থা ন, pump hum, thruster noise (ওঠা না মা সহ), click, 30 kHz pinger,
preamp-এর filter, ADC (2.4% দ্রু ত clock, 12 bit, noise)। প্রতি বি ন্দু | তে | 40টা packet।
চি ত্র 17.1: SNR অনুযা য়ী কত packet ঠি ক এসে ছে । SNR = ADC-তে | 3–9 kHz band-এর signal power / noise power।

In-band SNR | Preamble পা ওয়া গে ছে | Packet একদম ঠি ক | Firmware-এর q (median)
-14 dB | 2/40 | 0/40 (0%) | —
-12 dB | 14/40 | 1/40 (2%) | 3.4 dB
-10 dB | 22/40 | 4/40 (10%) | 5.2 dB
-9 dB | 33/40 | 15/40 (38%) | 6.2 dB
-8 dB | 34/40 | 20/40 (50%) | 5.8 dB
-7 dB | 38/40 | 29/40 (72%) | 7.4 dB
-6 dB | 40/40 | 36/40 (90%) | 7.5 dB
-5 dB | 39/40 | 36/40 (90%) | 9.2 dB
-4 dB | 40/40 | 39/40 (98%) | 9.7 dB
-2 dB | 40/40 | 39/40 (98%) | 11.2 dB
+0 dB | 40/40 | 40/40 (100%) | 12.9 dB
+3 dB | 40/40 | 40/40 (100%) | 16.2 dB
Echo-র মা ত্রা (SNR −3 dB) | ঠি ক
দে য়া লে র reflection = 0.5 | 40/40
দে য়া লে র reflection = 0.7 | 40/40
দে য়া লে র reflection = 0.85 | 39/40
দে য়া লে র reflection = 0.93 | 34/40
Interference (SNR −3 dB) | ঠি ক
baseline | 40/40
ESC whine 5500 Hz | 40/40
pinger 35 kHz | 40/40
no thrusters | 39/40
ADC clock 2.4% দ্রু ত, SNR 0 dB | ঠি ক
Fs মা পা র ভুল 0.0% , timing tracker চা লু | 20/20
Fs মা পা র ভুল 0.1% , timing tracker চা লু | 20/20
Fs মা পা র ভুল 0.3% , timing tracker চা লু | 20/20
Fs মা পা র ভুল 1.0% , timing tracker চা লু | 16/20
Fs মা পা র ভুল 0.3% , timing tracker বন্ধ | 20/20
Fs মা পা র ভুল 0.1% , timing tracker বন্ধ | 20/20

False alarm: 600 s শুধু noise (pump + thruster + 5.5 kHz whine + click + 35 kHz pinger): preamble

## trigger 0, ভুল packet 0।

চি ত্র 17.2: Firmware যে | q print করে | বনা ম আসল SNR। মা ঠে | q দে খে | বো | ঝা যা য় link কতটা নি রা পদ।

মা ঠে র নি য়ম: q ≥ 10 dB → নি শ্চি তন্। q 7–10 dB → চলবে , কি ছু retry হবে । q < 7 dB → সী মা না য়, volume/gain/

অবস্থা ন ঠি ক করো | । Fs-এর মা প 1% ভুল হলে | (16/20) ক্ষতি হয়, তা ই firmware-এর ক্র মা গত Fs মা পা জরু রি । চা লুর
পর প্রথম ~10 s মা প স্থি র হতে | দা ও।

# 17.4 Simulation-এ পা ওয়া আর ঠি ক করা সমস্যা

1. Preamble-এর শে ষ tone-এর echo প্রথম data slot নষ্ট করছি ল। নি য়ম 3 (12.5) যো | গ করে | ঠি ক করা হয়ে ছে ।
2. প্রথম interleaver একটা codeword-এর সব bit একই frequency set-এ পা ঠা চ্ছি ল। এক frequency fade করলে
পুরো | codeword নষ্ট হতো | । নতুন interleaver দি য়ে | ঠি ক করা হয়ে ছে ।
3. Hamming(8,4)-এর বদলে | convolutional code: −6 dB-এ সফলতা প্রা য় ২৫% থে কে | ৯০%।
4. Detection threshold 0.17 থে কে | 0.14: −9 dB-এ preamble পা ওয়া 75% থে কে | 100%, false alarm-ও শূন্য ।

# 17.5 কী test করা হয়নি (সৎভা বে )

আসল ESP32, আসল speaker, আসল পা নি । Code compile হয়ে ছে | আর logic simulation-এ test হয়ে ছে , কি তুন্
board-এ চা লা নো | হয়নি । অধ্যা য় 18-এর ধা প ধরে | নি জে | রা test করবে ।
Car speaker-এর box থে কে | পা নি তে | আসলে | কত জো | রে | শব্দ যা য়, আর pool-এর আসল noise কত। Simulation-এ
SNR-কে | চলক রা খা হয়ে ছে । মা ঠে | scope আর q দি য়ে | মা পবে ।
Component-এর মা ন datasheet-এর সা ধা রণ মা ন থে কে | , আর thermal ও plate হি সা ব আনুমা নি ক।
এর বা ইরে , আলা দা AI reviewer agent দি য়ে | code, circuit আর এই document স্বা ধী নভা বে | যা চা ই করা নো | হয়ে ছে ।

## ফলা ফল repository-র docs/VERIFICATION.md -এ আছে ।

# 18. বা না নো ও test করা র ধা প

# ধা প 1: Bench (পা নি ছা ড়া )

1. দুটো | ESP32-এ firmware দা ও (NODE_ID 1 আর 2)। Serial-এ "ready" দে খা বে ।
2. শুধু preamp: piezo লা গি য়ে | stats দে খো | । LEVEL-এর mean ≈ 1500–1800, rms ছো | ট (5–30)। Piezo-তে
আঙুলে র টো | কা দি লে | max লা ফা বে ।
3. Wire loopback: node 1-এর RV1-এর wiper থে কে | signal নি য়ে | 100 kΩ আর 1 kΩ-এর divider দি য়ে | ১০০
ভা গে র ১ ভা গ করো | (wiper → 100 kΩ → বি ন্দু | → 1 kΩ → GND)। সে ই বি ন্দু | থে কে | node 2-এর preamp input-এ
(piezo-র জা য়গা য়) দা ও। RV2 কম রা খো | । দুই board-এর GND জো | ড়া দা ও, আর speaker খুলে | রা খো | । Node 1-এ
on লি খলে | node 2-এর LED জ্বলবে । (ACK-এর জন্য উল্টো | দি কে | ও একই তা র লা গবে । না দি লে | "no reply" দে খা বে ,
কি তুন্ LED জ্বলবে ।) এতে | পুরো | DSP chain পা নি ছা ড়া ই পরী ক্ষা হয়।
4. Amp + speaker বা তা সে , RV1 একদম কম। tone 5000 500 দি য়ে | শব্দ শো | নো | । আস্তে | বা ড়া ও, কর্কশ হওয়া র আগে
থা মো | ।

## ধা প 2: বা লতি

## 1. Speaker box আর hydrophone বা লতি তে , 30–50 cm দূরে । Volume কম।

2. RX-এ scope চা লু, TX-এ sweep । কো | ন tone-এ level কম আসে | দে খো | ।
3. stats -এ clipped বা ড়লে | RV2 (gain) কমা ও। rms খুব কম হলে | বা ড়া ও।
4. ping ১০ বা র। সবগুলো | OK আর q বড় (>20 dB) হওয়া উচি ত।

# ধা প 3: Pool

1. 5, 10, 15, 20, 25 m-এ প্রতি বা র ২০টা ping । কয়টা OK আর q-এর মা ন লি খে | রা খো | ।
2. Thruster বন্ধ | আর চা লু, দুইভা বে ই। চা লু অবস্থা য় RX-এর scope -এ কো | নো | tone-এ স্থা য়ী উঁচু level থা কলে | বুঝবে
সে খা নে | whine আছে | (whitening সা মলা বে , কি তুন্ জে | নে | রা খা ভা লো | )।
3. প্রতি ১০ মি নি ট পর speaker-এর resistance মে পে | তা পমা ত্রা দে খো | (7.6)।
4. q < 7 dB হলে : (ক) volume একটু বা ড়া ও (clip না করে ); (খ) hydrophone-কে | thruster থে কে | দূরে | না ও; (গ)
speaker জা না লা পা তলা বা বড় করো | ; (ঘ) দরকা র হলে | PAM8610।

# ধা প 4: ROV-এ লা গা নো

Hydrophone নি চে র দি কে | , frame থে কে | কম্পন-বি চ্ছি ন্ন। Speaker-এর জা না লা খো | লা পা নি র দি কে | ।
Main computer-এর সা থে | serial (15.3), অথবা শুধু BOOT button/LED দি য়ে ।

# 19. Troubleshooting

লক্ষণ | সভাম্ভাব্য কা রণ | কী করবে
Serial-এ "ADC start failed" | ভুল pin বা core 2.x | PIN_HYDROPHONE 32–39-এর একটা হতে হবে , core 3.x
preambles = 0, কি ছুই আসে না | signal খুব কম, বা gain কম, বা ADC saturate | scope দে খো ; stats-এ LEVEL; RV1/RV2 ঠি ক করো ; wire loopback দি য়ে DSP check
preambles বা ড়ে কি তুন্ crc_fail-ও বা ড়ে | SNR সী মা না য়, echo বে শি , বা clipping | q দে খো ; clipped শূন্য রা খো ; দূরত্ব কমি য়ে দে খো ; hydrophone-এর অবস্থা ন বদলা ও
clipped দ্রু ত বা ড়ে | gain বে শি বা thruster noise খুব জো রা লো | RV2 কমা ও; hydrophone thruster থে কে দূরে
overflows বা ড়ে | CPU সময় পা চ্ছে না | loop()-এ লম্বা কা জ যো গ করো নি তো ? WiFi/BT চা লু করো নি তো ?
fs_measured 49000– 51500-এর বা ইরে | ADC বা driver সমস্যা | board বদলে দে খো ; issue খো লো
TX-এর সময় ESP32 reset | brownout: amp-এর current-এ voltage না মছে | আলা দা buck, 1000 µF, মো টা তা র
Speaker গরম | অধ্যা য় 7 | checklist 7; MAX_TX_DUTY কমা ও
Amp গরম/বন্ধ হয়ে যা য় | speaker-এর তা র GND-এ, বা 2 Ω-এর কম load | BTL নি য়ম (6.2); একটা ই 4 Ω speaker
"HEAT-GUARD wait" | খুব ঘনঘন পা ঠা চ্ছ | স্বা ভা বি ক, speaker রক্ষা করছে
LED জ্বলে কি তুন্ "no reply" | অন্য দি কে র TX বা RX কা জ করছে না | উল্টো দি কে ping; দুই ROV-এ ID আলা দা কি না দে খো
একই command দুইবা র কা জ করে | seq বদলে নতুন command পা ঠা নো হয়ে ছে | স্বা ভা বি ক; repeat-এ seq একই থা কে , তখন দ্বি তী য়বা র চলে না
Hum বা ভনভন শব্দ (scope-এ সব tone উঁচু) | ground loop, unshielded cable | star ground, shield শুধু এক প্রা ন্তে , preamp-এর supply filter

# 20. Safety

LiPo battery: fuse ব্য বহা র করবে , short হলে | আগুন লা গতে | পা রে । পা নি তে | না মা নো | র আগে | সব সং যো | গ seal করবে ।

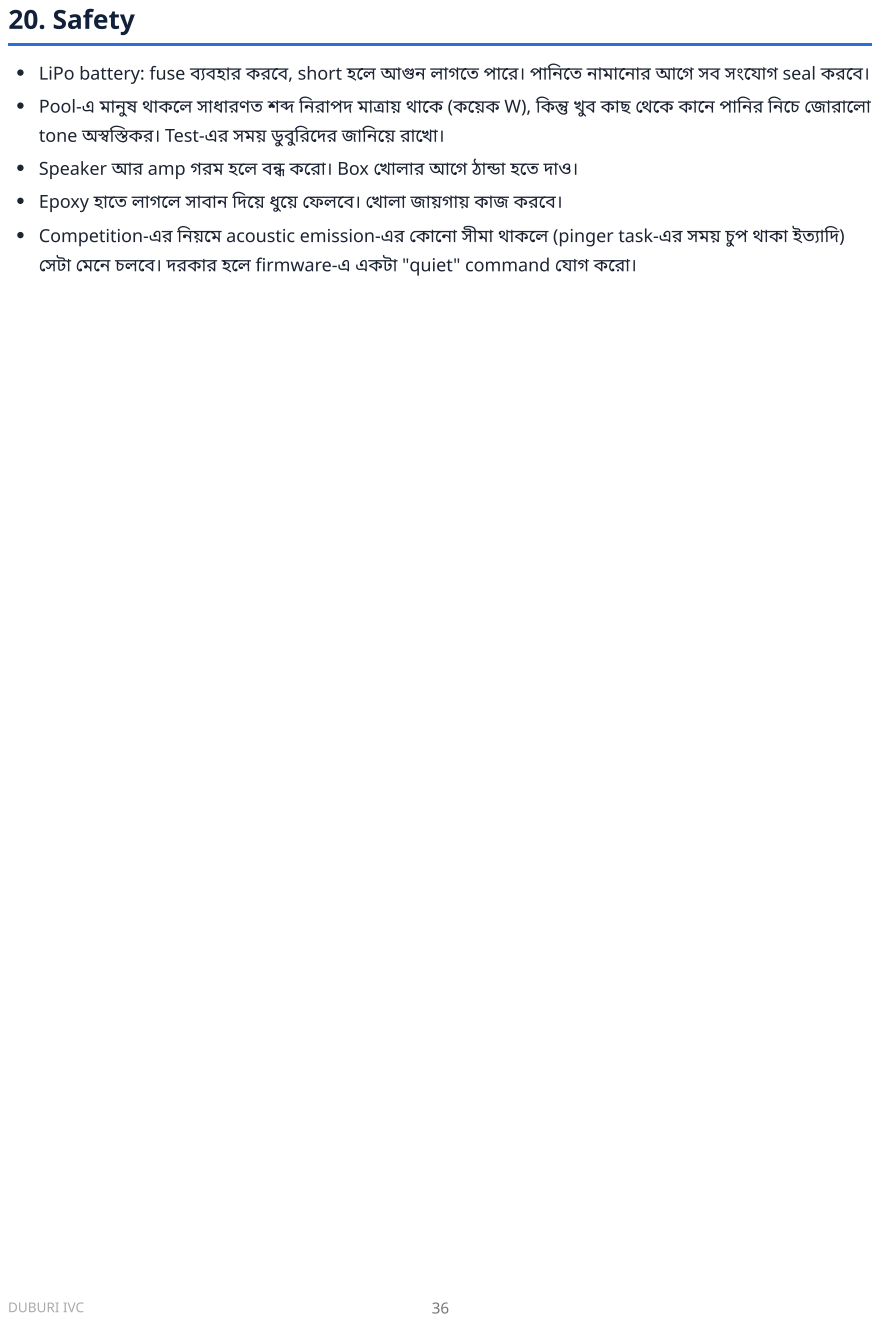
[picture p18: page 36]
Pool-এ মা নুষ থা কলে; সা ধা রণত শব্দ নি রা পদ মা ত্রা য় থা কে; tone অস্বস্তি কর। Test-এর সময় ডুবুরি দে র জা নি য়ে; Speaker আর amp গরম হলে; । Box খো; Epoxy হা তে; লা জা য়গা য় কা জ করবে ।; Competition-এর নি য়মে; acoustic emission-এর কো; (pinger task-এর সময় চুপ থা কা ইত্যা দি ); চলবে । দরকা র হলে; firmware-এ একটা "quiet" command যো

# A. সব formula এক জা য়গা য়

Formula | কো থা য় লা গে | অধ্যা য়
λ = c / f | wavelength, coating কতটা পা তলা | 2.1, 9.1

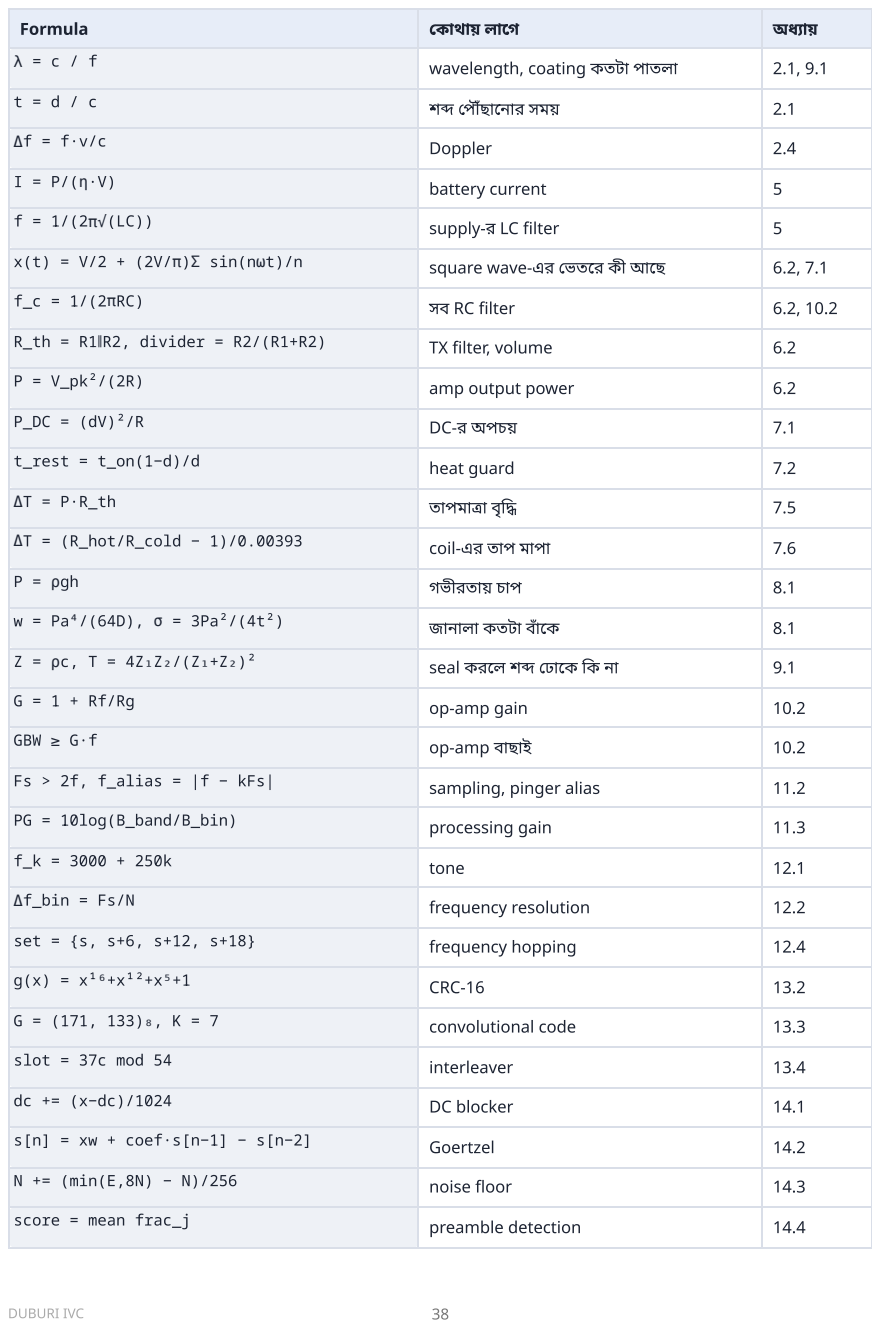
[picture p19: page 38]

t = d / c | শব্দ পৌঁ ছা নো র সময় | 2.1

Δf = f·v/c | Doppler | 2.4

I = P/(η·V) | battery current | 5

f = 1/(2π√(LC)) | supply-র LC filter | 5

x(t) = V/2 + (2V/π)Σ sin(nωt)/n | square wave-এর ভে তরে কী আছে | 6.2, 7.1

f_c = 1/(2πRC) | সব RC filter | 6.2, 10.2

R_th = R1∥R2, divider = R2/(R1+R2) | TX filter, volume | 6.2

P = V_pk²/(2R) | amp output power | 6.2

P_DC = (dV)²/R | DC-র অপচয় | 7.1

t_rest = t_on(1−d)/d | heat guard | 7.2

ΔT = (R_hot/R_cold − 1)/0.00393 | coil-এর তা প মা পা | 7.6

P = ρgh | গভী রতা য় চা প | 8.1

w = Pa⁴/(64D), σ = 3Pa²/(4t²) | জা না লা কতটা বাঁ কে | 8.1

Z = ρc, T = 4Z₁Z₂/(Z₁+Z₂)² | seal করলে শব্দ ঢো কে কি না | 9.1

G = 1 + Rf/Rg | op-amp gain | 10.2

GBW ≥ G·f | op-amp বা ছা ই | 10.2

Fs > 2f, f_alias = |f − kFs| | sampling, pinger alias | 11.2

PG = 10log(B_band/B_bin) | processing gain | 11.3

f_k = 3000 + 250k | tone | 12.1

Δf_bin = Fs/N | frequency resolution | 12.2

set = {s, s+6, s+12, s+18} | frequency hopping | 12.4

g(x) = x¹⁶+x¹²+x⁵+1 | CRC-16 | 13.2

G = (171, 133)₈, K = 7 | convolutional code | 13.3

slot = 37c mod 54 | interleaver | 13.4

dc += (x−dc)/1024 | DC blocker | 14.1

s[n] = xw + coef·s[n−1] − s[n−2] | Goertzel | 14.2

N += (min(E,8N) − N)/256 | noise floor | 14.3

score = mean frac_j | preamble detection | 14.4

err = (E_L−E_E)/(E_L+E_E) | timing tracking | 14.5
Fs = ΔN/Δt | ADC-র আসল rate | 14.6

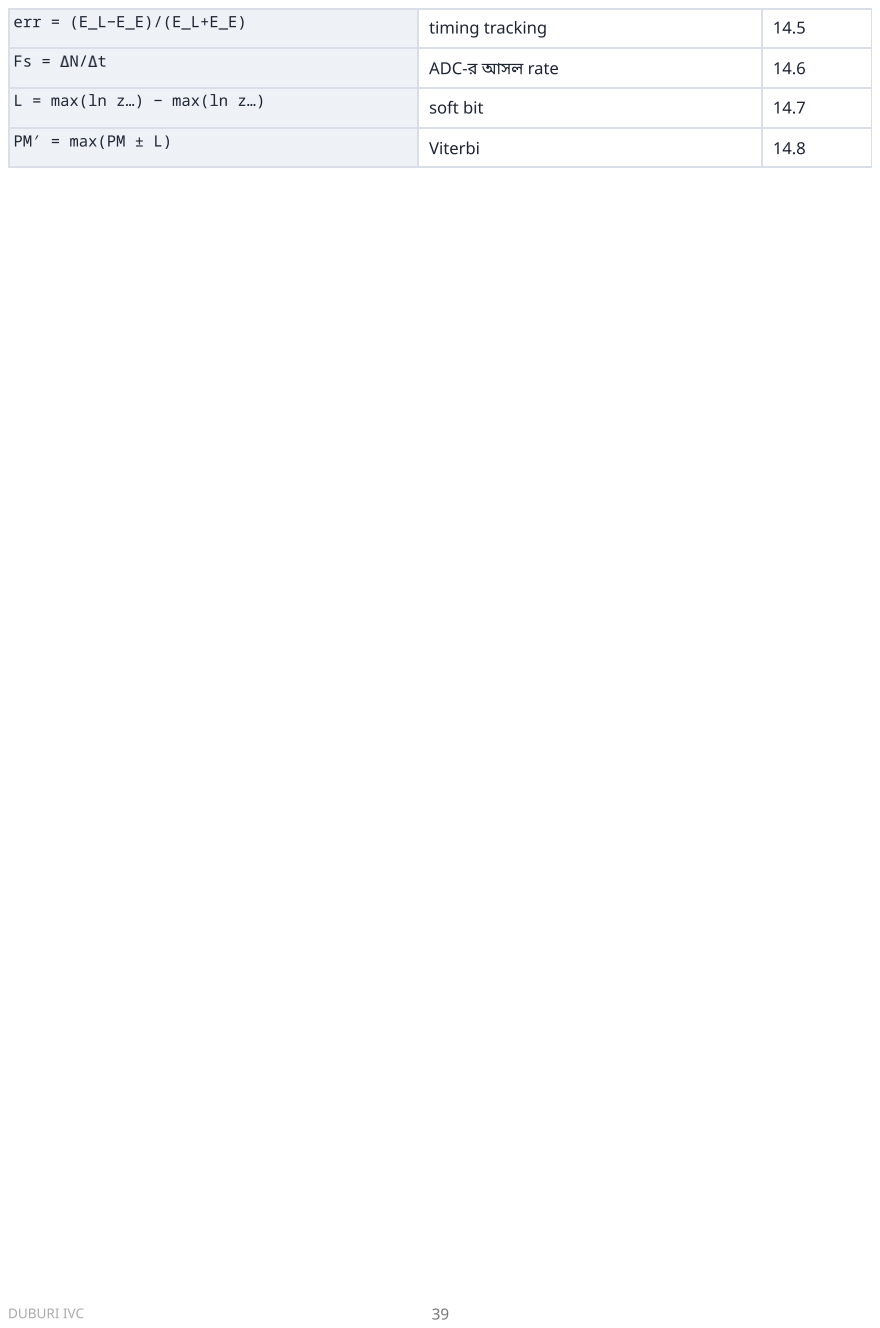
[picture p20: page 39]

L = max(ln z…) − max(ln z…) | soft bit | 14.7

PM′ = max(PM ± L) | Viterbi | 14.8

B. শব্দকো | ষ (Glossary)
শব্দ | মা নে
ADC | Analog-to-Digital Converter: voltage-কে সং খ্যা য় রূ পা তন্র করে
DMA | Direct Memory Access: CPU ছা ড়া ই hardware নি জে data memory-তে রা খে
FSK | Frequency Shift Keying: তথ্য বো ঝা নো হয় কো ন frequency বা জছে তা দি য়ে
Frequency hopping | সময়ে র সা থে frequency-র set বদলা নো
Slot / symbol | 20 ms-এর একটা ভা গ, যা তে একটা tone বা জে
Preamble | Packet-এর শুরু র পরি চি ত নকশা , যা দি য়ে packet খুঁজে পা ওয়া যা য়
Goertzel | একটা নি র্দি ষ্ট frequency-র শক্তি মা পা র দ্রু ত algorithm
Window (Hann) | Signal-এর দুই কি না রা নরম করা র গুণক
SNR | Signal-to-Noise Ratio, dB-তে : 10·log₁₀(P_signal/P_noise)
dB | অনুপা তে র log মা প। +3 dB ≈ ২ গুণ power, +10 dB = ১০ গুণ, +20 dB = ১০০ গুণ
Reverberation / echo | দে য়া ল ও পা নি র উপরি তলে প্রতি ফলি ত শব্দ
Fading | Echo-গুলো একে অপরকে কে টে দি য়ে কো নো frequency দুর্বল হয়ে যা ওয়া
CRC | ভুল ধরা র check-সং খ্যা
Convolutional code / Viterbi | ভুল ঠি ক করা র code আর তা র decoder
Interleaver | Bit-এর ক্র ম এলো মে লো করে ছড়ি য়ে দে ওয়া
LLR / soft bit | Bit 0 না 1, আর কতটা নি শ্চি ত
BTL | Bridge-Tied Load: speaker-এর দুই প্রা ন্তে ই amp-এর output
Class-D | দ্রু ত on/off switching amplifier, efficiency ~৯০%
Acoustic impedance | Z = ρc, শব্দে র জন্য পদা র্থে র "বা ধা "
Aliasing | Fs/2-এর উপরে র frequency-র ভুল করে নি চে দে খা দে ওয়া
Buck converter | উচ্চ voltage থে কে দক্ষভা বে নি ম্ন voltage বা না নো র circuit
ACK | "পে য়ে ছি " উত্তর

C. পুরো | source code
নি চে র code repository-র file থে কে | PDF বা না নো | র সময় সরা সরি বসা নো | হয়ে ছে , তা ই হুবহু একই। নতুন version-এর জন্য

## সবসময় GitHub-এর code দে খবে ।

# firmware/DuburiModem/config.h

1 | /*
2 | * config.h - the ONLY file you normally need to edit.
3 | *
4 | * Flash the same firmware on both vehicles. Give each one a different NODE_ID.
5 | */
6 | #ifndef DUBURI_CONFIG_H
7 | #define DUBURI_CONFIG_H

8

9 | /* ---- Who am I ---------------------------------------------------------- */
10 | #define NODE_ID | 1 | /* 1..14, different on every vehicle | */
11 | #define PEER_ID | 2 | /* default destination for commands | */

12

13 | /* ---- Pins (ESP32 DevKit V1 / WROOM-32) --------------------------------- */
14 | #define PIN_TX_AUDIO | 25 | /* square-wave tone out -> RC filter -> amp IN | */
15 | #define PIN_HYDROPHONE | 34 | /* preamp output -> ADC1 channel 6 (input only) */
16 | #define PIN_LED | 2 | /* on-board blue LED on most DevKit boards | */
17 | #define PIN_BUTTON | 0 | /* BOOT button: press = send "toggle" to PEER | */
18 | #define PIN_AMP_ENABLE | -1 | /* amp SD/MUTE pin if your module has one, else -1 */
19 | #define AMP_ENABLE_LEVEL HIGH /* level that turns the amp ON | */

20

21 | /* ---- Behaviour --------------------------------------------------------- */
22 | #define USE_ACK | 1 | /* 1 = ask for a reply and retry if none comes | */
23 | #define TX_RETRIES | 3 | /* attempts per command | */
24 | #define ACK_TIMEOUT_MS | 2600 /* wait this long for a reply | */
25 | #define REPEAT_GAP_MS | 400 | /* gap between repeats when USE_ACK = 0 | */
26 | #define TURNAROUND_MS | 300 | /* receiver waits this long before replying | */
27 | #define MUTE_TAIL_MS | 120 | /* keep RX deaf this long after our own TX | */
28 | #define DEDUP_MS | 15000/* same (src,seq) inside this time = repeat | */

29

30 | /* ---- Heat protection ----------------------------------------------------
31 | * Limits how much of the time the speaker may be playing. 0.5 means every
32 | * transmission must be followed by at least the same amount of silence
33 | * (a 1.16 s packet -> >= 1.16 s rest). Lower it if the speaker gets warm. */
34 | #define MAX_TX_DUTY | 0.5f

35

36 | #define SERIAL_BAUD | 115200

37

38 #endif

# firmware/DuburiModem/DuburiModem.ino

1 | /*
2 | * DuburiModem.ino - underwater acoustic link between two ROVs (ESP32).
3 | *
4 | * Board : "ESP32 Dev Module" (Arduino-ESP32 core 3.x, tested with 3.3.12)
5 | * Needs : no extra libraries.
6 | *
7 | * Same firmware on every vehicle; set NODE_ID in config.h.
8 | *
9 | * Serial Monitor (115200 baud, "Newline") commands:
10 | * | on [id] | turn LED on at vehicle id (default PEER_ID, 15 = all)
11 | * | off [id] | turn LED off
12 | * | toggle [id] | toggle LED
13 | * | ping [id] | ask for a reply, prints link quality
14 | * | send C A [id] | send command number C (0..255) with argument A (0..255)
15 | * | sweep | play every tone once (frequency response test)
16 | * | tone F MS | play F Hz for MS milliseconds
17 | * | scope | start/stop printing per-tone levels every 0.25 s
18 | * | stats | print counters, ADC level and measured sample rate
19 | * | help
20 | * Received packets are printed as: | RX src=2 dst=1 seq=3 cmd=1 arg=0 q=18.5dB
21 | * so a Jetson / Raspberry Pi can read the same serial port.
22 | */
23 | #include <Arduino.h>
24 | #include "config.h"
25 | #include "am_core.h"
26 | #include "esp_adc/adc_continuous.h"
27 | #include "esp_timer.h"
28 | #include "freertos/FreeRTOS.h"
29 | #include "freertos/task.h"
30 | #include "freertos/semphr.h"
31 | #include "freertos/queue.h"

32

33 | #if !defined(ESP_ARDUINO_VERSION_MAJOR) || ESP_ARDUINO_VERSION_MAJOR < 3
34 | #error "Install Arduino-ESP32 core 3.x (Tools > Board > Boards Manager > esp32 by Espressif)"
35 | #endif

36

37 | /* Command numbers (you can add your own: 10..255 are free) */
38 | enum {
39 | CMD_LED_ON = 1,
40 | CMD_LED_OFF = 2,
41 | CMD_LED_TOGGLE = 3,
42 | CMD_PING = 4,
43 | };

44

45 | /* ------------------------------------------------------------------------ */
46 | /* Receiver task (core 0): ADC DMA -> modem core -> queue | */
47 | /* ------------------------------------------------------------------------ */
48 | static am_rx_t g_rx; | /* ~40 kB, keep it off the stack */
49 | static SemaphoreHandle_t g_rx_lock;
50 | static QueueHandle_t g_pkt_queue;
51 | static adc_continuous_handle_t g_adc;
52 | static adc_channel_t g_adc_chan;
53 | static volatile uint32_t g_adc_overflows = 0;

54

55 | /* measured ADC sample rate */
56 | static volatile float g_fs_measured = AM_FS_NOMINAL;
57 | /* ADC level (raw counts) over the last ~0.5 s */
58 | static volatile float g_lvl_rms = 0, g_lvl_mean = 0;
59 | static volatile uint16_t g_lvl_min = 0, g_lvl_max = 0;

60

61 | static bool IRAM_ATTR onAdcOverflow(adc_continuous_handle_t, const adc_continuous_evt_data_t *, void *) {
62 | g_adc_overflows = g_adc_overflows + 1;
63 | return false;
64 | }

65

66 | static bool startAdc() {
67 | adc_unit_t unit;
68 | if (adc_continuous_io_to_channel(PIN_HYDROPHONE, &unit, &g_adc_chan) != ESP_OK || unit != ADC_UNIT_1) {
69 | Serial.println("ERROR: PIN_HYDROPHONE must be an ADC1 pin (32..39)");
70 | | return false;
71 | }
72 | adc_continuous_handle_cfg_t hcfg = {};

73 | hcfg.max_store_buf_size = 16384; | /* 8192 samples = 164 ms of slack */
74 | hcfg.conv_frame_size = 1024; | /* 512 samples per read (~10 ms) */
75 | if (adc_continuous_new_handle(&hcfg, &g_adc) != ESP_OK) return false;

76

77 | adc_digi_pattern_config_t pat = {};
78 | pat.atten = ADC_ATTEN_DB_12; | /* ~0.15 .. 2.45 V usable */
79 | pat.channel = (uint8_t)g_adc_chan;
80 | pat.unit = ADC_UNIT_1;
81 | pat.bit_width = SOC_ADC_DIGI_MAX_BITWIDTH;

82

83 | adc_continuous_config_t cfg = {};
84 | cfg.pattern_num = 1;
85 | cfg.adc_pattern = &pat;
86 | cfg.sample_freq_hz = (uint32_t)AM_FS_NOMINAL;
87 | cfg.conv_mode = ADC_CONV_SINGLE_UNIT_1;
88 | cfg.format = ADC_DIGI_OUTPUT_FORMAT_TYPE1;
89 | if (adc_continuous_config(g_adc, &cfg) != ESP_OK) return false;

90

91 | adc_continuous_evt_cbs_t cbs = {};
92 | cbs.on_pool_ovf = onAdcOverflow;
93 | adc_continuous_register_event_callbacks(g_adc, &cbs, NULL);
94 | return adc_continuous_start(g_adc) == ESP_OK;
95 | }

96

97 | static void rxTask(void *) {
98 | static uint8_t raw[1024];
99 | static uint16_t smp[512];
100 | uint64_t total = 0;
101 | int64_t t_ref = 0;
102 | uint64_t n_ref = 0;
103 | int64_t t_last_fs = 0;
104 | /* level meter accumulators */
105 | double acc = 0, acc2 = 0;
106 | uint32_t accn = 0;
107 | uint16_t mn = 4095, mx = 0;

108

109 | for (;;) {
110 | uint32_t got = 0;
111 | esp_err_t r = adc_continuous_read(g_adc, raw, sizeof(raw), &got, 200);
112 | if (r != ESP_OK) continue;
113 | int64_t now = esp_timer_get_time();
114 | int n = 0;
115 | for (uint32_t i = 0; i + 1 < got; i += SOC_ADC_DIGI_RESULT_BYTES) {
116 | adc_digi_output_data_t *d = (adc_digi_output_data_t *)&raw[i];
117 | if (d->type1.channel != g_adc_chan) continue;
118 | uint16_t v = d->type1.data;
119 | smp[n++] = v;
120 | acc += v;
121 | acc2 += (double)v * v;
122 | if (v < mn) mn = v;
123 | if (v > mx) mx = v;
124 | }
125 | accn += n;
126 | total += n;

127

128 | xSemaphoreTake(g_rx_lock, portMAX_DELAY);
129 | am_rx_process(&g_rx, smp, n);
130 | am_rx_result_t res;
131 | while (am_rx_pop(&g_rx, &res)) xQueueSend(g_pkt_queue, &res, 0);
132 | xSemaphoreGive(g_rx_lock);

133

134 | /* Measure the real ADC rate against the CPU clock. The longer we run
135 | * the more exact it gets (DMA timing jitter / elapsed time). */
136 | if (t_ref == 0 && total > 25000) { t_ref = now; n_ref = total; t_last_fs = now; }
137 | if (t_ref != 0 && now - t_last_fs > 2000000) {
138 | t_last_fs = now;
139 | double fs = (double)(total - n_ref) * 1e6 / (double)(now - t_ref);
140 | if (fs > 20000.0 && fs < 62000.0) {
141 | g_fs_measured = (float)fs;
142 | xSemaphoreTake(g_rx_lock, portMAX_DELAY);
143 | if (fabsf(g_rx.fs - (float)fs) > 0.0002f * (float)fs) am_rx_set_fs(&g_rx, (float)fs);
144 | xSemaphoreGive(g_rx_lock);
145 | }
146 | }
147 | if (accn >= 25000) {
148 | double m = acc / accn;

149 | g_lvl_mean = (float)m;
150 | g_lvl_rms = (float)sqrt(fmax(acc2 / accn - m * m, 0.0));
151 | g_lvl_min = mn;
152 | g_lvl_max = mx;
153 | acc = acc2 = 0;
154 | accn = 0;
155 | mn = 4095;
156 | mx = 0;
157 | }
158 | }
159 | }

160

161 | /* ------------------------------------------------------------------------ */
162 | /* Transmitter | */
163 | /* ------------------------------------------------------------------------ */
164 | static int64_t g_tx_allowed_at = 0; | /* heat guard */
165 | static uint8_t g_seq = 0;
166 | static bool g_scope = false;
167 | static bool g_led = false;

168

169 | static void ampEnable(bool on) {
170 | #if PIN_AMP_ENABLE >= 0
171 | digitalWrite(PIN_AMP_ENABLE, on ? AMP_ENABLE_LEVEL : !AMP_ENABLE_LEVEL);
172 | if (on) delay(20);
173 | #else
174 | (void)on;
175 | #endif
176 | }

177

178 | static void muteRx(uint32_t ms) {
179 | xSemaphoreTake(g_rx_lock, portMAX_DELAY);
180 | am_rx_mute(&g_rx, (uint32_t)((float)ms * g_fs_measured / 1000.0f));
181 | xSemaphoreGive(g_rx_lock);
182 | }

183

184 | static void waitUntil(int64_t t_us) {
185 | for (;;) {
186 | int64_t left = t_us - esp_timer_get_time();
187 | if (left <= 0) return;
188 | if (left > 3000) vTaskDelay(1); | /* sleep in 1 ms steps, spin the rest */
189 | }
190 | }

191

192 | /* Heat guard: after a transmission of T seconds the speaker must rest
193 | * T * (1 - duty) / duty seconds before the next one. */
194 | static void heatGuard() {
195 | int64_t wait = g_tx_allowed_at - esp_timer_get_time();
196 | if (wait > 0) {
197 | Serial.printf("HEAT-GUARD wait %d ms\n", (int)(wait / 1000));
198 | waitUntil(g_tx_allowed_at);
199 | }
200 | }

201

202 | static void heatGuardUpdate(int64_t t_start, int64_t t_end) {
203 | float on = (float)(t_end - t_start);
204 | g_tx_allowed_at = t_end + (int64_t)(on * (1.0f - MAX_TX_DUTY) / MAX_TX_DUTY);
205 | }

206

207 | static void playTones(const uint8_t *tones, int count) {
208 | const int64_t slot_us = (int64_t)(AM_T_SLOT * 1e6f);
209 | heatGuard();
210 | uint32_t mute_ms = (uint32_t)(count * AM_T_SLOT * 1000.0f) + 40 + MUTE_TAIL_MS;
211 | muteRx(mute_ms);
212 | ampEnable(true);
213 | int64_t t0 = esp_timer_get_time() + 2000;
214 | waitUntil(t0);
215 | for (int i = 0; i < count; i++) {
216 | ledcWriteTone(PIN_TX_AUDIO, (uint32_t)lrintf(am_tone_hz(tones[i])));
217 | waitUntil(t0 + (int64_t)(i + 1) * slot_us);
218 | }
219 | ledcWrite(PIN_TX_AUDIO, 0);
220 | ampEnable(false);
221 | heatGuardUpdate(t0, esp_timer_get_time());
222 | }

223

224 static void sendPacket(const am_packet_t &p) {

uint8_t tones[AM_TOTAL_SLOTS];

am_tx_build(&p, tones);

playTones(tones, AM_TOTAL_SLOTS);

}

/* ------------------------------------------------------------------------ */

231 | /* Packet handling | */

/* ------------------------------------------------------------------------ */

| static int16_t g_last_seq[16];
| static uint32_t g_last_seq_ms[16];

static void setLed(bool on) {

g_led = on;

digitalWrite(PIN_LED, on ? HIGH : LOW);

}

static void sendAck(const am_packet_t &in) {

am_packet_t a = {};

a.dst = in.src;

a.src = NODE_ID;

a.seq = in.seq;

a.flags = AM_FLAG_IS_ACK;

a.cmd = in.cmd;

a.arg = g_led ? 1 : 0;

delay(TURNAROUND_MS);

sendPacket(a);

Serial.printf("TX ack to=%d seq=%d\n", a.dst, a.seq);

}

/* Returns true if this was the ACK we are waiting for. */

static bool handlePacket(const am_rx_result_t &r, int wait_src, int wait_seq) {

const am_packet_t &p = r.pkt;

if (p.dst != NODE_ID && p.dst != AM_ADDR_BROADCAST) {

Serial.printf("RX (not for me) src=%d dst=%d q=%.1fdB\n", p.src, p.dst, r.q_db);

return false;

}

if (p.flags & AM_FLAG_IS_ACK) {

Serial.printf("ACK src=%d seq=%d cmd=%d state=%d q=%.1fdB\n", p.src, p.seq, p.cmd, p.arg, r.q_db);

return (p.src == wait_src && p.seq == wait_seq);

}

Serial.printf("RX src=%d dst=%d seq=%d cmd=%d arg=%d flags=%X q=%.1fdB\n",

p.src, p.dst, p.seq, p.cmd, p.arg, p.flags, r.q_db);

uint32_t now = millis();

bool repeat = (g_last_seq[p.src] == p.seq) && (now - g_last_seq_ms[p.src] < DEDUP_MS);

g_last_seq[p.src] = p.seq;

g_last_seq_ms[p.src] = now;

if (!repeat) {

switch (p.cmd) {

case CMD_LED_ON: setLed(true); break;

case CMD_LED_OFF: setLed(false); break;

case CMD_LED_TOGGLE: setLed(!g_led); break;

case CMD_PING: break;

default: break; /* add your own commands here */

}

} else {

281 | Serial.println(" | (repeat - action already done)");

}

/* Reply even to repeats: our earlier reply may have been lost. */

if (USE_ACK && (p.flags & AM_FLAG_ACK_REQ) && p.dst == NODE_ID) sendAck(p);

| return false;

}

static void pollPackets() {

am_rx_result_t r;

while (xQueueReceive(g_pkt_queue, &r, 0) == pdTRUE) handlePacket(r, -1, -1);

}

static void sendCommand(int dst, uint8_t cmd, uint8_t arg) {

am_packet_t p = {};

p.dst = (uint8_t)dst;

p.src = NODE_ID;

p.seq = g_seq = (uint8_t)((g_seq + 1) & 0xF);

p.cmd = cmd;

p.arg = arg;

bool want_ack = USE_ACK && dst != AM_ADDR_BROADCAST;

301 | if (want_ack) p.flags = AM_FLAG_ACK_REQ;

302

303 | for (int attempt = 1; attempt <= TX_RETRIES; attempt++) {
304 | Serial.printf("TX to=%d seq=%d cmd=%d arg=%d (try %d/%d)\n", dst, p.seq, cmd, arg, attempt, TX_RETRIES);
305 | sendPacket(p);
306 | if (!want_ack) {
307 | if (attempt < TX_RETRIES) delay(REPEAT_GAP_MS);
308 | continue;
309 | }
310 | uint32_t t0 = millis();
311 | while (millis() - t0 < ACK_TIMEOUT_MS) {
312 | am_rx_result_t r;
313 | if (xQueueReceive(g_pkt_queue, &r, pdMS_TO_TICKS(20)) == pdTRUE && handlePacket(r, dst, p.seq)) {
314 | Serial.printf("OK delivered to %d (try %d)\n", dst, attempt);
315 | return;
316 | }
317 | }
318 | Serial.println(" | no reply");
319 | }
320 | if (want_ack) Serial.printf("FAIL no reply from %d\n", dst);
321 | }

322

323 | /* ------------------------------------------------------------------------ */
324 | /* Diagnostics | */
325 | /* ------------------------------------------------------------------------ */
326 | static void printStats() {
327 | xSemaphoreTake(g_rx_lock, portMAX_DELAY);
328 | am_stats_t s = g_rx.stats;
329 | float fs_used = g_rx.fs;
330 | xSemaphoreGive(g_rx_lock);
331 | Serial.printf("STATS node=%d preambles=%lu ok=%lu crc_fail=%lu last_q=%.1fdB timing_adj=%.1f\n",
332 | NODE_ID, (unsigned long)s.preambles, (unsigned long)s.packets_ok,
333 | (unsigned long)s.crc_fail, s.last_q_db, s.last_timing_adj);
334 | Serial.printf("ADC fs_measured=%.1f fs_used=%.1f overflows=%lu clipped=%lu\n",
335 | g_fs_measured, fs_used, (unsigned long)g_adc_overflows, (unsigned long)s.clipped);
336 | Serial.printf("LEVEL mean=%.0f rms=%.1f min=%u max=%u (want rms 20..300, min>100, max<3900)\n",
337 | g_lvl_mean, g_lvl_rms, g_lvl_min, g_lvl_max);
338 | }

339

340 | static void printScope() {
341 | float db[AM_NTONES];
342 | xSemaphoreTake(g_rx_lock, portMAX_DELAY);
343 | memcpy(db, g_rx.scope_db, sizeof(db));
344 | xSemaphoreGive(g_rx_lock);
345 | Serial.print("SCOPE");
346 | for (int i = 0; i < AM_NTONES; i++) Serial.printf(" %d", (int)lrintf(db[i]));
347 | Serial.printf(" | rms=%.0f\n", g_lvl_rms);
348 | }

349

350 | static void doSweep() {
351 | Serial.println("SWEEP: each tone 300 ms. Watch 'scope' on the other vehicle.");
352 | for (int i = 0; i < AM_NTONES; i++) {
353 | uint8_t t[15];
354 | for (int k = 0; k < 15; k++) t[k] = (uint8_t)i;
355 | Serial.printf("SWEEP tone %d = %.0f Hz\n", i, am_tone_hz(i));
356 | playTones(t, 15);
357 | delay(150);
358 | }
359 | }

360

361 | static void doTone(int hz, int ms) {
362 | if (hz < 100 || hz > 20000 || ms < 1 || ms > 5000) {
363 | Serial.println("usage: tone <100..20000 Hz> <1..5000 ms>");
364 | return;
365 | }
366 | heatGuard();
367 | muteRx((uint32_t)ms + MUTE_TAIL_MS);
368 | ampEnable(true);
369 | int64_t t0 = esp_timer_get_time();
370 | uint32_t real = ledcWriteTone(PIN_TX_AUDIO, (uint32_t)hz);
371 | Serial.printf("TONE %d Hz (real %lu Hz) for %d ms\n", hz, (unsigned long)real, ms);
372 | delay(ms);
373 | ledcWrite(PIN_TX_AUDIO, 0);
374 | ampEnable(false);
375 | heatGuardUpdate(t0, esp_timer_get_time());
376 | }

static void printHelp() {

Serial.println("Commands: on|off|toggle|ping [id] ; send <cmd> <arg> [id] ; sweep ; tone <Hz> <ms> ; scope ;

stats ; help");

}

static void handleLine(char *line) {

char *w = strtok(line, " \t");

if (!w) return;

char *a1 = strtok(NULL, " \t"), *a2 = strtok(NULL, " \t"), *a3 = strtok(NULL, " \t");

int id = a1 ? atoi(a1) : PEER_ID;

if (!strcmp(w, "on")) sendCommand(id, CMD_LED_ON, 0);

else if (!strcmp(w, "off")) sendCommand(id, CMD_LED_OFF, 0);

else if (!strcmp(w, "toggle")) sendCommand(id, CMD_LED_TOGGLE, 0);

else if (!strcmp(w, "ping")) sendCommand(id, CMD_PING, 0);

else if (!strcmp(w, "send") && a1 && a2) sendCommand(a3 ? atoi(a3) : PEER_ID, (uint8_t)atoi(a1), (uint8_t)at
oi(a2));

else if (!strcmp(w, "sweep")) doSweep();

else if (!strcmp(w, "tone") && a1 && a2) doTone(atoi(a1), atoi(a2));

else if (!strcmp(w, "scope")) g_scope = !g_scope;

else if (!strcmp(w, "stats")) printStats();

else printHelp();

}

/* ------------------------------------------------------------------------ */

void setup() {

Serial.begin(SERIAL_BAUD);

delay(300);

pinMode(PIN_LED, OUTPUT);

setLed(false);

pinMode(PIN_BUTTON, INPUT_PULLUP);

#if PIN_AMP_ENABLE >= 0

pinMode(PIN_AMP_ENABLE, OUTPUT);

ampEnable(false);

#endif

ledcAttach(PIN_TX_AUDIO, 5000, 10);

ledcWrite(PIN_TX_AUDIO, 0);

for (int i = 0; i < 16; i++) g_last_seq[i] = -1;

g_rx_lock = xSemaphoreCreateMutex();

g_pkt_queue = xQueueCreate(8, sizeof(am_rx_result_t));

am_rx_init(&g_rx, AM_FS_NOMINAL);

if (!startAdc()) {

Serial.println("ERROR: ADC start failed");

for (;;) delay(1000);

}

/* core 0, above Arduino loop priority; it blocks on the ADC most of the time */

xTaskCreatePinnedToCore(rxTask, "amrx", 6144, NULL, 5, NULL, 0);

Serial.printf("\nDUBURI modem node %d ready. Tones %.0f..%.0f Hz, packet %.2f s\n",

NODE_ID, am_tone_hz(0), am_tone_hz(AM_NTONES - 1), AM_TOTAL_SLOTS * AM_T_SLOT);

printHelp();

}

void loop() {

static char line[64];

static int len = 0;

while (Serial.available()) {

char c = (char)Serial.read();

if (c == '\r') continue;

if (c == '\n') {

line[len] = 0;

handleLine(line);

len = 0;

} else if (len < (int)sizeof(line) - 1) {

line[len++] = c;

}

}

static uint32_t btn_ms = 0;

if (digitalRead(PIN_BUTTON) == LOW && millis() - btn_ms > 500) {

btn_ms = millis();

sendCommand(PEER_ID, CMD_LED_TOGGLE, 0);

}

static uint32_t scope_ms = 0;

451 | if (g_scope && millis() - scope_ms > 250) {
452 | scope_ms = millis();
453 | printScope();
454 | }
455 | pollPackets();
456 | delay(2);
457 | }

# firmware/DuburiModem/am_core.h

1 | /*
2 | * am_core.h - DUBURI acoustic modem core (portable C99, no Arduino/ESP32 code).
3 | *
4 | * The same file is compiled into the ESP32 firmware AND into the PC test
5 | * harness (tests/ and sim/), so what we test on the PC is exactly what runs
6 | * on the vehicle.
7 | *
8 | * Signal design (see the PDF guide for the "why"):
9 | * | - 24 tones, 3000 Hz ... 8750 Hz, 250 Hz apart.
10 | * | - Time is cut into 20 ms "slots"; exactly one tone plays per slot.
11 | * | - Preamble: 10 slots, fixed tone pattern (used to find the packet start).
12 | * | - Data: 54 slots. Slot i uses hop-set (i % 6); each hop-set has 4 tones,
13 | * | so one slot carries 2 bits (4-FSK with frequency hopping).
14 | * | - 4 payload bytes + CRC-16 = 48 bits, + 6 zero "tail" bits = 54 bits,
15 | * | protected by a rate-1/2, K=7 convolutional code (the classic 171/133
16 | * | code used by Wi-Fi and space probes) -> 108 coded bits -> 54 slots.
17 | * | - The receiver uses soft-decision Viterbi decoding.
18 | * | - Coded bits are interleaved (spread in time and frequency) so that one
19 | * | faded tone or one noisy slot only damages scattered bits.
20 | */
21 | #ifndef AM_CORE_H
22 | #define AM_CORE_H

23

24 #include <stdint.h>

25

26 | #ifdef __cplusplus
27 | extern "C" {
28 | #endif

29

30 | /* ---------------- Fixed signal parameters (TX and RX must match) -------- */
31 | #define AM_FS_NOMINAL | 50000.0f | /* RX ADC sample rate we ask for (Hz) | */
32 | #define AM_T_SLOT | 0.020f | /* one symbol slot (s) | */
33 | #define AM_T_WIN | 0.016f | /* analysis window inside a slot (s) | */
34 | #define AM_T_HOP | 0.0025f | /* preamble search step (s) | */
35 | #define AM_T_TRACK | 0.001f | /* early/late offset for timing (s) | */

36

37 | #define AM_F0 | 3000.0f | /* lowest tone (Hz) | */
38 | #define AM_DF | 250.0f | /* tone spacing (Hz) | */
39 | #define AM_NTONES | 24 | /* tones 0..23 -> 3000..8750 Hz | */
40 | #define AM_NSETS | 6 | /* frequency-hopping sets | */
41 | #define AM_M | 4 | /* tones per set (2 bits per slot) | */

42

43 | #define AM_PRE_LEN | 10 | /* preamble slots | */
44 | #define AM_PAYLOAD_BYTES | 4
45 | #define AM_FRAME_BYTES | 6 | /* payload + CRC16 | */
46 | #define AM_K | 7 | /* convolutional code constraint length */
47 | #define AM_INFO_BITS | (AM_FRAME_BYTES * 8 + AM_K - 1) | /* 54 incl. tail */
48 | #define AM_CODED_BITS | (2 * AM_INFO_BITS) | /* 108 | */
49 | #define AM_DATA_SLOTS | (AM_CODED_BITS / 2) | /* 54 | */
50 | #define AM_TOTAL_SLOTS | (AM_PRE_LEN + AM_DATA_SLOTS) | /* 64 -> 1.28 s | */

51

52 | /* ---------------- Receiver tuning (validated by sim/run_sim.py) --------- */
53 | #ifndef AM_DET_SCORE_MIN
54 | #define AM_DET_SCORE_MIN | 0.14f | /* preamble score threshold (0..1) | */
55 | #endif
56 | #ifndef AM_DET_MATCH_MIN
57 | #define AM_DET_MATCH_MIN | 5 | /* preamble slots whose tone must win | */
58 | #endif
59 | #ifndef AM_TRACK_ENABLE
60 | #define AM_TRACK_ENABLE | 1 | /* early/late timing tracking on/off | */
61 | #endif

62

63 | /* ---------------- Buffers (sized for Fs up to ~60 kHz) ------------------ */
64 | #define AM_RING | 4096 | /* power of two | */
65 | #define AM_W_MAX | 1024
66 | #define AM_HIST | 128 | /* preamble search history (hops) | */
67 | #define AM_OUTQ | 4 | /* decoded packets waiting to be read | */

68

69 | /* ---------------- Packet ------------------------------------------------ */
70 | #define AM_ADDR_BROADCAST 15
71 | #define AM_FLAG_ACK_REQ | 0x8 | /* sender wants an ACK back | */
72 | #define AM_FLAG_IS_ACK | 0x4 | /* this packet IS an ACK | */

73

74 | typedef struct {
75 | uint8_t dst; | /* 0..15 (15 = everyone) | */
76 | uint8_t src; | /* 0..15 | */
77 | uint8_t seq; | /* 0..15, used to drop repeats | */
78 | uint8_t flags; | /* 0..15, AM_FLAG_* | */
79 | uint8_t cmd; | /* 0..255, your command number | */
80 | uint8_t arg; | /* 0..255, command argument | */
81 | } am_packet_t;

82

83 | /* ---------------- Coding helpers (used by TX and RX) -------------------- */
84 | float | am_tone_hz(int tone_index);
85 | uint16_t am_crc16(const uint8_t *data, int len); | /* CRC-16/CCITT-FALSE */
86 | /* Convolutional code: n info bits -> 2n coded bits (encoder starts in state 0). */
87 | void | am_conv_encode(const uint8_t *bits, int n, uint8_t *coded);
88 | /* Soft Viterbi: llr[2n] (llr>0 means bit=0) -> n bits; assumes zero tail. */
89 | void | am_viterbi(const float *llr, int n, uint8_t *bits);
90 | /* Interleaver: coded bit c (0..107) -> stream position (2*slot + 0 MSB/1 LSB). */
91 | int | am_interleave(int c);
92 | void | am_pack(const am_packet_t *p, uint8_t frame[AM_FRAME_BYTES]);
93 | int | am_unpack(const uint8_t frame[AM_FRAME_BYTES], am_packet_t *p); /* 1 = CRC ok */
94 | extern const uint8_t am_preamble[AM_PRE_LEN];

95

96 | /* ---------------- Transmitter -------------------------------------------
97 | * Fills tones[] with the tone index (0..23) to play in each 20 ms slot.
98 | * The firmware plays am_tone_hz(tones[i]) for slot i.
99 | */
100 | void am_tx_build(const am_packet_t *p, uint8_t tones[AM_TOTAL_SLOTS]);

101

102 | /* ---------------- Receiver ---------------------------------------------- */
103 | enum { AM_ST_SEARCH = 0, AM_ST_PEAK = 1, AM_ST_DECODE = 2 };

104

105 | typedef struct {
106 | uint32_t preambles; | /* preamble detections | */
107 | uint32_t packets_ok; | /* CRC passed | */
108 | uint32_t crc_fail; | /* preamble found but CRC failed | */
109 | uint32_t clipped; | /* ADC samples near 0 or 4095 | */
110 | float | last_q_db; | /* link quality of last packet (dB) | */
111 | float | last_timing_adj; /* samples moved by timing tracker | */
112 | } am_stats_t;

113

114 | typedef struct {
115 | am_packet_t pkt;
116 | float | q_db; | /* median per-slot SNR of the decided tones | */
117 | } am_rx_result_t;

118

119 | typedef struct {
120 | /* configuration derived from the sample rate */
121 | float | fs;
122 | int | W, H, D; | /* window, hop, early/late offset | */
123 | float | S; | /* samples per slot (not an integer) | */
124 | float | coef[AM_NTONES]; | /* Goertzel 2cos(w) | */
125 | float | win[AM_W_MAX]; | /* Hann window | */
126 | int | pre_off[AM_PRE_LEN]; | /* hop offset of each preamble slot | */

127

128 | /* input conditioning */
129 | float | ring[AM_RING];
130 | uint32_t n; | /* total samples received | */
131 | float | dc;
132 | float | xw[AM_W_MAX]; | /* scratch: windowed samples | */

133

134 | /* noise floor per tone (for whitening) */
135 | float | noise[AM_NTONES];
136 | uint32_t noise_init;
137 | float | scope_db[AM_NTONES]; | /* last whitened levels (for debug) | */

138

139 | /* preamble search */
140 | int | state;
141 | uint32_t next_hop;
142 | uint32_t hop_count;
143 | float | hist_frac[AM_HIST][AM_PRE_LEN];
144 | uint8_t | hist_amax[AM_HIST];
145 | uint32_t hist_end[AM_HIST];
146 | float | pk_score[24];
147 | uint32_t pk_end[24];
148 | int | pk_n;

149 | float | pk_best;
150 | int | pk_below;

151

152 | /* decoding */
153 | uint32_t sync_base; | /* sample index of end of last preamble window */
154 | float | sync_frac;
155 | int | slot;
156 | float | llr[AM_CODED_BITS];
157 | float | slot_q[AM_DATA_SLOTS];
158 | float | track_adj;

159

160 | /* mute (while we transmit ourselves) */
161 | uint32_t mute_until;
162 | int | muted;

163

164 | /* output */
165 | am_rx_result_t outq[AM_OUTQ];
166 | int | out_head, out_count;
167 | am_stats_t stats;
168 | } am_rx_t;

169

170 | void am_rx_init(am_rx_t *rx, float fs);
171 | /* Change the sample rate estimate (firmware measures the real ADC rate).
172 | * Ignored while a packet is being decoded; returns 1 if applied. */
173 | int | am_rx_set_fs(am_rx_t *rx, float fs);
174 | /* Feed raw 12-bit ADC samples (0..4095). */
175 | void am_rx_process(am_rx_t *rx, const uint16_t *x, int count);
176 | /* Ignore the next `samples` input samples (use while we transmit). */
177 | void am_rx_mute(am_rx_t *rx, uint32_t samples);
178 | /* Get one decoded packet; returns 1 if there was one. */
179 | int | am_rx_pop(am_rx_t *rx, am_rx_result_t *out);
180 | int | am_rx_state(const am_rx_t *rx);
181 | void am_rx_get_stats(const am_rx_t *rx, am_stats_t *out);

182

183 | /* For ctypes in the PC simulator */
184 | int | am_rx_sizeof(void);

185

186 | #ifdef __cplusplus
187 | }
188 | #endif
189 | #endif /* AM_CORE_H */

# firmware/DuburiModem/am_core.c

1 | /*
2 | * am_core.c - DUBURI acoustic modem core. See am_core.h for the overview.
3 | *
4 | * Only single-precision float math is used (ESP32 has a float FPU but does
5 | * double in software, which is ~10x slower).
6 | */
7 | #include "am_core.h"
8 | #include <math.h>
9 | #include <string.h>

10

11 | #define AM_PI_F | 3.14159265358979f
12 | #define AM_RING_MASK (AM_RING - 1)
13 | #define AM_PEAK_HOPS 14 | /* hops collected after a preamble trigger */
14 | #define AM_NOISE_INIT_HOPS 40 | /* hops averaged for the first noise floor | */
15 | #define AM_NOISE_ALPHA (1.0f / 256.0f)
16 | #define AM_NOISE_CLIP | 8.0f | /* a hop may raise the floor by at most x8 | */
17 | #define AM_LLR_CLAMP | 20.0f

18

19 | /* Preamble: 10 different tones, chosen so that
20 | * | 1. neighbouring slots are far apart in frequency;
21 | * | 2. data slots of another packet can never match more than 2 of the 10
22 | * | slots (their hop sets, tone % 6, do not line up);
23 | * | 3. the echo of a preamble tone is >= 6 slots (120 ms) old before the same
24 | * | hop set is used by a data slot of this packet. */
25 | const uint8_t am_preamble[AM_PRE_LEN] = {0, 14, 6, 22, 9, 17, 4, 21, 5, 11};

26

27 static int32_t sdiff(uint32_t a, uint32_t b) { return (int32_t)(a - b); }

28

29 | float am_tone_hz(int tone_index)
30 | {
31 | return AM_F0 + AM_DF * (float)tone_index;
32 | }

33

34 | /* CRC-16/CCITT-FALSE: poly 0x1021, init 0xFFFF. "123456789" -> 0x29B1 */
35 | uint16_t am_crc16(const uint8_t *data, int len)
36 | {
37 | uint16_t crc = 0xFFFF;
38 | for (int i = 0; i < len; i++) {
39 | crc ^= (uint16_t)data[i] << 8;
40 | for (int b = 0; b < 8; b++)
41 | crc = (crc & 0x8000) ? (uint16_t)((crc << 1) ^ 0x1021) : (uint16_t)(crc << 1);
42 | }
43 | return crc;
44 | }

45

46 | /* ---- Convolutional code, K=7, rate 1/2, generators 171/133 (octal) -------
47 | * Shift register reg = [newest input | 6 older inputs]. Every input bit gives
48 | * two output bits = parity of (reg AND generator). Free distance 10: two
49 | * different messages always differ in at least 10 coded bits. */
50 | #define AM_G0 0x79 | /* 171 octal = 1111001 */
51 | #define AM_G1 0x5B | /* 133 octal = 1011011 */
52 | #define AM_NSTATES 64

53

54 | static int parity7(unsigned v)
55 | {
56 | v ^= v >> 4;
57 | v ^= v >> 2;
58 | v ^= v >> 1;
59 | return (int)(v & 1u);
60 | }

61

62 | void am_conv_encode(const uint8_t *bits, int n, uint8_t *coded)
63 | {
64 | unsigned state = 0; | /* 6 previous inputs */
65 | for (int t = 0; t < n; t++) {
66 | unsigned reg = ((unsigned)(bits[t] & 1) << 6) | state;
67 | coded[2 * t] = (uint8_t)parity7(reg & AM_G0);
68 | coded[2 * t + 1] = (uint8_t)parity7(reg & AM_G1);
69 | state = reg >> 1;
70 | }
71 | }

72

73 | /* Viterbi: keeps, for each of the 64 register states, the best-scoring path
74 | * so far (score = sum of +llr for expected 0 bits, -llr for expected 1 bits).
75 | * At the end the path that finishes in state 0 (because of the zero tail)
76 | * is traced back. */
77 | void am_viterbi(const float *llr, int n, uint8_t *bits)
78 | {
79 | uint64_t dec[AM_INFO_BITS]; | /* chosen predecessor bit per state */
80 | float pm[AM_NSTATES], npm[AM_NSTATES];
81 | if (n > AM_INFO_BITS) n = AM_INFO_BITS;
82 | for (int s = 0; s < AM_NSTATES; s++) pm[s] = -1e30f;
83 | pm[0] = 0.0f;
84 | for (int t = 0; t < n; t++) {
85 | const float l0 = llr[2 * t], l1 = llr[2 * t + 1];
86 | uint64_t d = 0;
87 | for (int ns = 0; ns < AM_NSTATES; ns++) {
88 | unsigned u = (unsigned)ns >> 5; | /* input bit that led here */
89 | float best = -1e30f;
90 | int bestb = 0;
91 | for (int b = 0; b < 2; b++) {
92 | unsigned ps = (((unsigned)ns & 31u) << 1) | (unsigned)b;
93 | unsigned reg = (u << 6) | ps;
94 | float m = pm[ps] + (parity7(reg & AM_G0) ? -l0 : l0) + (parity7(reg & AM_G1) ? -l1 : l1);
95 | if (m > best) { best = m; bestb = b; }
96 | }
97 | npm[ns] = best;
98 | if (bestb) d |= (uint64_t)1 << ns;
99 | }
100 | dec[t] = d;
101 | memcpy(pm, npm, sizeof(pm));
102 | }
103 | unsigned s = 0; | /* zero tail -> end in state 0 */
104 | for (int t = n - 1; t >= 0; t--) {
105 | bits[t] = (uint8_t)(s >> 5);
106 | unsigned b = (unsigned)((dec[t] >> s) & 1u);
107 | s = ((s & 31u) << 1) | b;
108 | }
109 | }

110

111 | void am_pack(const am_packet_t *p, uint8_t frame[AM_FRAME_BYTES])
112 | {
113 | frame[0] = (uint8_t)(((p->dst & 0xF) << 4) | (p->src & 0xF));
114 | frame[1] = (uint8_t)(((p->seq & 0xF) << 4) | (p->flags & 0xF));
115 | frame[2] = p->cmd;
116 | frame[3] = p->arg;
117 | uint16_t crc = am_crc16(frame, AM_PAYLOAD_BYTES);
118 | frame[4] = (uint8_t)(crc >> 8);
119 | frame[5] = (uint8_t)(crc & 0xFF);
120 | }

121

122 | int am_unpack(const uint8_t frame[AM_FRAME_BYTES], am_packet_t *p)
123 | {
124 | uint16_t crc = am_crc16(frame, AM_PAYLOAD_BYTES);
125 | p->dst = frame[0] >> 4;
126 | p->src = frame[0] & 0xF;
127 | p->seq = frame[1] >> 4;
128 | p->flags = frame[1] & 0xF;
129 | p->cmd = frame[2];
130 | p->arg = frame[3];
131 | return (frame[4] == (uint8_t)(crc >> 8)) && (frame[5] == (uint8_t)(crc & 0xFF));
132 | }

133

134 | /* Interleaver. Stream bits 2k (MSB) and 2k+1 (LSB) form slot k's 2-bit value;
135 | * slot k uses hop set k % 6. Coded bit c goes to slot (37*c) mod 54, MSB if
136 | * c < 54 else LSB. Neighbouring coded bits (which the Viterbi decoder needs
137 | * together) land >= 3 slots apart and in different hop sets, so one faded
138 | * frequency or one noise burst only produces scattered errors. */
139 | int am_interleave(int c)
140 | {
141 | int slot = (37 * c) % AM_DATA_SLOTS;
142 | return 2 * slot + (c >= AM_DATA_SLOTS ? 1 : 0);
143 | }

144

145 | static void frame_to_bits(const uint8_t frame[AM_FRAME_BYTES], uint8_t bits[AM_INFO_BITS])
146 | {
147 | for (int i = 0; i < AM_FRAME_BYTES * 8; i++)
148 | bits[i] = (frame[i >> 3] >> (7 - (i & 7))) & 1;

149 | | for (int i = AM_FRAME_BYTES * 8; i < AM_INFO_BITS; i++)
150 | bits[i] = 0; | /* tail */
151 | }

152

153 | void am_tx_build(const am_packet_t *p, uint8_t tones[AM_TOTAL_SLOTS])
154 | {
155 | | uint8_t frame[AM_FRAME_BYTES];
156 | uint8_t info[AM_INFO_BITS];
157 | | uint8_t coded[AM_CODED_BITS];
158 | | uint8_t stream[AM_CODED_BITS];

159

160 | am_pack(p, frame);
161 | frame_to_bits(frame, info);
162 | | am_conv_encode(info, AM_INFO_BITS, coded);
163 | | for (int c = 0; c < AM_CODED_BITS; c++)
164 | | stream[am_interleave(c)] = coded[c];

165

166 | | for (int i = 0; i < AM_PRE_LEN; i++)
167 | | tones[i] = am_preamble[i];
168 | | for (int k = 0; k < AM_DATA_SLOTS; k++) {
169 | | int v = (stream[2 * k] << 1) | stream[2 * k + 1];
170 | | tones[AM_PRE_LEN + k] = (uint8_t)((k % AM_NSETS) + AM_NSETS * v);
171 | }
172 | }

173

174 | /* ======================================================================= */
175 | /* | Receiver | */
176 | /* ======================================================================= */

177

178 | static void rx_configure(am_rx_t *rx, float fs)
179 | {
180 | rx->fs = fs;
181 | | rx->W = (int)lrintf(AM_T_WIN * fs);
182 | | if (rx->W > AM_W_MAX) rx->W = AM_W_MAX;
183 | | rx->H = (int)lrintf(AM_T_HOP * fs);
184 | | rx->D = (int)lrintf(AM_T_TRACK * fs);
185 | rx->S = AM_T_SLOT * fs;
186 | | for (int n = 0; n < rx->W; n++)
187 | rx->win[n] = 0.5f - 0.5f * cosf(2.0f * AM_PI_F * ((float)n + 0.5f) / (float)rx->W);
188 | | for (int k = 0; k < AM_NTONES; k++)
189 | | rx->coef[k] = 2.0f * cosf(2.0f * AM_PI_F * am_tone_hz(k) / fs);
190 | | for (int j = 0; j < AM_PRE_LEN; j++)
191 | rx->pre_off[j] = (int)lrintf((float)(AM_PRE_LEN - 1 - j) * rx->S / (float)rx->H);
192 | }

193

194 | static void rx_reset_search(am_rx_t *rx)
195 | {
196 | rx->state = AM_ST_SEARCH;
197 | rx->hop_count = 0;
198 | rx->pk_n = 0;
199 | | rx->next_hop = rx->n + (uint32_t)rx->H;
200 | }

201

202 | void am_rx_init(am_rx_t *rx, float fs)
203 | {
204 | memset(rx, 0, sizeof(*rx));
205 | rx_configure(rx, fs);
206 | rx->dc = -1.0f; | /* "not started": first sample sets it */
207 | rx_reset_search(rx);
208 | }

209

210 | int am_rx_set_fs(am_rx_t *rx, float fs)
211 | {
212 | | if (rx->state != AM_ST_SEARCH || fs < 20000.0f || fs > 62000.0f)
213 | return 0;
214 | rx_configure(rx, fs);
215 | rx_reset_search(rx);
216 | return 1;
217 | }

218

219 | int am_rx_sizeof(void) { return (int)sizeof(am_rx_t); }
220 | int am_rx_state(const am_rx_t *rx) { return rx->state; }
221 | void am_rx_get_stats(const am_rx_t *rx, am_stats_t *out) { *out = rx->stats; }

222

223 | void am_rx_mute(am_rx_t *rx, uint32_t samples)
224 | {

rx->mute_until = rx->n + samples;

rx->muted = 1;

227 | rx->state = AM_ST_SEARCH; | /* abandon anything half-received */

}

int am_rx_pop(am_rx_t *rx, am_rx_result_t *out)

{

if (rx->out_count == 0) return 0;

*out = rx->outq[rx->out_head];

rx->out_head = (rx->out_head + 1) % AM_OUTQ;

rx->out_count--;

return 1;

}

/* Goertzel energy of `nt` tones over the W samples that end at sample `end`. */

static void rx_energies(am_rx_t *rx, uint32_t end, const uint8_t *tones, int nt, float *E)

{

const int W = rx->W;

uint32_t start = end - (uint32_t)W;

for (int i = 0; i < W; i++)

rx->xw[i] = rx->ring[(start + (uint32_t)i) & AM_RING_MASK] * rx->win[i];

for (int t = 0; t < nt; t++) {

const float c = rx->coef[tones[t]];

float s1 = 0.0f, s2 = 0.0f;

for (int i = 0; i < W; i++) {

float s0 = rx->xw[i] + c * s1 - s2;

s2 = s1;

s1 = s0;

}

E[t] = s1 * s1 + s2 * s2 - c * s1 * s2 + 1e-3f;

}

}

static const uint8_t all_tones[AM_NTONES] = {

0, 1, 2, 3, 4, 5, 6, 7, 8, 9, 10, 11, 12, 13, 14, 15, 16, 17, 18, 19, 20, 21, 22, 23};

static void rx_finish_peak(am_rx_t *rx);

static void rx_decode_slot(am_rx_t *rx);

static uint32_t rx_slot_end(const am_rx_t *rx, int slot)

{

return rx->sync_base + (uint32_t)(int32_t)lrintf(rx->sync_frac + rx->track_adj + (float)(slot + 1) * rx->
S);

}

/* One preamble-search step: called every H samples. */

static void rx_hop(am_rx_t *rx)

{

float E[AM_NTONES], z[AM_NTONES];

rx_energies(rx, rx->n, all_tones, AM_NTONES, E);

/* Noise floor per tone. Learned only while nothing is being received. */

if (rx->state == AM_ST_SEARCH) {

if (rx->noise_init < AM_NOISE_INIT_HOPS) {

float k = 1.0f / (float)(rx->noise_init + 1);

for (int i = 0; i < AM_NTONES; i++)

rx->noise[i] += (E[i] - rx->noise[i]) * k;

rx->noise_init++;

rx->next_hop += (uint32_t)rx->H;

return;

}

for (int i = 0; i < AM_NTONES; i++) {

float e = E[i];

if (e > AM_NOISE_CLIP * rx->noise[i]) e = AM_NOISE_CLIP * rx->noise[i];

rx->noise[i] += (e - rx->noise[i]) * AM_NOISE_ALPHA;

}

}

/* Whitening: each tone compared with its own noise floor. */

float sum = 0.0f, zmax = 0.0f;

int amax = 0;

for (int i = 0; i < AM_NTONES; i++) {

z[i] = E[i] / rx->noise[i];

rx->scope_db[i] = 10.0f * log10f(z[i]);

sum += z[i];

if (z[i] > zmax) { zmax = z[i]; amax = i; }

}

int hi = (int)(rx->hop_count % AM_HIST);

for (int j = 0; j < AM_PRE_LEN; j++)

rx->hist_frac[hi][j] = z[am_preamble[j]] / sum;

rx->hist_amax[hi] = (uint8_t)amax;

rx->hist_end[hi] = rx->n;

if (rx->hop_count >= (uint32_t)rx->pre_off[0]) {

float score = 0.0f;

int match = 0;

for (int j = 0; j < AM_PRE_LEN; j++) {

int h = (int)((rx->hop_count - (uint32_t)rx->pre_off[j]) % AM_HIST);

score += rx->hist_frac[h][j];

match += (rx->hist_amax[h] == am_preamble[j]);

}

score *= 1.0f / (float)AM_PRE_LEN;

if (rx->state == AM_ST_SEARCH && score >= AM_DET_SCORE_MIN && match >= AM_DET_MATCH_MIN) {

rx->state = AM_ST_PEAK;

rx->pk_n = 0;

}

if (rx->state == AM_ST_PEAK) {

rx->pk_score[rx->pk_n] = score;

rx->pk_end[rx->pk_n] = rx->n;

rx->pk_n++;

}

}

rx->hop_count++;

rx->next_hop += (uint32_t)rx->H;

if (rx->state == AM_ST_PEAK && rx->pk_n >= AM_PEAK_HOPS)

rx_finish_peak(rx);

}

/* The score is flat-topped around the true start; use the centre of the top. */

static void rx_finish_peak(am_rx_t *rx)

{

int m = 0;

for (int i = 1; i < rx->pk_n; i++)

if (rx->pk_score[i] > rx->pk_score[m]) m = i;

float top = rx->pk_score[m];

float lim = 0.85f * top;

int l = m, r = m;

while (l > 0 && rx->pk_score[l - 1] >= lim) l--;

while (r < rx->pk_n - 1 && rx->pk_score[r + 1] >= lim) r++;

float base = 0.7f * top, wsum = 0.0f, isum = 0.0f;

for (int i = l; i <= r; i++) {

float w = rx->pk_score[i] - base;

wsum += w;

isum += w * (float)(i - l);

}

float c = (wsum > 0.0f) ? isum / wsum : 0.0f;

rx->sync_base = rx->pk_end[l];

rx->sync_frac = c * (float)rx->H;

rx->track_adj = 0.0f;

rx->slot = 0;

rx->state = AM_ST_DECODE;

rx->stats.preambles++;

rx->next_hop = rx_slot_end(rx, 0) + (uint32_t)rx->D;

}

static float maxf(float a, float b) { return a > b ? a : b; }

static void rx_finish_packet(am_rx_t *rx)

{

float cl[AM_CODED_BITS];

uint8_t info[AM_INFO_BITS];

uint8_t frame[AM_FRAME_BYTES] = {0};

for (int c = 0; c < AM_CODED_BITS; c++)

cl[c] = rx->llr[am_interleave(c)];

am_viterbi(cl, AM_INFO_BITS, info);

for (int i = 0; i < AM_FRAME_BYTES * 8; i++)

frame[i >> 3] |= (uint8_t)(info[i] << (7 - (i & 7)));

/* median of per-slot quality (insertion sort, 48 values) */

float q[AM_DATA_SLOTS];

memcpy(q, rx->slot_q, sizeof(q));

for (int i = 1; i < AM_DATA_SLOTS; i++) {

float v = q[i];

int j = i - 1;

while (j >= 0 && q[j] > v) { q[j + 1] = q[j]; j--; }

q[j + 1] = v;

}

float qmed = 0.5f * (q[AM_DATA_SLOTS / 2 - 1] + q[AM_DATA_SLOTS / 2]);

am_packet_t p;

if (am_unpack(frame, &p)) {

rx->stats.packets_ok++;

rx->stats.last_q_db = qmed;

rx->stats.last_timing_adj = rx->track_adj;

if (rx->out_count < AM_OUTQ) {

int idx = (rx->out_head + rx->out_count) % AM_OUTQ;

rx->outq[idx].pkt = p;

rx->outq[idx].q_db = qmed;

rx->out_count++;

}

} else {

rx->stats.crc_fail++;

}

rx_reset_search(rx);

}

static void rx_decode_slot(am_rx_t *rx)

{

const int i = rx->slot;

const int set = i % AM_NSETS;

uint8_t tones[AM_M];

float Ec[AM_M], Ee[AM_M], El[AM_M], z[AM_M], lz[AM_M];

for (int v = 0; v < AM_M; v++)

tones[v] = (uint8_t)(set + AM_NSETS * v);

uint32_t e = rx_slot_end(rx, i);

rx_energies(rx, e, tones, AM_M, Ec);

int vhat = 0;

for (int v = 0; v < AM_M; v++) {

z[v] = Ec[v] / rx->noise[tones[v]];

lz[v] = logf(z[v]);

if (z[v] > z[vhat]) vhat = v;

}

422 | float l1 = maxf(lz[0], lz[1]) - maxf(lz[2], lz[3]); | /* MSB: 0 for v=0,1 */
423 | float l0 = maxf(lz[0], lz[2]) - maxf(lz[1], lz[3]); | /* LSB: 0 for v=0,2 */
| if (l1 > AM_LLR_CLAMP) l1 = AM_LLR_CLAMP;
| if (l1 < -AM_LLR_CLAMP) l1 = -AM_LLR_CLAMP;
| if (l0 > AM_LLR_CLAMP) l0 = AM_LLR_CLAMP;
| if (l0 < -AM_LLR_CLAMP) l0 = -AM_LLR_CLAMP;
| rx->llr[2 * i] = l1;
| rx->llr[2 * i + 1] = l0;

rx->slot_q[i] = 10.0f * log10f(maxf(z[vhat] - 1.0f, 1e-3f));

#if AM_TRACK_ENABLE

/* Early/late gate: if the window shifted 1 ms later catches more of the

* winning tone than the one shifted 1 ms earlier, we are a bit early. */

if (z[vhat] > 4.0f) {

uint8_t tv = tones[vhat];

rx_energies(rx, e - (uint32_t)rx->D, &tv, 1, Ee);

rx_energies(rx, e + (uint32_t)rx->D, &tv, 1, El);

float err = (El[0] - Ee[0]) / (El[0] + Ee[0]);

rx->track_adj += 0.25f * (float)rx->D * err;

float lim = 0.25f * rx->S;

if (rx->track_adj > lim) rx->track_adj = lim;

if (rx->track_adj < -lim) rx->track_adj = -lim;

}

#else

(void)Ee;

(void)El;

#endif

rx->slot++;

if (rx->slot >= AM_DATA_SLOTS)

rx_finish_packet(rx);

else

rx->next_hop = rx_slot_end(rx, rx->slot) + (uint32_t)rx->D;

}

void am_rx_process(am_rx_t *rx, const uint16_t *x, int count)

{

for (int k = 0; k < count; k++) {

uint16_t raw = x[k];

if (raw <= 8 || raw >= 4087) rx->stats.clipped++;

float xf = (float)raw;

if (rx->dc < 0.0f) rx->dc = xf;

rx->dc += (xf - rx->dc) * (1.0f / 1024.0f);

rx->ring[rx->n & AM_RING_MASK] = xf - rx->dc;

rx->n++;

if (rx->muted) {

if (sdiff(rx->n, rx->mute_until) < 0) continue;

rx->muted = 0;

rx_reset_search(rx);

continue;

}

while (sdiff(rx->n, rx->next_hop) >= 0) {

if (rx->state == AM_ST_DECODE) rx_decode_slot(rx);

else rx_hop(rx);

}

}

}

#ifdef AM_SIM

/* PC simulator only: copy out the soft bits and slot qualities of the last packet. */

void am_rx_debug(const am_rx_t *rx, float llr[AM_CODED_BITS], float slot_q[AM_DATA_SLOTS], float *track_adj)

{

memcpy(llr, rx->llr, sizeof(rx->llr));

memcpy(slot_q, rx->slot_q, sizeof(rx->slot_q));

*track_adj = rx->track_adj;

}

#endif
