jarifalamclaude-max/DUBURI_IVC/sim/results/packet_plan.png

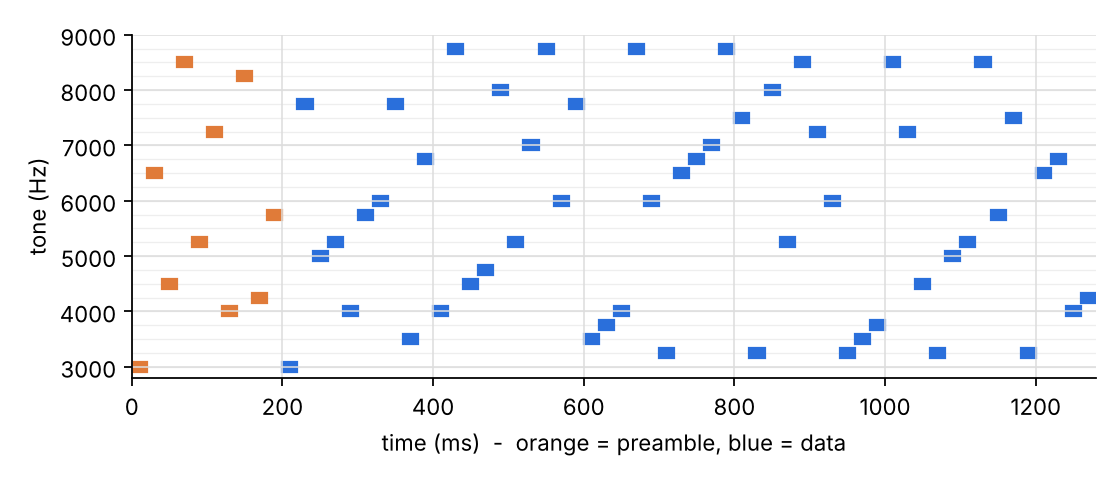
sim/results/packet_plan.png
