jarifalamclaude-max/DUBURI_IVC/sim/results/pool_echo_decay.png

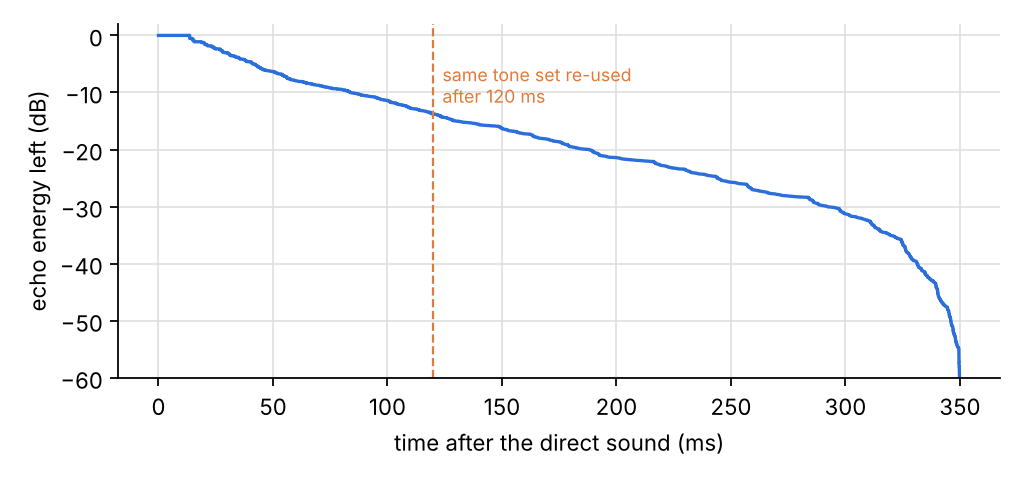
sim/results/pool_echo_decay.png
