jarifalamclaude-max/DUBURI_IVC/sim/results/q_vs_snr.png

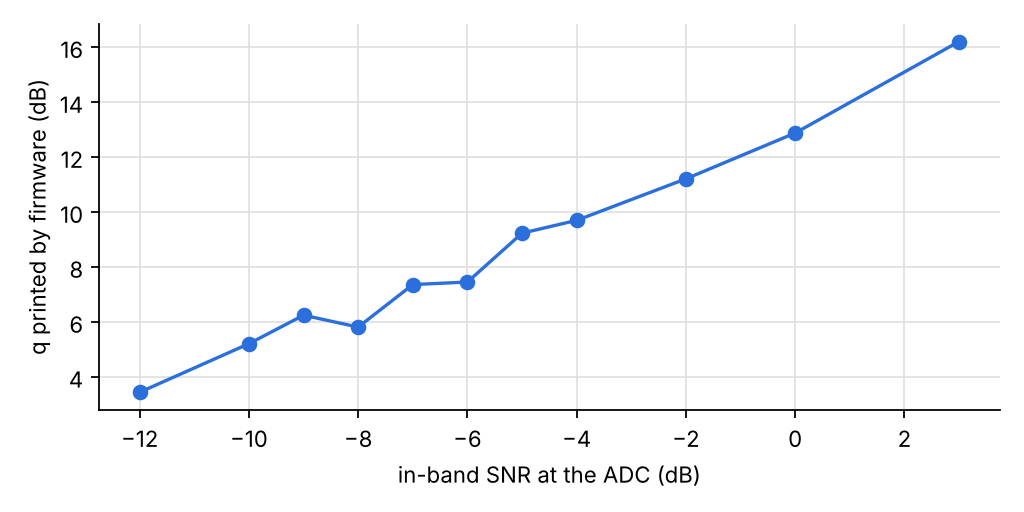
sim/results/q_vs_snr.png
