jarifalamclaude-max/DUBURI_IVC/sim/results/success_vs_snr.png

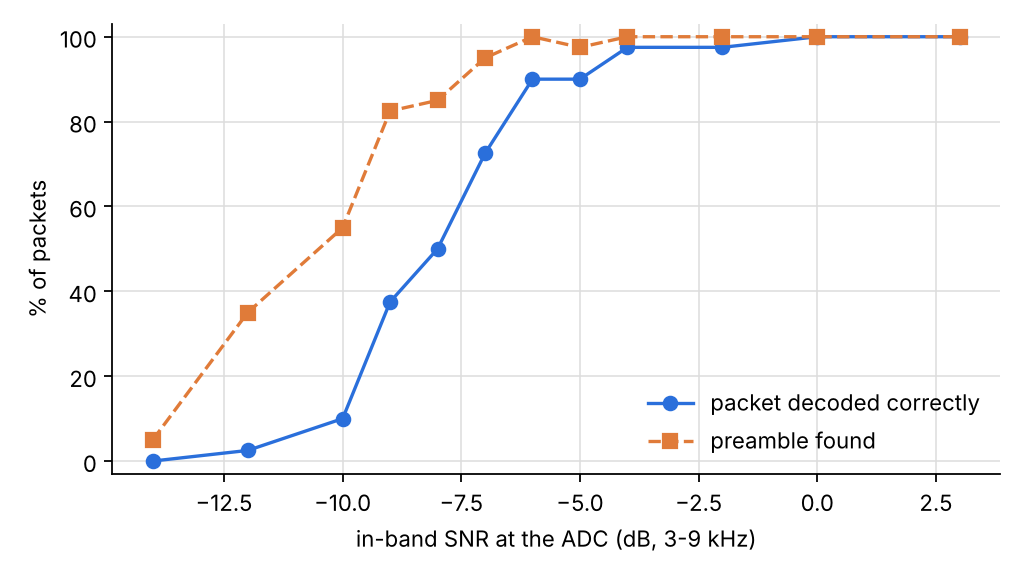
sim/results/success_vs_snr.png
